Jonahss/openav1/docs/frame-state.md

# Frame state on the card (the frame-to-frame state machine)

2026-10-30. Jonah, on seeing that an inter stream on the U200 runs at the Python model's speed: "an inter frame decodes
on the card but python on the cpu is passing the outputs of one frame to the next and holding state. let's clean that up."
This note is the census of that state, the design that moves it onto the card, and the staged plan.

## 1. What the host hands the card per frame today (tb/host_regs.py decode_frames_inter)

| State (spec) | Produced by | Handed over as | Size at 1080p |
|---|---|---|---|
| CDF tables the frame starts with: load_cdfs(ref_frame_idx[primary_ref_frame]) with the counts zeroed (8.2) | the model's SequenceState: the CDFs saved by the frame that refreshed that slot (the tile context_update_tile_id's final CDFs, or the frame's initial ones if disable_frame_end_update_cdf) | DEF_ADDR/DEF_DATA, 1,269 rows x 246 bits, once per tile row | 40 KB |
| PrevSegmentIds: load_previous_segment_ids (7.20) | the model: the slot's saved map (per 4x4; verbatim copy of the previous map when segmentation_update_map = 0) | SP_ADDR/SP_DATA0/1 band writes, 16 ids per 48-bit word | 480 x 270 x 3 bits = 47 KB |
| MotionFieldMvs[ref][y8][x8]: motion_field_estimation (7.9) | the model: projection of up to 5 source slots' saved MVs (7.19: one {ref, mv} per 8x8 from the odd 4x4, first list with a negative relative distance and |mv| <= 4095) | MF_ADDR/MF_DATA entry writes | 7 refs x 240 x 135 entries |
| Reference pictures and their sizes / scales | the card's own flushed pictures in DDR (the model only for frames the image cannot take) | slot table 0x400.., REF_SLOT | addresses |
| OrderHints, refresh flags, segmentation flags | the frame headers (obu_parser) | header registers (ihdr_t) | - |

Only the first three need the model, and only because the card keeps no record of a finished frame beyond its pixels:
mv_mem and mi_store are superblock-row bands that the next rows overwrite, and the adapted CDFs stay inside the engine
that produced them. The pixels are the card's; the memory of the frame is the host's.

## 2. Design: the frame's state lives in DDR next to its picture, written and read by the card

A reference slot in DDR becomes {picture planes, MV sideband, segment-id sideband, CDF rows}. The host keeps only the
slot table (addresses, sizes, order hints), which it derives from the frame headers; nothing on the host decodes.

**Writers (frame end, per superblock row, as the syntax stage finishes it):**
- *MV sideband*: one 32-bit word per 8x8 {ref[2:0] (0 = none), mv_row[12:0], mv_col[12:0]} = the spec's
  MfRefFrames/MfMvs of 7.19, decided at write time from the block's (ref0, mv0) / (ref1, mv1): the first list whose
  reference has a negative relative distance (a 7-bit per-frame mask from the host, `ref_dist_neg`, in ihdr_t) and
  |mv| <= REFMVS_LIMIT. Captured from the mv_mem area fill at the odd 4x4 (2*y8+1, 2*x8+1) into a double-buffered
  superblock-row buffer (1080p: 8 x 240 words = 7.5 KB per row), DMA'd to the slot's MV area when the row is done.
- *Segment-id sideband*: 16 ids per 48-bit word (the seg_band word), from the block area fill; when
  segmentation_enabled && !segmentation_update_map the source is the previous map (seg_band) instead (test10147's rule).
- *CDF rows*: at tile_done of the frame, engine context_update_tile_id's cdf_store rows (1,269 x 32 B) to the slot's CDF
  area; with disable_frame_end_update_cdf the engine's def_mem (the frame's starting rows) instead.
All three go through the existing AXI write master in dec_host (the flush engine gains two requesters besides released
picture rows: "sideband row ready" and "CDF save").

**Loaders (frame start, driven by the sequencer like ref_fetch):**
- *CDF loader*: the primary slot's CDF area -> def_we rows into every engine, the count field of each row zeroed.
- *Segment-map loader*: the primary slot's seg area -> seg_band, one superblock row ahead of the syntax stage.
- *Motion-field projection engine* (7.9): for each source slot (LAST, BWDREF, ALTREF2, ALTREF, LAST2 by the spec's
  order and refStamp rule), read its MV sideband for the current 64-pixel row band (projection never leaves the band:
  MAX_OFFSET_HEIGHT = 0; columns move at most 8 x 8 px), project each entry with Div_Mult[refOffset] (a 32-entry ROM),
  clip, and write mf_band[dst][y8][x8] for the 7 destinations. 1080p: 1,920 entries x 5 sources x 7 destinations
  = 67 k operations per superblock row, one per cycle, against a ~370 k-cycle row decode: it runs a row ahead.
All reads go through the AXI read channels ref_fetch owns today (a second requester on its arbiter).

**Host after this:** parse headers, keep the slot table (a pool allocation with the refresh/show_existing rules of 7.20
and 7.21 as address bookkeeping), write ihdr/hdr registers, push bytes, collect pictures. tb/seq_model.py stays as the
model of what the card now does, and tb/test_dec_host_inter.py compares the card's sideband and CDF areas with it.

## 3. Stages and estimates (from the ring memory + flush and ref_fetch, each ~1 day of my own work)

- **Stage A (~2 days): the card writes, the host moves.** Sideband writers + CDF save/load through DDR; the host reads
  the sideband back over PCIe, runs the projection (seq_model.motion_field_estimation on the card's saved MVs, no tile
  decoding) and writes mf_band/seg_band as today. The model leaves the loop; inter streams run at card speed minus one
  PCIe round trip per frame. Verified by the twin (sideband == the model's saved arrays, CDF area == the model's saved
  CDFs), then gate replay, then the card image.
- **Stage B (~2.5 days): the card loads.** Segment-map loader, CDF loader, the projection engine; the host writes no
  bands. Same ladder.
- Stage A is realistic before the symposium (2026-11-04); Stage B is more likely the week after. The deck says which.

## 4. Stage B as built (2026-10-30 evening) and the projection engine's design

Built: `rtl/fs_load.sv` (segment map and CDF rows from the slot's areas into the bands, zero-map mode; START bit 6,
registers 0x700-0x714) and the CDF save in `dec_host.sv` (engine SV_ENG's rows through the read-back port to SV_CDF,
START bit 7). The twin's `TS_FSTATE_B=1` mode exercises both: the host writes no rows and no map. The read channel is
muxed between the loader and ref_fetch (the loader runs before the first tile, so the two never overlap).

**The projection engine (7.9), the last block.** The host already computes every distance the process needs (they are
functions of the order hints alone), so the engine takes a table, not the rules:
- per frame: `MF_DST[1..7]` = refToDst for each destination (signed 8), `MF_W8/H8` (from hdr), `MF_SRC_N` (0..5 sources
  in the spec's order: LAST, BWDREF, ALTREF2, ALTREF, LAST2 with the refStamp rule applied by the host; a source whose
  saved frame is intra, of another size, or whose distances fail the test is simply left out);
- per source s: `MF_SRC_BASE/ROWB` (the slot's MV area), `MF_SRC_SIGN` (dstSign), `MF_SRC_TOCUR` (refToCur, signed),
  `MF_SRC_OFF[1..7]` (refOffset for each saved reference, signed; the engine tests |x| <= 31 and > 0 itself).
- the job: clear the field (every (dst, y8, x8) invalid: w8 x h8 x 7 writes; 1080p 227 k cycles, 2.3 ms; a per-row
  valid bitmap would remove it later), then for each source in order read its MV area line by line and, per word,
  if ref != 0 and the distance test passes: projMv = mv_projection(mv, refToCur * sign, refOffset); (PosY8, PosX8) from
  block_position (row offsets never leave the 64-pixel band; columns within 8 units); if valid, write
  mf[dst][PosY8][PosX8] = mv_projection(mv, refToDst[dst], refOffset) for dst = 1..7, seven writes a cell (one
  multiplier per destination, Div_Mult a 32-entry ROM, round2signed and the clips in logic). Raster order, so a later
  cell's write wins at a shared target, as the scalar code and _project_np do.
- cost: reads 1080p: 5 sources x 32 k words = 160 k beats; writes up to 7 per valid cell; at one cell a cycle the
  whole field is ~0.5 M cycles worst case, 5 ms at 100 MHz, overlapping nothing today (it runs before the first tile)
  and later the previous frame's filters.
- verification: the twin in B mode stops writing the motion field; the pictures stay identical (every temporal
  candidate goes through this band), and a read-back path for mf_band compares the field with _project_np directly.

## 5. The host path for stage B (2026-10-31, `decode.py --card-load`)

`decode_frames_inter(card_load=True)` (implies `card_state`) is stage A's loop with the per-frame state traffic
removed. The host keeps only the slot table: for each of the 8 slots, the header fields the projection table needs
(`mf_table`: frame type, size, order hints) and `Slot.areas` = where the card keeps that frame's state (its MV and
segment-id sideband areas, its saved CDF rows, or `('defaults', base_q_idx)` for a frame that disabled the frame-end
update and started from defaults). Per frame:

1. `start_frame_load`: the primary reference slot's areas decide the loader's job (segment map if the frame uses
   segmentation and the slot's map is its size, else a zero map for inter frames; the CDF rows unless the slot holds
   defaults, which the host writes as before, `rows=M.default_rows(q)`); `mf_table` builds the projection table from
   the order hints (empty for a frame without a usable source, which still clears the band).
2. `frame_state_load`: frame header registers (the loader and the engine take `mi_rows` / `mi_cols` from `HDR`), the
   LD / MF registers, START bit 6, poll `FS_STATUS` bit 3. Then the reference table, DMA + sideband registers and the
   pipelined frame start as in stage A; the tile rows run with `rows=False` (no CDF writes).
3. After the context tile's row: `frame_state_save` (SV registers, START bit 7, poll bit 6) into the frame's own CDF
   area (`fs_layout` puts it behind the segment ids), unless `disable_frame_end_update_cdf`.
4. Frame end: wait for the sideband DMA, `end_frame_load` records the areas for the refreshed slots with 7.20's two
   rules (a verbatim-kept segment map and a disabled CDF update both pass the primary slot's area on).
   Because areas are passed on, a slot can name areas inside another frame's buffer: the flush target is a buffer
   no live slot holds *either the picture or the state areas of* (2026-11-01: test5439 frame 8 took frame 0's buffer and
   saved its rows over the areas slots 0-6 still named; frame 9 then loaded frame 8's state, 1,604 samples off by one).

Register traffic per 1080p inter frame drops from ~500 k writes (motion-field band 227 k, CDF rows 13.5 k, segment map
8 k, plus the 1501-row read-back) to the frame's own headers and ~40 loader / table words. The stage A path
(`--card-state`) stays as the fallback and the cross-check: both must produce identical pictures.

## 6. The loader group's throughput (2026-11-03)

The 1080p measurement (`docs/reference-prefetch.md` §3) found the stage B loader group past 460k cycles a frame:
5 ms at 100 MHz, 15 % of a 33 ms frame, all of it before the first tile. Three terms, all in the first version of
the engines:

- the field clear wrote one entry a cycle: 7 x w8 x h8 = 227k cycles at 1080p;
- each valid cell took 11 cycles (test, projection, position, seven destination writes one after another): up to
  356k cycles a source when most cells carry a reference;
- the reads of both engines went one burst at a time: ~64 cycles per 16 beats at the card's latency, 65k cycles a
  source for the MV words, the same for a 1080p segment map (16k beats).

What changed:

- `mf_band` holds one memory per reference (`we[6:0]`, `w_row` / `w_col` per reference), so one write touches every
  reference of a position: the host's register path writes one (`we = 1 << ref`), the engine all seven. Same BRAM.
- `mf_project` clears the field at one position a cycle (w8 x h8 = 32k cycles at 1080p) and starts with `ld_start`, so
  the clear overlaps `fs_load`'s reads (`src_go = !fsl_busy` holds its reads until the channel is free; `dec_top`
  muxes the read channel fs_load → engine → ref_fetch). The reads run `OUT = 8` bursts ahead into a 32-beat FIFO
  whose room is reserved at issue (`rready` never drops). The cells go through a six-stage pipeline at one a cycle:
  the source's constants and posValid; K = clip3(-31, 31, num) x Div_Mult[den] for the current frame and the seven
  destinations (the product is associative, so this is the spec's arithmetic exactly); the sixteen products mv x K;
  round2signed and the clip; block_position; the seven-reference write. Raster order is kept, so a later cell still
  wins at a shared target.
- `fs_load` issues up to `OUT = 8` bursts ahead through a descriptor queue `{job, line, first beat}`; the data side
  takes the in-order beats straight into the bands, as before.

Expected at 1080p with 48-cycle reads: clear 32k (hidden behind the segment map / CDF load), ~16k + 32k cycles a
source (reads, then cells; the two overlap), segment map ~17k, CDF rows ~6k: a P-frame with one source ~60k
cycles, 0.6 ms, from ~500k. `test_dec_host_inter` reports the loader group's wait as `ld_cycles` in its summary.
