Jonahss/openav1/docs/checkpoints/C10-layout.png

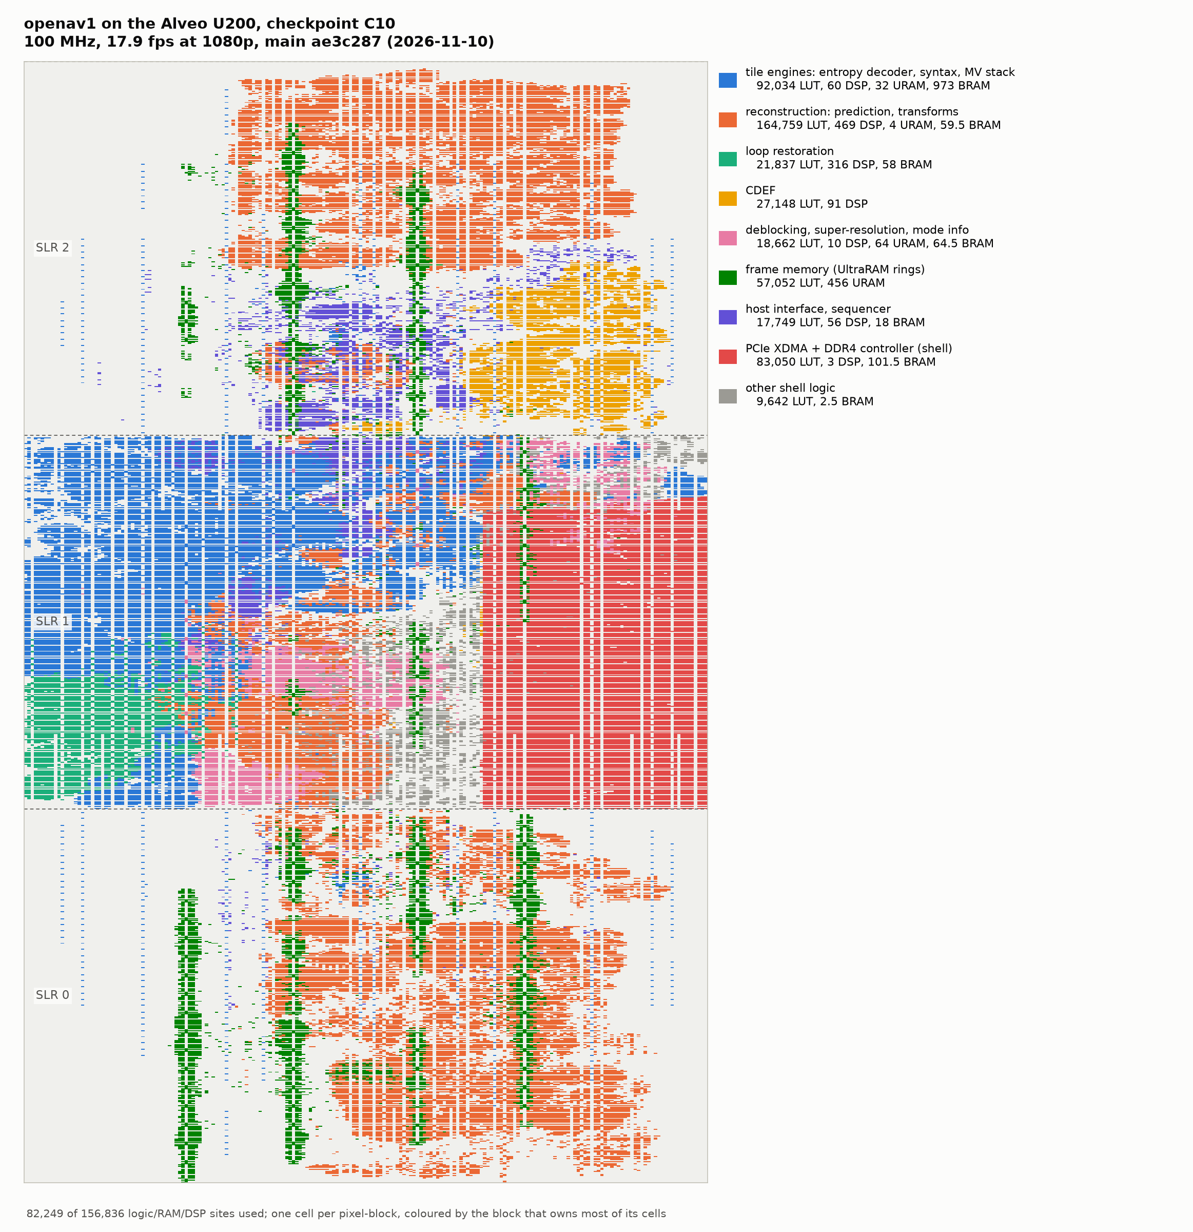
docs/checkpoints/C10-layout.png
