Jonahss/openav1/docs/checkpoints/C11-layout.png

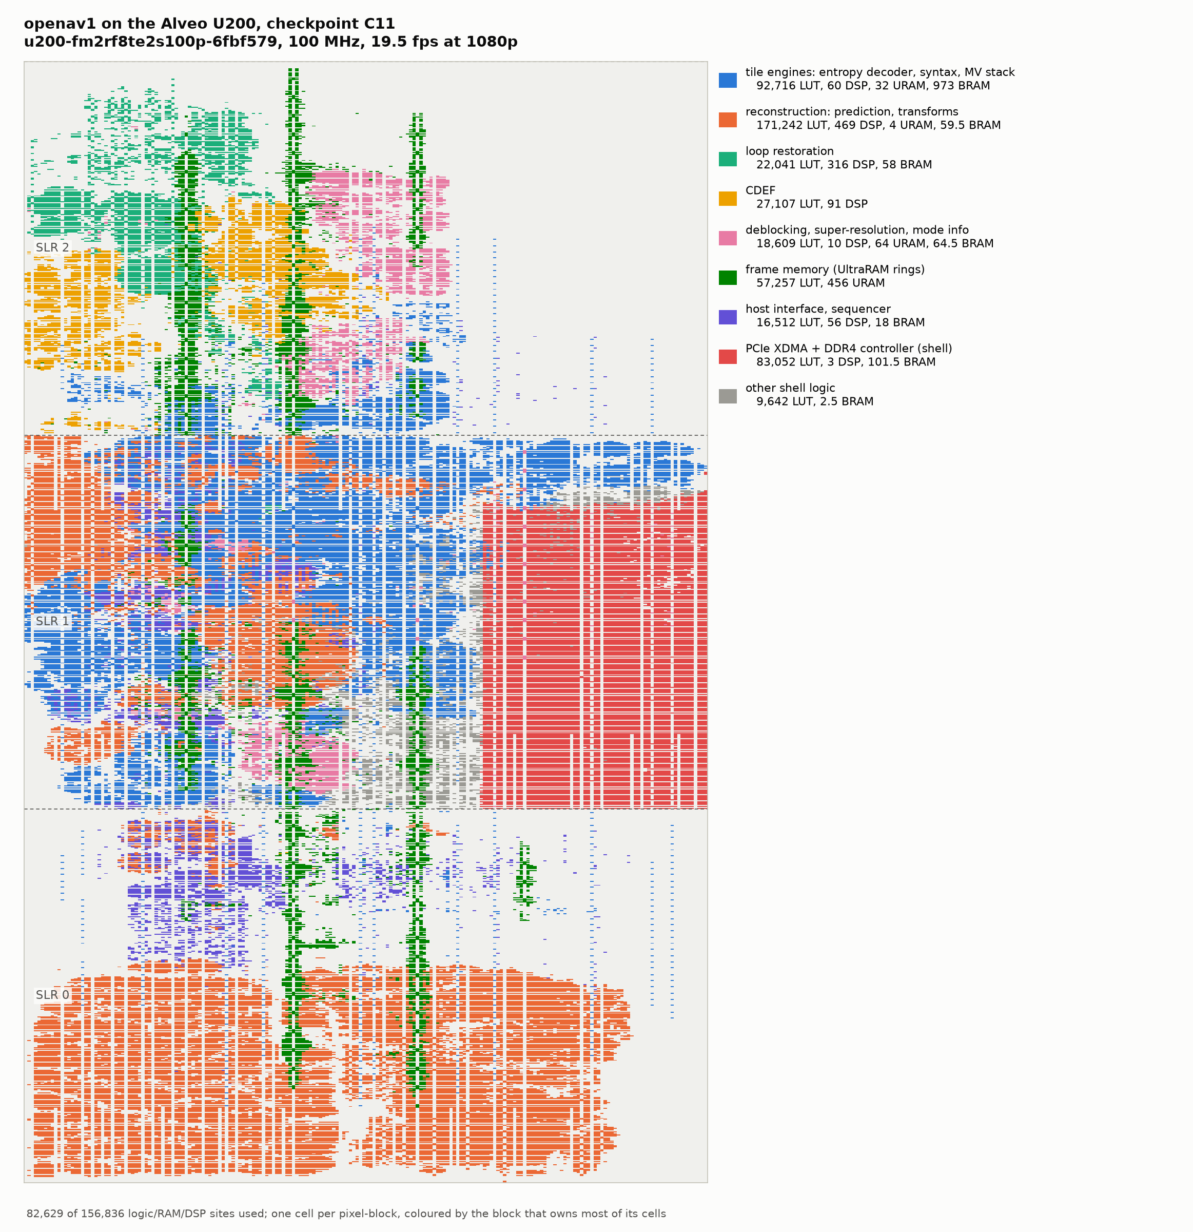
docs/checkpoints/C11-layout.png
