Jonahss/openav1/docs/checkpoints/C12-layout.png

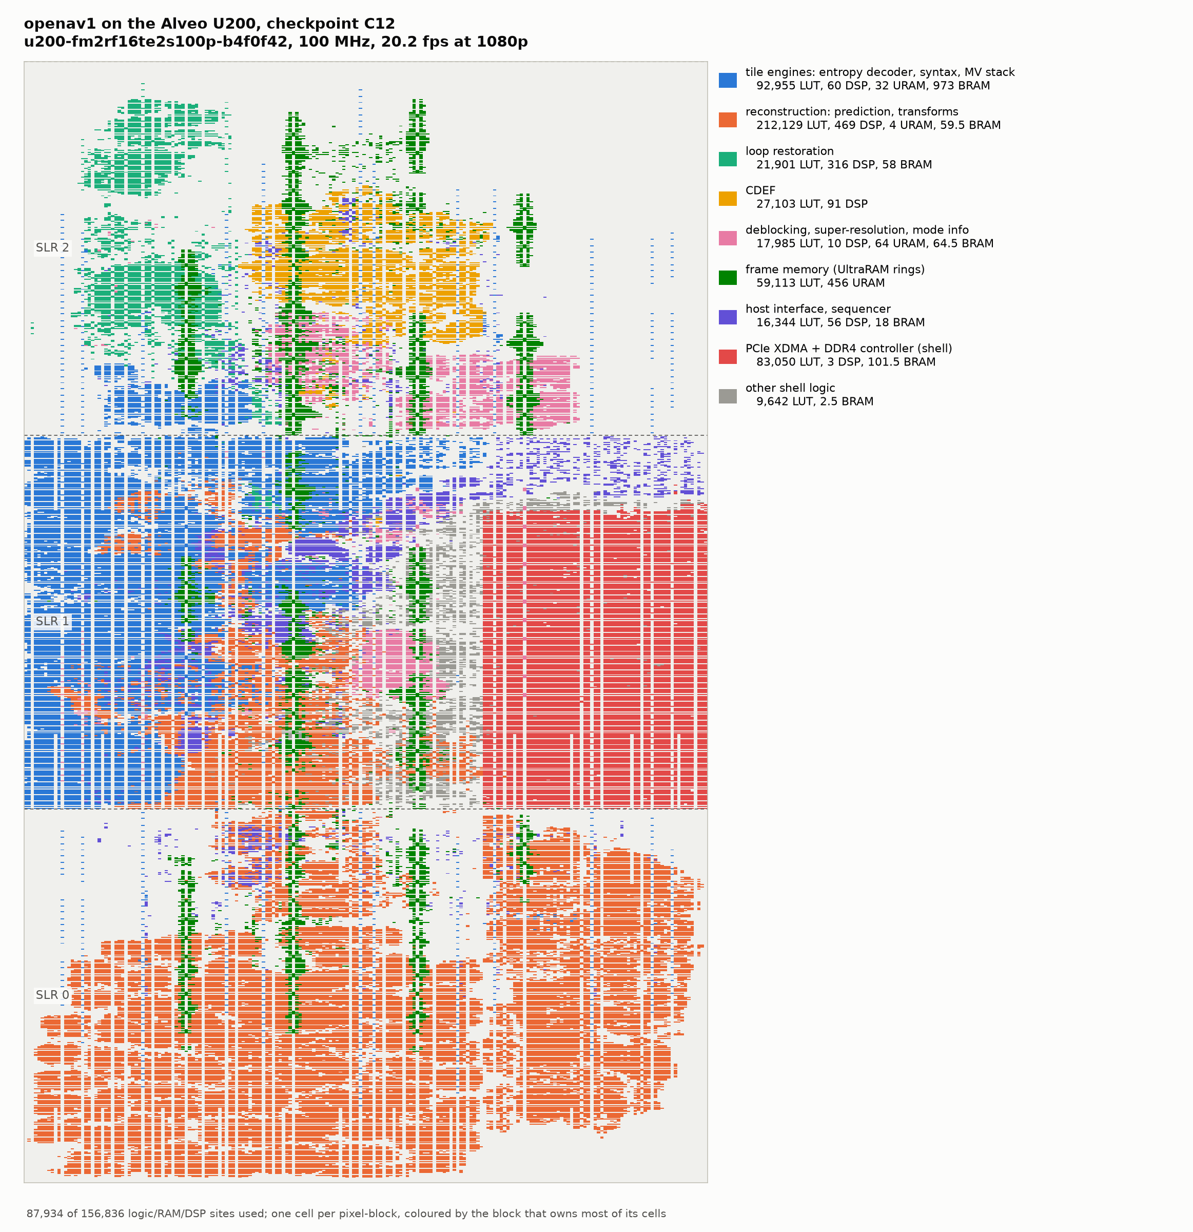
docs/checkpoints/C12-layout.png
