Jonahss/openav1/docs/checkpoints/C13-layout.png

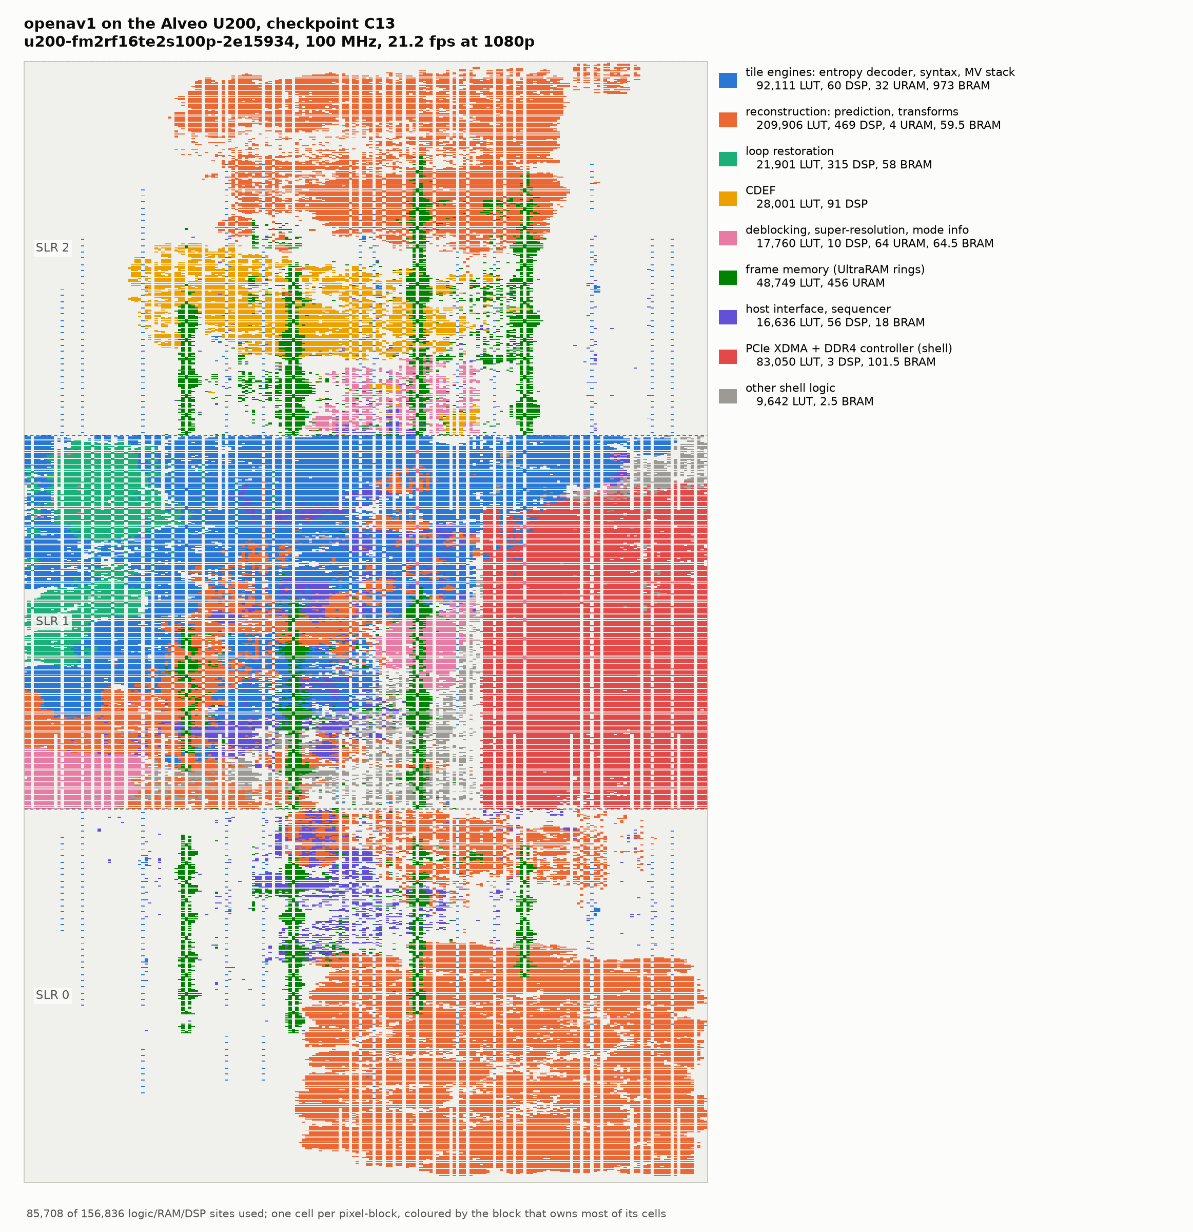
docs/checkpoints/C13-layout.png
