Jonahss/openav1/docs/checkpoints/C14-layout.png

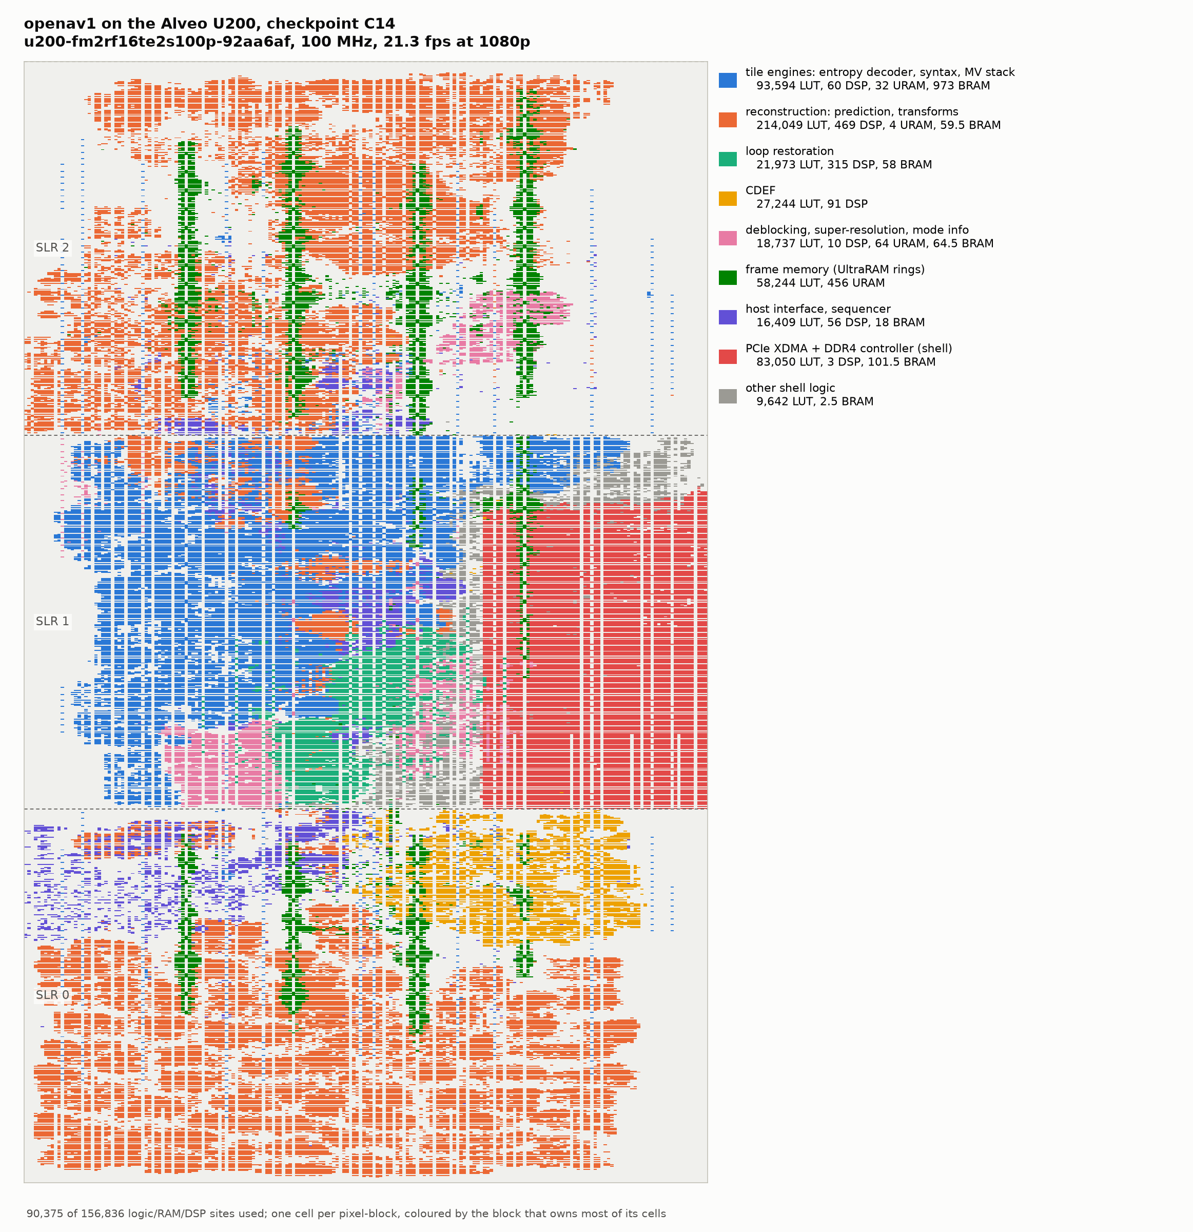
docs/checkpoints/C14-layout.png
