Jonahss/openav1/docs/checkpoints/C15-layout.png

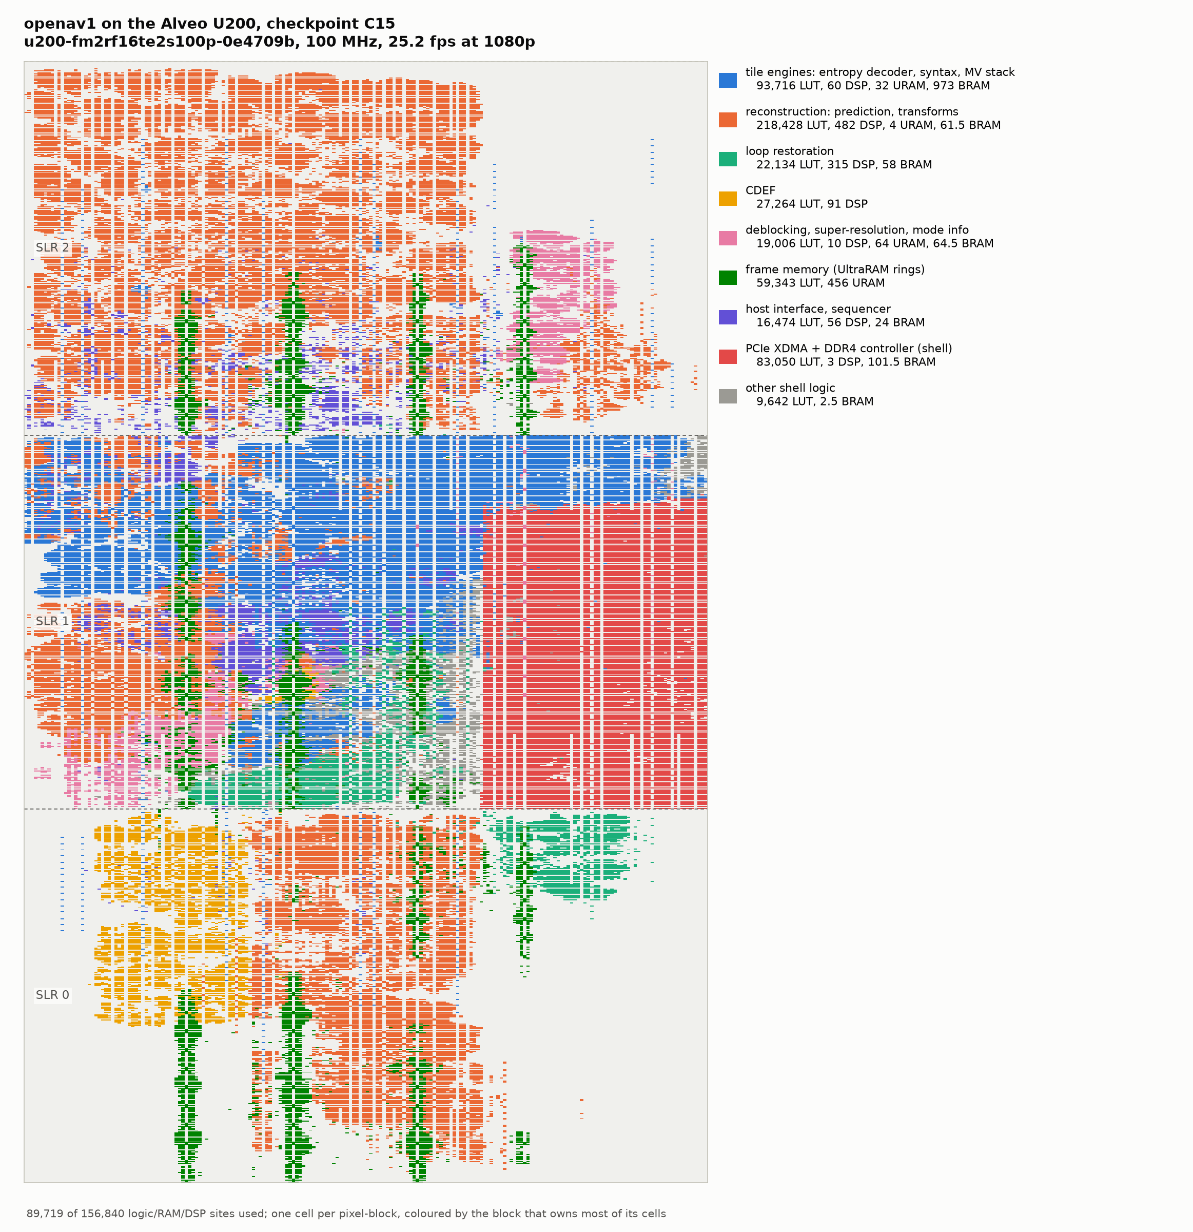
docs/checkpoints/C15-layout.png
