Jonahss/openav1/docs/checkpoints/checkpoints.csv

id | date_pt | fps_unchecked | fps_checked | identical | clock_mhz | image | commit | lut_pct | ff_pct | bram_pct | uram_pct | dsp_pct | layout | label | what_changed
C01 | 2026-10-30 21:57 |  | 1.2 | 500/500 | 100 |  |  |  |  |  |  |  |  | 24;5;start;first full clip on the card | first full 548-frame decode; the host loads every frame's state through registers
C02 | 2026-10-31 02:24 |  | 3.0 | 500/500 | 100 |  |  |  |  |  |  |  |  | -4;-52;start;frame state kept on the card | the card loads and saves its own frame state (stage B)
C03 | 2026-11-02 08:48 |  | 3.5 | 500/500 | 100 | u200-fm2s100p-0fd3b46 | 0fd3b46 | 26.27 | 6.69 | 38.96 | 56.15 | 12.30 |  |  | raw-row read-back on the host
C04 | 2026-11-03 16:11 |  | 6.9 | 500/500 | 100 | u200-fm2pfs100p-91c481f | 91c481f | 29.85 | 6.87 | 38.96 | 56.15 | 12.62 |  |  | reference prefetch
C05 | 2026-11-03 19:49 |  | 9.2 | 500/500 | 100 | u200-fm2pfbte2s100p-fc34a84 | fc34a84 | 33.58 | 7.56 | 64.31 | 57.92 | 13.04 |  |  | block-ahead prefetch and a second tile engine
C06 | 2026-11-03 20:09 |  | 10.0 | 500/500 | 100 | u200-fm2mfs100p-0890cc6 | 0890cc6 | 29.63 | 7.01 | 36.18 | 56.25 | 13.19 |  | -14;-50;end;reference prefetch, second tile|engine, faster state loading | faster motion-field loader and burst CDF save
C07 | 2026-11-04 11:20 |  | 11.8 | 500/500 | 100 | u200-fm2rf8s100p-6b16192 | 6b16192 | 31.72 | 7.16 | 36.20 | 56.25 | 13.20 |  | 10;-30;start;shorter reference queue | reference ring of 8
C08 | 2026-11-09 04:06 |  | 12.8 | 500/500 | 100 | u200-fm2rf16s100p-40872d2 | 40872d2 | 34.97 | 7.50 | 36.02 | 56.35 | 13.19 |  |  | filter passes pipelined (one tile engine image)
C09 | 2026-11-10 05:23 |  | 14.8 | 500/500 | 90 | u200-fm2rf8te2s90p-86c2847 | 86c2847 | 35.81 | 7.96 | 59.12 | 57.92 | 14.69 |  | -12;-48;end;filter: two patch words and two|vertical groups a cycle (90 MHz) | two patch words and two vertical groups a cycle (rungs A and B); kept on the card as u200-fm2rf8te2e90p-d3ba9fd after the run-record fix
C10 | 2026-11-10 20:52 | 17.9 | 16.3 | 500/500 | 100 | u200-fm2rf8te2s100p-88e3499 | 88e3499 | 35.59 | 7.97 | 59.12 | 57.92 | 14.69 | C10-layout.png | 16;28;start;timing fixes: back to 100 MHz | four registers on old paths; 100 MHz closes with 0 failing endpoints
C11 | 2026-11-11 15:38 | 19.5 | 17.4 | 500/500 | 100 | u200-fm2rf8te2s100p-6fbf579 | 6fbf579 | 35.95 | 7.98 | 59.12 | 57.92 | 14.69 | C11-layout.png | 16;20;start;CDEF copies a group a cycle | CDEF copied unfiltered blocks at three cycles a group (86 % of its cycles); now one a cycle; two timing registers (segmentation band and warp setup)
C12 | 2026-11-12 02:21 | 20.2 | 18.0 | 500/500 | 100 | u200-fm2rf16te2s100p-b4f0f42 | b4f0f42 | 39.05 | 8.32 | 59.12 | 57.92 | 14.69 | C12-layout.png |  | the reference-fetch ring goes from 8 to 16 line buffers; it needed two timing fixes to close at 100 MHz (a local copy of the 2x-clock phase in the frame memories and a capture register in the motion-vector stack)
C13 | 2026-11-12 15:22 | 21.2 | 18.8 | 500/500 | 100 | u200-fm2rf16te2s100p-2e15934 | 2e15934 | 38.43 | 8.31 | 59.12 | 57.92 | 14.68 | C13-layout.png |  | the coefficient reader took ten cycles a coefficient on the big coded frames; the scan position is now read one ahead and a zero coefficient takes one cycle in the sign pass (step 1 of 2)
C14 | 2026-11-12 20:25 | 21.3 | 18.9 | 500/500 | 100 | u200-fm2rf16te2s100p-92aa6af | 92aa6af | 39.18 | 8.32 | 59.12 | 57.92 | 14.68 | C14-layout.png |  | step 2 of the coefficient reader: a level of 0 to 2 is stored in the cycle its symbol arrives (three cycles a coefficient in the level pass)
C15 | 2026-11-13 16:04 | 25.2 | 21.8 | 500/500 | 100 | u200-fm2rf16te2s100p-0e4709b | 0e4709b | 39.52 | 8.32 | 59.49 | 57.92 | 14.87 | C15-layout.png | 16;-14;start;shorter filter tail | the picture flush to memory streams a sample group a cycle and does not wait for each burst's response; deblocking of a superblock row starts when the row is decoded instead of a row later (intra prediction reads an unfiltered copy of the row's last line): the filter tail falls from 7.7 to 4.0 ms a frame and the tile phase from 39.1 to 35.7 ms
