Jonahss/openav1/docs/kv260-bringup.md

# KV260 bring-up: the core decoder as a bitstream

Status (2026-10-14): **the core decoder decodes on the board, bit-exact.** First bitstream (50 MHz decoder /
100 MHz memory, 99.5k LUT, 40 URAM, WNS +0.7 ns; with the packed reads 99.8k LUT, WNS +2.4 ns): seed 1 and seeds 2-7 (4:2:0 / 4:4:4 / mono, 8/10/12-bit,
a four-tile frame, loop filter on) replayed through the register file with 0 mismatches over 126,976 pixels;
then the libaom-encoded natural pictures `streams/synth/natural_lf_only_{8,10}bit.ivf` (384 x 256, two frames
each) identical to dav1d's output: 589,824 pixels, 0 mismatches, 13 s for 1.2 M register operations from Python.
Two board-only lessons, below.

**80 MHz (2026-10-14 evening):** with the two-stage msac, the predictor's address lookahead and the write-address
precompute, the bitstream closes timing at 80 MHz (`KV260_MHZ=80`, decoder clock 80 / memory 160 MHz, +0.007 ns on
the decoder clock, 102.5k LUT) and the 120-frame clip decodes bit-exact at **86 fps end to end** (1.4 s), 67 fps with
the screen blit. The clocks come from a hand-instantiated MMCM (below), not the clock wizard.

## What is in the bitstream

`fpga/kv260/build.sh` builds a block design (`build.tcl`) for the Kria K26 (xck26-sfvc784-2LV-c):

- `zynq_ultra_ps_e`: only HPM0 FPD (32-bit AXI master), `pl_clk0` and `pl_resetn0`. The PS is configured by the
  boot firmware; the bitstream is loaded under a running Linux, so nothing else of the PS matters here.
- `clkgen` (`clkgen_v.v`, written by `build.tcl`): an `MMCME4_ADV` instantiated by hand from `pl_clk0`, pinned to
  exactly 100 MHz (IOPLL / 15), with the dividers computed for the requested `KV260_MHZ`: VCO = 100 x m, `clk` =
  VCO / 2d, `clk2x` = VCO / d, so the two are exactly 2:1 and edge-aligned. The clock wizard is not used: asked for
  80 / 160 MHz it generated 80.0 / 161.1 (M = 14.5, /18.125, /9) and ignored `OVERRIDE_MMCM`; the 50 MHz builds were
  2:1 by luck (/22, /11). The double-pumped frame memory and the two-cycle crossing constraints both need the exact
  ratio, and the symptom of the wrong one was crossing paths timed over 6.4 ns instead of 12.5.
- `phase_gen` (`rtl/phase_gen.sv`): the frame memory's phase flag, a clk2x toggle aligned by the clk reset.
- `dec_host` (`rtl/dec_host.sv`, through the Verilog shell `dec_host_v.v`): the AXI-Lite register file around
  `dec_top` in the core configuration (FBX = FBY = 9, two transform lanes, `FRAME_URAM = 1`; CDEF and LR are null
  stubs, super-resolution is not run). At 0xA000_0000, 4 KB. The register map is in the header of `dec_host.sv`.
- `smartconnect` between the two, `proc_sys_reset` for the resets.

Constraints: `sys.xdc` (clk <-> clk2x multicycles by the MMCM output pins) and `pre_opt.tcl` (the URAM -> clk2x
multicycle and the phase generator's one-period alignment path; both need post-synthesis cells, so they run as the
`opt_design` pre-hook). Same relationships as `synth/vivado/synth.tcl` + `impl.tcl` use out of context.

## Driving it

Software talks to the register file as `tb/test_dec_host.py` does: headers (`hdr_t`, `rec_hdr_t`, `lf_hdr_t`
packed little-endian into the 16-word windows), the CDF default rows (8 data words + the address write that
strobes `def_we`), `START.tile`, the tile bytes into the FIFO (`DATA4`, free count in `STATUS[31:16]`), `CTRL.eos`,
poll `STATUS.tile_done_lvl`; then `START.lf` and poll `STATUS.lf_done`; then the picture through `HADDR` and the
data registers. That sequence lives once, in `tb/host_regs.py` (no simulator dependency: the register map, the
header packing and `HostDecoder`), and the test and the board driver both use it.

**Stream in, picture out, on the board:** `tools/host/decode.py` parses the stream on the PS (`tb/obu_parser.py`)
and runs `HostDecoder` over `/dev/mem`:

```
sudo tools/host/decode.py streams/synth/natural_lf_only_8bit.ivf -o out.yuv --ref refout/natural_lf_only_8bit.yuv
```

writes the shown frames in dav1d's raw layout and, with `--ref`, compares every sample against dav1d's output
(`refout/` is not in git: copy the `.yuv` files over). The core build decodes intra streams without CDEF and loop
restoration (`aomenc --enable-cdef=0 --enable-restoration=0`); the driver says so when a stream needs them.
2026-10-14: `natural_lf_only_{8,10}bit` and `natural_lossless_8bit` (384 x 256, two frames each) identical to dav1d.
Sample by sample the read-back cost three bus transfers per sample, 1.6 s a frame and 94 % of the run; the packed
reads (`HDATA4`: four 8-bit samples a word, `HDATA2`: two 16-bit lanes, the address advancing by itself, one `HADDR`
write per row) bring it to 0.20 s (8-bit) / 0.34 s (10-bit) a frame. A 120-frame all-intra 352 x 288 clip
(`aomenc --kf-max-dist=0 --enable-cdef=0 --enable-restoration=0`) decodes bit-exact in 49.5 s (was 228 s): 2.4 fps,
nearly all of it the PS driving the register file from Python (~0.1 s a frame of header / CDF-default / tile-byte
writes, ~0.3 s of pixel reads at ~7 us a transfer). The decoder itself waits on the host most of the time; the
DMA path (stream and picture in the PS's DDR) is the next host step.

**Picture DMA (2026-10-14):** `dec_host` has an AXI4 write master (64-bit data, 40-bit address) on the PS's
`S_AXI_HP0_FPD`: after a frame, software programs the plane bases / strides / sizes (registers 0x180-0x1BC, the map
in `rtl/dec_host.sv`) and starts the engine, which reads four samples a clock from the frame memory and writes the
picture in dav1d's planar layout (strides rounded up to 8 bytes) in INCR bursts of up to 16 beats. `decode.py --dma`
uses the DisplayPort framebuffer's spare lines as the target (`/dev/fb0` is a contiguous uncached CMA buffer whose
physical address `FBIOGET_FSCREENINFO` reports; the kernel refuses `/dev/mem` on RAM and hides DRM buffers' pages
from pagemap, so this is the one buffer root can both address and read without a driver). `--show` converts each
8-bit 4:2:0 picture to RGB565 into the visible lines (C, `hl_yuv420_rgb565`). The 120-frame clip: 3.6 s = 33 fps
end to end through the DMA, 4.9 s with the dav1d compare, 7.1 s with the screen blit (the PS reading uncached
memory; moving the conversion into the PL or using a DRM YUV plane is the next display step).

**1080p on the board (2026-10-17):** the window build (`KV260_FBX=11 KV260_FBY=11 KV260_WIN=3`, 50 MHz,
103.9k LUT, 50 UltraRAM, +1.9 ns of slack; `docs/frame-memory.md`) decodes `streams/demo/testsrc2_1080p_20f_core.ivf`
bit-exact against dav1d: 20 of 20 frames identical, 15.8 s for the run with the compare (tiles 0.15 s, read-back
0.20 s a frame). At 80 MHz the same build misses timing by 1 ns under Vivado's default strategy (the window line
mapping at the end of the reconstruction's coordinate path, 39 logic levels) and closes with 38 ps to spare under
`KV260_STRATEGY=Performance_ExtraTimingOpt`; that bitstream decodes the same stream bit-exact in 10.9 s with the
picture on the screen. After the 2026-10-18 timing pass (`docs/frame-memory.md`, "Timing at 80 MHz": the window address, the edge-gather limits, the
palette sort, the intra predictor's edge-bank writes and the residual add) the 80 MHz window build closes under the default
strategy (WNS +0.051 ns, no failing endpoint) and decodes 1080p 20/20 and foreman 120/120 bit-exact in the same 10.9 s /
4.2 s; `fw-t80c` on the board. The framebuffer's spare lines are too small for a 1080p picture, so the DMA target is a region the
kernel never sees: the board boots with `mem=3584M` (a `boot.scr` with that in `bootargs`; the 512 MB from
0x8_6000_0000 are then free) and `decode.py --window --dma-base 0x860000000 --dma-size 0x20000000` maps it through
`/dev/mem`. The first run read back only the stale bytes already in that memory: the decoder had put the right
40-bit address on the bus, but the block design had no segment for it (see the lesson below).

**Transcript replay** (no parser on the board, the expected pixels recorded by the simulation):
`TS_TRANSCRIPT=<file> python tb/runner.py dec_host` (with `FBX=9 FBY=9 ITX_LANES=2 FRAME_URAM=1 TS_STAGE=lf`)
records every register write, every poll and the expected value of every read, and `tools/host/play.py <file>`
replays it over `/dev/mem` and reports mismatches.

## Board lessons (2026-10-14)

- **The block design's memory map comes from the PS IP's DDR geometry, not from the board.** The firmware
  programs the controller, but Vivado's default `zynq_ultra_ps_e` (2 Gbit x8 devices: 2 GB) offers only
  `HP0_DDR_LOW`, and `assign_bd_address ... HP0_DDR_HIGH` quietly finds no segment (`WARNING: [BD 5-699]`), so a
  write above 4 GB reaches nothing and nobody reports it. `build.tcl` now sets the K26's geometry (8 Gbit x16,
  64-bit bus, from the `kv260_som` board preset) and the high segment appears at 0x8_0000_0000. Check the build
  log for both `HP0_DDR_LOW` and `HP0_DDR_HIGH` being assigned.
- **The PS port width is the boot firmware's, not the bitstream's.** The K26 firmware's psu_init sets
  `FPD_SLCR.AFI_FS` (0xFD615000, bits [9:8] HPM0, [11:10] HPM1) to 128 bits. A PL built for a 32-bit HPM0 only
  sees byte lane 0: registers at offsets 4, 8, 12 mod 16 read 0 and ignore writes. The design now asks for
  128 bits (`PSU__MAXIGP0__DATA_WIDTH 128`; the smartconnect narrows to the AXI-Lite slave). Runtime check /
  workaround for an old bitstream: read the register; clearing bits [9:8] switches HPM0 to 32 bits until reboot.
- **One register write must be one bus transfer.** Through `/dev/mem`, Python's `struct.pack_into` issues three
  stores per 32-bit word and a slice assignment two (measured with the FIFO's free count); only
  `ctypes.c_uint32(...).value = v` is a single store. The split writes each pushed a junk word into the tile FIFO
  and the entropy decoder diverged gracefully (small errors first, garbage later; identical at a slower clock,
  which is how it was told from a timing problem). `play.py` uses ctypes; `dec_host` drops a push whose write
  strobe is not the whole word and sets STATUS bit 14.

## Loading on the board

`build.sh` leaves `fw/openav1/` with `openav1.bit.bin` (bootgen), `openav1.dtbo` (from `openav1.dts`: programs the
PL, releases the PL resets, enables `pl_clk0` at 100 MHz) and `shell.json`. On the KV260 (Ubuntu, `xmutil`):

```
sudo mkdir -p /lib/firmware/xilinx/openav1 && sudo cp fw/openav1/* /lib/firmware/xilinx/openav1/
sudo xmutil unloadapp; sudo xmutil loadapp openav1
sudo tools/host/play.py host-seed1.txt
```

With the first bitstream (32-bit port), first `devmem`-style clear bits [9:8] of 0xFD615000 (see above).

(`xmutil listapps` shows it; `dmesg` shows the FPGA manager load. Without `xmutil`: `fpgautil -b openav1.bit.bin
-o openav1.dtbo`.)
