Jonahss/openav1/rtl/recon_top.sv

// Intra reconstruction stage: consumes the syntax decoder's block records (blk_info / blk_rec), transform-block
// records (tx_done / tx_rec + Quant through q_addr/q_data, acknowledged with tx_ack) and palette colour maps
// (pm_*), and produces the pre-loop-filter picture in the frame buffer (fb_*), following spec 7.11 / 7.12:
//   per transform block, in order:  prediction  ->  dequant -> inverse transform -> add  ->  BlockDecoded update
//     prediction = palette (7.11.4) | edge preparation (7.11.2.1, reads the frame buffer) + ipred (7.11.2)
//                  [+ CfL (7.11.5): load the reconstructed luma region and the DC prediction, run cfl]
// Slow-and-correct first version: one pixel (or one coefficient) per cycle or two, no overlap between stages.
// Events arrive through rec_fifo in decode order (superblock start, block record, transform blocks); a
// transform block is popped only once it is fully written, so its coefficient slot stays valid until then.
//
// State kept here: BlockDecoded flags per plane for the current superblock (cleared on sb_start, 5.11.3),
// MaxLumaW/H, and a per-4x4 map of {uvmode, ymode} for the tile (get_filter_type needs the neighbours'
// modes with the chroma position adjustments of 7.11.2.8; a frame-wide map is the simple, obviously right
// choice — the loop filter will need per-4x4 frame state anyway).
module recon_top
  import blk_tables_pkg::*;
  import tx_tables_pkg::*;
  import q_tables_pkg::*;
  import syn_pkg::*;
  import mc_tables_pkg::*;
#(
    parameter int FBX = 9,                   // frame buffer x address bits
    parameter int ITX_LANES = 4,             // 1-D transform engines (rows, then columns, at once): 4 for throughput, 2 fits the K26
    parameter int INTER = 1,                 // 0: no inter prediction (ref_fetch / mc_filt / warp_setup left out, inter blocks never
                                             //    dispatched): the intra-only board build (the K26 does not hold inter)
    parameter int FBY = 9,
    parameter int ML2R = 8,                  // mode map capacity: log2(MI rows), log2(MI cols)
    parameter int ML2C = 8,
    parameter int FRAME_WIN = 0,              // window build: superblock rows of the fb0 ring (0 = the whole picture); an intra
                                             //    block copy source row still in the ring is read from fb0, an older one from DDR
    parameter int REF_RING = 16              // ref_fetch line buffers: reference rows in flight ahead of the writer (16 for
                                             //    speed on one engine; 8 closes two engines at 100 MHz on the U200, 2026-11-08)
) (
    input  logic        clk,
    input  logic        rst,
    input  hdr_t        hdr,
    input  rec_hdr_t    rh,
    // from the event queue (rec_fifo): head event, popped when consumed
    input  logic        ev_valid,
    input  logic [1:0]  ev_kind,              // 0 transform block, 1 block record, 2 superblock start
    input  logic [MIW-1:0] ev_sb_r, ev_sb_c,
    input  blk_rec_t    ev_blk,
    input  tx_rec_t     ev_tx,
    output logic        ev_pop,
    output logic        tx_rel,               // a transform block is fully written (R_MIW): its coefficient slot is free
    output logic [2:0]  q_slot,
    output logic [9:0]  q_addr,
    input  logic signed [20:0] q_data,
    output logic        pm_plane,
    output logic [5:0]  pm_x, pm_y,
    input  logic [2:0]  pm_idx,
    output logic        busy,
    // per-4x4 state for the in-loop filters (mi_store write ports)
    output logic        mi_blk_we,
    output logic [MIW-1:0] mi_blk_r, mi_blk_c,
    output logic [5:0]  mi_blk_bw4, mi_blk_bh4,
    output mi_lf_t      mi_blk_data,
    input  logic        mi_blk_busy,
    output logic        mi_tx_we,
    output logic [1:0]  mi_tx_plane,
    output logic [MIW-1:0] mi_tx_row, mi_tx_col,
    output logic [4:0]  mi_tx_w4, mi_tx_h4,
    output logic [4:0]  mi_tx_sz,
    input  logic        mi_tx_busy,
    output logic        mi_cd_clr,             // superblock start: clear the superblock's cdef_idx unit(s)
    output logic        mi_cd_we,              // block with a coded cdef_idx: set the covered unit(s)
    output logic [SBW-1:0]  mi_cd_row64, mi_cd_col64,
    output logic [3:0]  mi_cd_mask,
    output logic [2:0]  mi_cd_idx,
    // frame buffer (single port, registered read)
    output logic        fb_re,
    output logic        fb_we,
    output logic [1:0]  fb_plane,
    output logic [FBX-1:0] fb_x,
    output logic [FBY-1:0] fb_y,
    output logic [11:0] fb_wdata,
    input  logic [11:0] fb_rdata,
    input  logic [47:0] fb_rdata4,            // aligned group of 4 samples containing fb_x (with fb_re)
    // frame buffer write port (all of this stage's writes; fb_we stays 0)
    output logic        fb2_we,
    output logic [1:0]  fb2_plane,
    output logic [FBX-1:0] fb2_x,
    output logic [FBY-1:0] fb2_y,
    output logic [11:0] fb2_wdata,
    // frame buffer 4-wide write port (prediction and residual-add output, aligned groups of 4)
    output logic        fb4_we,
    output logic [1:0]  fb4_plane,
    output logic [FBX-1:0] fb4_x,
    output logic [FBY-1:0] fb4_y,
    output logic [47:0] fb4_wdata,
    output logic [3:0]  fb4_be,               // lane enables of the 4-wide write (inter prediction units 2 samples wide)
    // ---- inter prediction (stage 2a, docs/inter-syntax.md / the design note §8): the inter header, the reference
    //      slot table (software: REF_SLOT, the slots' plane bases / strides / sizes) and the AXI read master of ref_fetch
    input  ihdr_t       ihdr,
    input  logic [20:0] ref_slot,             // slot of LAST_FRAME + i at [3i +: 3]
    input  logic [1727:0] ref_planes,         // slot s, plane p: {stride[31:0], base[39:0]} at [72 (3s + p) +: 72]
    input  logic [255:0] ref_dims,            // slot s: {frame height[15:0], upscaled width[15:0]} at [32s +: 32]
    input  logic [255:0] ref_scales,          // slot s: {yScale[15:0], xScale[15:0]} of 7.11.3.3 (REF_SCALE_SHIFT 14; 16384 = unscaled) at [32s +: 32]
    input  logic        ref_fmt16,            // reference samples are 16-bit LE (else one byte each)
    input  logic [215:0] cur_planes,          // the current picture's flush layout, plane p: {stride[31:0], base[39:0]} at [72p +: 72]
    input  logic        cur_fmt16,            //    (intra block copy sources the window has already flushed)
    output logic        mc_unsup,             // sticky: an inter block used a feature beyond stage 2a (masks, OBMC, warp, scaled references)
    output logic          mem_err,              // sticky: a reference read answered with an AXI error (ref_fetch err); the picture is not trustworthy
    output logic [39:0] m_axi_araddr,
    output logic [7:0]  m_axi_arlen,
    output logic [2:0]  m_axi_arsize,
    output logic [1:0]  m_axi_arburst,
    output logic [3:0]  m_axi_arcache,
    output logic [2:0]  m_axi_arprot,
    output logic        m_axi_arvalid,
    input  logic        m_axi_arready,
    input  logic [63:0] m_axi_rdata,
    input  logic [1:0]  m_axi_rresp,
    input  logic        m_axi_rlast,
    input  logic        m_axi_rvalid,
    output logic        m_axi_rready
);
    localparam logic [3:0] DC_PRED = 4'd0, UV_CFL_PRED = 4'd13, SMOOTH_PRED = 4'd9, SMOOTH_H_PRED = 4'd11;
    localparam logic [3:0] IDTX = 4'd9;
    localparam int TW = 22;

    // Round2Signed(v, 8) of 7.11.3.3 (symmetric rounding of a signed value)
    function automatic logic signed [31:0] round2s8(input logic signed [38:0] v);
        if (v >= 39'sd0) return 32'((v + 39'sd128) >>> 8);
        else return -32'((-v + 39'sd128) >>> 8);
    endfunction
    function automatic logic is_inside(input logic [MIW-1:0] r, input logic [MIW-1:0] c);
        is_inside = ($signed({1'b0, c}) >= $signed({1'b0, hdr.mi_col_start})) && (c < hdr.mi_col_end) &&
                    ($signed({1'b0, r}) >= $signed({1'b0, hdr.mi_row_start})) && (r < hdr.mi_row_end);
    endfunction
    function automatic logic is_smooth(input logic [3:0] m);
        is_smooth = (m >= SMOOTH_PRED) && (m <= SMOOTH_H_PRED);
    endfunction
    function automatic logic is_dir(input logic [3:0] m);
        is_dir = (m >= 4'd1) && (m <= 4'd8);
    endfunction
    function automatic logic [7:0] clip255(input logic signed [10:0] v);
        clip255 = (v < 0) ? 8'd0 : (v > 11'sd255) ? 8'd255 : 8'(v);
    endfunction

    // ================================================================ block state (latched on blk_info)
    blk_rec_t    b;                                          // the block FSM's block (latched at blk_take)
    // Block-ahead MC step 1 (2026-11-08): transform events are popped when taken, so the block FSM can take the next
    // block while the transform FSM still works on the previous one. Two copies of the record, by block parity: the
    // block FSM reads b (= bq[cur_par]); the transform FSM reads bt = bq[t_par], t_par latched when it takes an event
    // (the most recently taken block is the event's block: the next block record sits behind the event in the queue).
    blk_rec_t    bq [0:1];
    logic        cur_par, t_par;
    blk_rec_t    bt;
    logic        tx_par;                                     // the block the transform side works for: its event's block, or the
    assign tx_par = ii_run ? cur_par : t_par;                //   block FSM's block during an inter-intra intra prediction (ii_run)
    assign bt = bq[tx_par];
    // Block-ahead MC step 2 (2026-11-08): the block FSM leaves a block once its last run has STARTED; the block is ready
    // for its transform events when every run of its parity has finished (mc_filt done, counted per parity through the
    // run record) and the blend pipelines have drained. An intra block (or a block copy / inter-intra, which read the
    // current frame) waits for the previous block to have landed. At most one block ahead: a block is taken only when
    // the block two back (same parity) is ready.
    logic [7:0]  runs_started [0:1], runs_done [0:1];
    logic        blk_last_started [0:1];                     // the block of this parity has issued its last run
    logic        blk_ready_q [0:1];                          // its prediction is complete: transform events may be taken
    logic        pred_done [0:1];
    logic        out_drained;
    logic        blk_ready;                                  // = blk_ready_q[cur_par] (the block FSM's current block)
    assign blk_ready = blk_ready_q[cur_par];
    logic [5:0]  bw4, bh4;
    logic        av_u, av_l, av_uc, av_lc;
    logic        ftq_y [0:1], ftq_uv [0:1];                 // intra filter type per plane class, per block parity (step 1)
    logic        ft_y, ft_uv;                              // the transform FSM's view: its block's
    assign ft_y = ftq_y[tx_par]; assign ft_uv = ftq_uv[tx_par];
    // the transform FSM's neighbour availability, from its block (the block FSM may already hold the next block)
    logic        tav_u, tav_l, tav_uc, tav_lc; logic [5:0] tbw4, tbh4;
    always_comb begin
        tbw4 = num4x4w(bt.bsize); tbh4 = num4x4h(bt.bsize);
        tav_u = is_inside(bt.r - MIW'(1), bt.c);
        tav_l = is_inside(bt.r, bt.c - MIW'(1));
        tav_uc = 1'b0; tav_lc = 1'b0;
        if (bt.has_chroma) begin
            tav_uc = tav_u; tav_lc = tav_l;
            if (hdr.ssy && tbh4 == 6'd1) tav_uc = is_inside(bt.r - MIW'(2), bt.c);
            if (hdr.ssx && tbw4 == 6'd1) tav_lc = is_inside(bt.r, bt.c - MIW'(2));
        end
    end
    always_comb begin
        bw4 = num4x4w(b.bsize); bh4 = num4x4h(b.bsize);
        av_u = is_inside(b.r - MIW'(1), b.c);
        av_l = is_inside(b.r, b.c - MIW'(1));
        av_uc = 1'b0; av_lc = 1'b0;
        if (b.has_chroma) begin
            av_uc = av_u; av_lc = av_l;
            if (hdr.ssy && bh4 == 6'd1) av_uc = is_inside(b.r - MIW'(2), b.c);
            if (hdr.ssx && bw4 == 6'd1) av_lc = is_inside(b.r, b.c - MIW'(2));
        end
    end

    // ---------------------------------------------------------------- mode map (per 4x4: {uvmode, ymode})
    localparam int MWORDS = (1 << ML2R) * (1 << (ML2C - 4));
    logic [127:0] mi_map [0:MWORDS-1];
    logic [ML2R+ML2C-5:0] mm_addr, mm_waddr;             // read address (combinational per state), write address
    logic [127:0] mm_rdata;                                // = mi_map[mm_addr of the previous cycle]
    logic         mm_we;
    logic [127:0] mm_wdata;
    always_ff @(posedge clk) begin
        if (mm_we) mi_map[mm_waddr] <= mm_wdata;
        mm_rdata <= mi_map[mm_addr];
    end
    function automatic logic [ML2R+ML2C-5:0] mm_index(input logic [MIW-1:0] row, input logic [MIW-1:0] col);
        mm_index = {ML2R'(row), (ML2C - 4)'(col >> 4)};
    endfunction
    function automatic logic [127:0] mm_merge(input logic [127:0] w, input logic [3:0] start, input logic [5:0] n, input logic [7:0] e);
        mm_merge = w;
        for (int k = 0; k < 16; k++)
            if (6'(k) >= 6'(start) && 6'(k) < 6'(start) + n) mm_merge[8 * k +: 8] = e;
    endfunction

    typedef enum logic [4:0] {B_IDLE, B_FT0, B_FT1, B_FT2, B_FT3, B_FT4, B_WR, B_WR_W,
                              B_IBC_INIT, B_IBC_PL, B_IBC_R0, B_IBC_R1, B_IBC_R2, B_IBC_R3, B_IBC_R4, B_IBC_R5, B_IBC_WR,
                              B_MC_INIT, B_MC_WSET, B_MC_WSET_W, B_MC_PL, B_MC_UNIT, B_MC_STRIP, B_MC_STRIP2, B_MC_FETCH, B_MC_NEXT, B_MC_DRAIN, B_MC_PLEND, B_MC_OB, B_MC_MASK, B_MC_II} bst_t;
    bst_t bst;
    // event queue consumption: a superblock start is applied when both FSMs are idle, a block record is taken by
    // the block FSM when idle, a transform block is taken by the transform FSM (and popped when acknowledged)
    // ---- intra block copy (7.11.3 with refIdx = -1): the block is predicted whole from the pre-filter current
    // frame before its transform blocks add residuals. someUseIntra is always 1 for an intrabc block (its own
    // RefFrames[0] is INTRA_FRAME), so each plane is one prediction of the plane residual size with this
    // block's vector. Luma vectors are whole samples; chroma may be half-sample -> bilinear (Subpel_Filters
    // BILINEAR: taps 64/64) through the spec's rounding chain (InterRound0 / InterRound1).
    logic [1:0]  ib_pl;
    logic        ibc_sx, ibc_sy;
    logic [7:0]  ib_w, ib_h, ib_i, ib_j;
    logic [PXW-1:0] ib_bx, ib_by, ib_lastx, ib_lasty;
    logic [3:0]  ib_fx, ib_fy;
    logic signed [PXS-1:0] ib_x0, ib_y0;
    logic [11:0] ib_s0, ib_s1, ib_s2, ib_s3;
    logic [4:0]  ib_r0, ib_r1;
    assign ibc_sx = (ib_pl != 2'd0) && hdr.ssx;
    assign ibc_sy = (ib_pl != 2'd0) && hdr.ssy;
    assign ib_r0 = (hdr.bit_depth == 4'd12) ? 5'd5 : 5'd3;
    assign ib_r1 = (hdr.bit_depth == 4'd12) ? 5'd9 : 5'd11;
    function automatic logic [PXW-1:0] ib_clip(input logic signed [PXS-1:0] v, input logic [PXW-1:0] last);
        if (v < 0) ib_clip = PXW'(0);
        else if (v > PXS'(signed'({2'b0, last}))) ib_clip = last;
        else ib_clip = PXW'(v);
    endfunction
    logic [PXW-1:0] ib_rx0, ib_rx1, ib_ry0, ib_ry1;          // clamped source coordinates of the 2x2 neighbourhood
    assign ib_rx0 = ib_clip(ib_x0 + PXS'(signed'({7'b0, ib_j})), ib_lastx);
    assign ib_rx1 = ib_clip(ib_x0 + PXS'(signed'({7'b0, ib_j})) + PXS'(1), ib_lastx);
    assign ib_ry0 = ib_clip(ib_y0 + PXS'(signed'({7'b0, ib_i})), ib_lasty);
    assign ib_ry1 = ib_clip(ib_y0 + PXS'(signed'({7'b0, ib_i})) + PXS'(1), ib_lasty);
    // ---- inter prediction (7.11.3, stage 2a: translational, unscaled; single / AVERAGE / DISTANCE): the block is
    // predicted whole, plane by plane, unit by unit (one unit per plane, or the per-luma-4x4 chroma units of a sub-8x8
    // block from b.cmv), in strips of at most 64 x 64, list by list: ref_fetch brings the clamped reference region into
    // mc_filt's patch, mc_filt filters (and blends list 1 with the parked list 0) and its output goes to the frame
    // memory through the fb4 port; the transform flow then adds residuals (R_SETUP -> R_RESID, like intrabc).
    logic [1:0]  mc_pl;
    logic        mc_sx, mc_sy;
    logic [7:0]  mc_pw, mc_ph;                               // plane block size
    logic [PXW-1:0] mc_bx, mc_by;                            // plane block origin
    logic [7:0]  mc_uw, mc_uh;                               // unit size
    logic [1:0]  mc_ur, mc_uc, mc_ui, mc_uj;                 // unit grid and index
    logic        mc_cmv;                                     // units take their motion from b.cmv
    logic [PXW-1:0] mc_ux, mc_uy;                            // unit origin
    logic [4:0]  mc_nsr, mc_nsc, mc_sr, mc_sc;               // 64 x 64 strips of the unit (32 x 32 in frames with a scaled reference, 8 x 8 when warped)
    // warped motion (stage 2c.2): per list, whether the block warps and its parameters / shear (warp_setup per block)
    logic        w_use [2];
    logic signed [23:0] w_p [2][6];
    logic signed [15:0] w_al [2], w_be [2], w_ga [2], w_de [2];
    logic [1:0]  w_cand;                                     // lists that may warp (setup decides the validity)
    logic        wl;                                         // the list being set up
    logic        ws_start, ws_mode, ws_busy, ws_done, ws_valid;
    logic [143:0] ws_p, ws_gm;
    logic signed [15:0] ws_alpha, ws_beta, ws_gamma, ws_delta;
    logic [15:0] ws_midx, ws_midy;
    logic [3:0]  ws_ref;
    logic        unit_warp;                                  // the unit is predicted in 8 x 8 strips (some list warps)
    bst_t        after_wset;                                 // where B_MC_INIT continues after the warp setup
    logic        mc_warp;                                    // the strip being run is a warp (this list)
    logic [15:0] mc_wsx, mc_wsy;                             // sx4 / sy4 of the strip
    logic        frame_scl;                                  // the frame references a scaled picture: 32 x 32 strips, 7.11.3.3 positions
    assign frame_scl = |ihdr.ref_scaled;
    logic        mc_ibc;                                     // the block in the MC path is an intra block copy (the current picture
                                             // is its reference: unscaled, BILINEAR, single list, no OBMC / masks / warps)
    logic        mc_scl;                                     // scaled-reference handling applies (never to an intra block copy)
    assign mc_scl = frame_scl && !mc_ibc;
    // the ring loader (fb_fetch) and the split of an intra block copy patch between it and ref_fetch
    logic        ff_req_valid, ff_req_ready, ff_done, ff_pend, rf_wait, ff_wait;
    logic [6:0]  rf_r_lo, rf_r_hi, ff_r_lo, ff_r_hi;
    logic        ff_fb_re; logic [1:0] ff_fb_plane; logic [FBX-1:0] ff_fb_x; logic [FBY-1:0] ff_fb_y;
    logic [6:0]  rf_w, rf_h;                                 // ref_fetch request: unit size in reference samples (strip size unscaled)
    logic signed [38:0] sc_bx, sc_by;                        // 7.11.3.3: origX * xScale, origY * yScale (strip 1 of 2)
    logic [11:0] sc_xs, sc_ys;                               // xStep / yStep
    logic [6:0]  sc_sw, sc_sh;
    logic [PXW-1:0] mc_px, mc_py;                            // strip origin
    logic [6:0]  mc_sw, mc_sh;                               // strip size
    logic        mc_l, mc_comp;
    logic [1:0]  mc_bmode;                                   // list-1 blend mode: 2 average, 3 distance
    logic [4:0]  mc_wt0, mc_wt1;
    logic [4:0]  dw_d0, dw_d1;                               // the two references' distances, the cycle before the weights
    always_ff @(posedge clk) {mc_wt1, mc_wt0} <= dist_weights(dw_d0, dw_d1);
    logic [3:0]  u_ref0, u_ref1;                             // the unit's motion
    logic signed [15:0] u_mv0r, u_mv0c, u_mv1r, u_mv1c;
    logic [1:0]  u_i0, u_i1;
    // ref_fetch request / mc_filt run
    logic        rf_req_valid, rf_req_ready, rf_done, rf_err, rf_lst;
    always_ff @(posedge clk) if (rst) mem_err <= 1'b0; else if (rf_err) mem_err <= 1'b1;   // 2026-10-30 audit: a failed reference read was collected as pixels and never reported
    logic        blk_inter;                                  // b.is_inter, constant 0 in the INTER = 0 build
    assign blk_inter = (INTER != 0) && b.is_inter;
    logic [39:0] rf_base; logic [31:0] rf_stride; logic [15:0] rf_lastx, rf_lasty; logic signed [16:0] rf_x0, rf_y0;
    logic        mc_start, mc_busy, mc_done, mc_done_tag, mc_v_active, mc_out_valid;
    logic        mc_h_ready;                                 // mc_filt can take the next run (its horizontal side is free)
    logic        mc_out_tag;                                 // the run record the outputs belong to
    logic        srun;                                       // run record written by the next start (toggles per run)
    logic        mc_tag;                                     // the record of the run being started (registered with mc_start, as run_buf is)
    logic        mc_fin;                                     // mc_done latched (the OBMC pipeline may still be draining at the pulse)
    // Block-ahead fetch (docs/reference-prefetch.md step B, 2026-11-03): a strip's reference patch is fetched into one of
    // mc_filt's two patch buffers while the filter still runs the previous strip from the other, so a fetch's round trip
    // hides behind a run. The sequencer moves on as soon as a run starts: the registers the output path reads during a
    // run are copied into the run record (r_*) at the start, and a block ends only after its last run has drained.
    logic        pbuf;                                       // patch buffer of the strip being fetched (then run)
    logic        run_buf;                                    // patch buffer of the run being started (sampled by mc_filt with start)
    logic        run_v;                                      // a run was started and mc_busy has not risen yet (it does the cycle after start)
    // Fetch handover, step C2 (2026-11-09, docs/reference-prefetch.md section 8): the block FSM issues the next strip's fetch
    // as soon as the engine accepted the previous one (ref_fetch takes a request once its address side is idle, step C1)
    // and queues the run, two deep: everything mc_filt samples at start plus the output path's record. The run thread (in
    // the FSM's always block, every state) starts the oldest queued run once its patch is in (ref_fetch done, counted by
    // request sequence: acc_cnt at the accept, done_cnt at the done pulse, at most three apart) and the filter's horizontal
    // side is free. Patch buffers alternate per accepted request (pbuf). A queued run counts as not landed for the block's
    // readiness (pq_pend in pred_done) and for the inter-intra request (pq_empty). The intra block copy keeps the serial
    // handoff (ref_fetch, then the ring loader on the shared patch write port, then the run is queued).
    logic [2:0]  acc_cnt, done_cnt;
    logic [1:0]  pq_h, pq_t;                                 // queue head / tail (mod 4; the entry is bit 0)
    logic [1:0]  pq_n;
    logic [2:0]  pq_seq [0:1]; logic pq_has_rf [0:1], pq_last [0:1], pq_buf [0:1], pq_par [0:1];
    logic        pq_l [0:1], pq_warp [0:1], pq_sx [0:1], pq_sy [0:1];
    logic [6:0]  pq_sw [0:1], pq_sh [0:1];
    logic [1:0]  pq_i0 [0:1], pq_i1 [0:1], pq_pl [0:1];
    logic [9:0]  pq_xf0 [0:1], pq_yf0 [0:1];
    logic [11:0] pq_xs [0:1], pq_ys [0:1];
    logic signed [15:0] pq_wa [0:1], pq_wb [0:1], pq_wg [0:1], pq_wd [0:1];
    logic [15:0] pq_wsx [0:1], pq_wsy [0:1];
    logic [2:0]  pq_mode [0:1]; logic [4:0] pq_wt0 [0:1], pq_wt1 [0:1];
    logic [PXW-1:0] pq_px [0:1], pq_py [0:1], pq_bx [0:1], pq_by [0:1];
    logic        pq_ob_active [0:1], pq_ob_pass [0:1]; logic [5:0] pq_ob_mlen [0:1];
    logic        pq_ii_active [0:1], pq_ii_wedge [0:1]; logic [3:0] pq_ii_mode [0:1]; logic [2:0] pq_ii_lsh [0:1];
    logic        pq_mb_active [0:1], pq_mb_diff [0:1]; logic [3:0] pq_post [0:1]; logic pq_mask_type [0:1];
    // the run being started: mc_filt samples these with mc_start, the cycle after run_go
    logic        st_l, st_buf, st_warp;
    logic [6:0]  st_sw, st_sh; logic [1:0] st_i0, st_i1; logic [9:0] st_xf0, st_yf0; logic [11:0] st_xs, st_ys;
    logic signed [15:0] st_wa, st_wb, st_wg, st_wd; logic [15:0] st_wsx, st_wsy; logic [2:0] st_mode; logic [4:0] st_wt0, st_wt1;
    logic        pq_empty, pq_full, qh_ready, run_go;
    logic [2:0]  qh_d;
    logic        pq_pend [0:1];                              // a queued (not started) run of that block parity
    logic        ibc_buf, ibc_has_rf, ibc_acc; logic [2:0] ibc_seq;   // the intra block copy's strip: buffer, DDR part, its accept and sequence
    logic        blk_last_run_q, blk_last_par_q;            // the run thread started a block's last run (with its parity)
    assign pq_n = pq_t - pq_h;
    assign pq_empty = (pq_n == 2'd0); assign pq_full = (pq_n == 2'd2);
    assign qh_d = done_cnt - pq_seq[pq_h[0]];
    assign qh_ready = !pq_has_rf[pq_h[0]] || (qh_d == 3'd1) || (qh_d == 3'd2);
    assign run_go = !pq_empty && qh_ready && mc_h_ready && !run_v;
    assign pq_pend[0] = (pq_n != 2'd0 && pq_par[pq_h[0]] == 1'b0) || (pq_n == 2'd2 && pq_par[!pq_h[0]] == 1'b0);
    assign pq_pend[1] = (pq_n != 2'd0 && pq_par[pq_h[0]] == 1'b1) || (pq_n == 2'd2 && pq_par[!pq_h[0]] == 1'b1);
    // Two run records (2026-11-08): mc_filt overlaps the horizontal pass of run n + 1 with the vertical pass of run n, so a
    // start may come while the previous run still outputs. The record of a start goes to rq_*[srun]; the output path reads
    // r_* = the record of the run whose outputs arrive (mc_out_tag, which mc_filt returns with every output word).
    // Between runs the tag keeps the last run's value, so the blend pipelines draining after its last word still see it
    // (the next run's first word comes at least 13 cycles later: the vertical drain and pipeline fill).
    logic [PXW-1:0] rq_px [0:1], rq_py [0:1], rq_bx [0:1], rq_by [0:1];
    logic [1:0]  rq_pl [0:1]; logic rq_sx [0:1], rq_sy [0:1], rq_l [0:1];
    logic        rq_ob_active [0:1], rq_ob_pass [0:1]; logic [5:0] rq_ob_mlen [0:1];
    logic        rq_ii_active [0:1], rq_ii_wedge [0:1]; logic [3:0] rq_ii_mode [0:1]; logic [2:0] rq_ii_lsh [0:1];
    logic        rq_mb_active [0:1], rq_mb_diff [0:1]; logic [3:0] rq_post [0:1]; logic rq_mask_type [0:1]; logic rq_par [0:1];
    logic [PXW-1:0] r_px, r_py, r_bx, r_by;                  // run record of the outputs: strip origin, plane block origin
    logic [1:0]  r_pl; logic r_sx, r_sy, r_l;
    logic        r_ob_active, r_ob_pass; logic [5:0] r_ob_mlen;
    logic        r_ii_active, r_ii_wedge; logic [3:0] r_ii_mode; logic [2:0] r_ii_lsh;
    logic        r_mb_active, r_mb_diff; logic [3:0] r_post;
    assign r_px = rq_px[mc_out_tag]; assign r_py = rq_py[mc_out_tag]; assign r_bx = rq_bx[mc_out_tag]; assign r_by = rq_by[mc_out_tag];
    assign r_pl = rq_pl[mc_out_tag]; assign r_sx = rq_sx[mc_out_tag]; assign r_sy = rq_sy[mc_out_tag]; assign r_l = rq_l[mc_out_tag];
    assign r_ob_active = rq_ob_active[mc_out_tag]; assign r_ob_pass = rq_ob_pass[mc_out_tag]; assign r_ob_mlen = rq_ob_mlen[mc_out_tag];
    assign r_ii_active = rq_ii_active[mc_out_tag]; assign r_ii_wedge = rq_ii_wedge[mc_out_tag]; assign r_ii_mode = rq_ii_mode[mc_out_tag]; assign r_ii_lsh = rq_ii_lsh[mc_out_tag];
    assign r_mb_active = rq_mb_active[mc_out_tag]; assign r_mb_diff = rq_mb_diff[mc_out_tag]; assign r_post = rq_post[mc_out_tag];
    logic r_mask_type; assign r_mask_type = rq_mask_type[mc_out_tag];
    logic [9:0]  mc_xf0, mc_yf0;                             // startX & 1023, startY & 1023 of the strip
    logic [2:0]  mc_mode;
    logic [135:0] mc_out_pair;                               // 2 lists x 4 lanes x 17-bit signed
    logic [6:0]  mc_out_x, mc_out_y; logic [47:0] mc_out_pix4; logic [3:0] mc_out_mask;
    logic [PXW-1:0] mc_ox; logic [1:0] mc_osh;              // output sample x, and its lane shift within the 4-group
    // OBMC (7.11.3.10, stage 2b.1): after a plane's own prediction, each overlap neighbour of b.obmc predicts a
    // (predW x predH) region with its own motion (single, through the same fetch / filter) and the frame memory is
    // read-modify-written: fb = Round2(m fb + (64 - m) pred, 6) with Obmc_Mask[predH][row] (above) / [predW][col] (left)
    logic        ob_active, ob_done, ob_pass;               // in an overlap prediction; both passes done for this plane; 0 above, 1 left
    logic [2:0]  ob_k;                                       // entry index within the pass
    logic [4:0]  mc_psz;                                     // the plane's block size (the above pass needs >= BLOCK_8X8)
    logic [5:0]  ob_mlen;                                    // mask length (predH above, predW left)
    logic        ob_rd_v, ob_rd2_v, ob_rd3_v, ob_wr_v;       // read-modify-write pipeline: A (read issued), A2, A3 (data lands: two-cycle read), B (write)
    logic [47:0] ob_a2_pix; logic [PXW-1:0] ob_a2_x, ob_a2_y; logic [3:0] ob_a2_be; logic [6:0] ob_a2_m [4];
    logic [47:0] ob_a3_pix; logic [PXW-1:0] ob_a3_x, ob_a3_y; logic [3:0] ob_a3_be; logic [6:0] ob_a3_m [4];
    logic [47:0] ob_a_pix, ob_b_pix;
    logic [PXW-1:0] ob_a_x, ob_a_y, ob_b_x, ob_b_y;
    logic [3:0]  ob_a_be, ob_b_be;
    logic [6:0]  ob_a_m [4];                                 // per-lane mask values
    // Masked compound (7.11.3.12 - 7.11.3.14, stage 2b.2): the block's luma mask in 8 banks (row parity, x & 3) of 7 bits,
    // entry (y >> 1) * 32 + (x >> 2): luma reads one value per lane, 4:2:0 chroma averages the four luma values of its
    // 2x2 (two reads per bank), 4:2:2 the two of its row. WEDGE is filled from the master masks before the prediction,
    // DIFFWTD from the luma pair output as it is blended; list 1 of a masked block runs mc_filt in mode 4 (pair) and the
    // blend fb = clip(Round2(m p0 + (64 - m) p1, 6 + post)) happens here.
    logic [6:0]  mask_bank [8][0:2047];
    logic        mk_we [8];
    logic [10:0] mk_waddr [8];
    logic [6:0]  mk_wdata [8];
    logic [10:0] mk_ra0 [8], mk_ra1 [8];                    // two read ports per bank
    logic [6:0]  mk_q0 [8], mk_q1 [8];
    logic        mb_active;                                  // the block is a masked compound (WEDGE / DIFFWTD)
    logic        mb_diff;                                    // DIFFWTD (else WEDGE)
    logic [6:0]  mk_x, mk_y;                                 // wedge fill position (luma, block-relative)
    logic [2:0]  mk_d;                                       // wedge master direction
    logic [5:0]  mk_xoff, mk_yoff;
    logic        mk_inv;
    logic        mk_hold;                                    // the fill's first write waits for the previous block's masked outputs
    assign mk_hold = (mk_x == 7'd0) && (mk_y == 7'd0) && !pred_done[!cur_par];
    logic        filt_free;                                  // no run in flight and the blend pipelines drained
    logic        mb_a_v, mb_b_v;                             // masked blend pipeline: A (the mask data lands, blend), B (write)
    assign out_drained = !ob_rd_v && !ob_rd2_v && !ob_rd3_v && !ob_wr_v && !mb_a_v && !mb_b_v;   // fm2: three read stages
    assign filt_free = !mc_busy && !run_v && out_drained;
    assign pred_done[0] = (runs_started[0] == runs_done[0]) && out_drained && !pq_pend[0];
    assign pred_done[1] = (runs_started[1] == runs_done[1]) && out_drained && !pq_pend[1];
    logic blk_last_run, blk_ready_set, mc_tag_par;
    assign mc_tag_par = rq_par[mc_tag];
    // the tracker: runs started per parity (with the start pulse), runs finished per parity (mc_filt done, the run's
    // record says which block); the block is ready once its last run has started and all of its runs are done
    always_ff @(posedge clk) begin
        if (rst) begin
            runs_started <= '{default: 8'd0}; runs_done <= '{default: 8'd0}; blk_last_started <= '{default: 1'b0}; blk_ready_q <= '{default: 1'b1};
        end else begin
            if (mc_start) runs_started[mc_tag_par] <= runs_started[mc_tag_par] + 8'd1;
            if (mc_done) runs_done[rq_par[mc_done_tag]] <= runs_done[rq_par[mc_done_tag]] + 8'd1;
            if (blk_take) begin blk_ready_q[!cur_par] <= 1'b0; blk_last_started[!cur_par] <= 1'b0; end
            if (blk_last_run) blk_last_started[cur_par] <= 1'b1;
            if (blk_last_run_q) blk_last_started[blk_last_par_q] <= 1'b1;
            if (blk_ready_set) blk_ready_q[cur_par] <= 1'b1;
            for (int p = 0; p < 2; p++)
                if (blk_last_started[p] && pred_done[p] && !(blk_take && (1'(p) == !cur_par))) blk_ready_q[p] <= 1'b1;
        end
    end
    logic [135:0] mb_a_pair, mb_a2_pair;
    logic [PXW-1:0] mb_a_x, mb_a_y, mb_a2_x, mb_a2_y, mb_b_x, mb_b_y;
    logic [3:0]  mb_a_be, mb_a2_be, mb_b_be;
    logic [6:0]  mb_a2_m [4];                                // DIFFWTD luma: the mask computed in A, carried to A2
    logic [47:0] mb_b_pix;
    logic [3:0]  mc_post;                                    // InterPostRound of the block's compound prediction
    always_ff @(posedge clk) begin
        for (int k = 0; k < 8; k++) begin
            if (mk_we[k]) mask_bank[k][mk_waddr[k]] <= mk_wdata[k];
            mk_q0[k] <= mask_bank[k][mk_ra0[k]];
            mk_q1[k] <= mask_bank[k][mk_ra1[k]];
        end
    end
    // Inter-intra (7.11.3.1 / 7.11.3.13, stage 2b.3): the plane's intra prediction (ipred through the transform flow with
    // a virtual transform record of the block size, written into the frame memory first), then the single inter
    // prediction blended in through the OBMC read-modify-write path: fb = Round2(m intra + (64 - m) inter, 6), m from
    // Ii_Weights_1d (sizeScale = 128 / max(w, h) of the plane block) or the wedge buffer (wedge_interintra)
    logic        ii_active, ii_wedge, ii_req, ii_run, ii_done;
    logic [1:0]  ii_pl;
    logic [PXW-1:0] ii_x, ii_y;
    logic [4:0]  ii_txsz;
    logic [3:0]  ii_mode;                                    // ipred mode: DC 0, V 1, H 2, SMOOTH 9
    logic [2:0]  ii_lsh;                                     // log2(sizeScale)
    function automatic logic [2:0] ii_scale_shift(input logic [7:0] w, input logic [7:0] h);   // log2(128 / max(w, h))
        logic [7:0] m;
        m = (w > h) ? w : h;
        if (m >= 8'd128) return 3'd0;
        if (m >= 8'd64) return 3'd1;
        if (m >= 8'd32) return 3'd2;
        if (m >= 8'd16) return 3'd3;
        if (m >= 8'd8) return 3'd4;
        if (m >= 8'd4) return 3'd5;
        return 3'd6;
    endfunction
    function automatic logic [6:0] diff_mask(input logic signed [16:0] p0, input logic signed [16:0] p1, input logic [3:0] bd,
                                             input logic [3:0] post, input logic mtype);
        logic signed [17:0] d;
        logic [17:0] a;
        logic [6:0] m;
        d = 18'(p0) - 18'(p1);
        a = (d < 0) ? 18'(-d) : 18'(d);
        a = (a + (18'd1 << (bd - 4'd8 + post - 4'd1))) >> (bd - 4'd8 + post);         // Round2(diff, bd - 8 + post)
        m = (a[17:4] + 14'd38 > 14'd64) ? 7'd64 : 7'(a[17:4] + 14'd38);                // clip3(0, 64, 38 + diff / 16)
        return mtype ? 7'd64 - m : m;
    endfunction
    function automatic logic [6:0] obmc_mask(input logic [5:0] len, input logic [5:0] i);
        case (len)
            6'd2:  return (i == 0) ? 7'd45 : 7'd64;
            6'd4:  case (i) 6'd0: return 7'd39; 6'd1: return 7'd50; 6'd2: return 7'd59; default: return 7'd64; endcase
            6'd8:  case (i) 6'd0: return 7'd36; 6'd1: return 7'd42; 6'd2: return 7'd48; 6'd3: return 7'd53; 6'd4: return 7'd57; 6'd5: return 7'd61; default: return 7'd64; endcase
            6'd16: case (i) 6'd0: return 7'd34; 6'd1: return 7'd37; 6'd2: return 7'd40; 6'd3: return 7'd43; 6'd4: return 7'd46; 6'd5: return 7'd49;
                            6'd6: return 7'd52; 6'd7: return 7'd54; 6'd8: return 7'd56; 6'd9: return 7'd58; 6'd10: return 7'd60; 6'd11: return 7'd61; default: return 7'd64; endcase
            default: case (i) 6'd0: return 7'd33; 6'd1: return 7'd35; 6'd2: return 7'd36; 6'd3: return 7'd38; 6'd4: return 7'd40; 6'd5: return 7'd41; 6'd6: return 7'd43;
                              6'd7: return 7'd44; 6'd8: return 7'd45; 6'd9: return 7'd47; 6'd10: return 7'd48; 6'd11: return 7'd50; 6'd12: return 7'd51; 6'd13: return 7'd52;
                              6'd14: return 7'd53; 6'd15: return 7'd55; 6'd16: return 7'd56; 6'd17: return 7'd57; 6'd18: return 7'd58; 6'd19: return 7'd59;
                              6'd20: return 7'd60; 6'd21: return 7'd60; 6'd22: return 7'd61; 6'd23: return 7'd62; default: return 7'd64; endcase
        endcase
    endfunction
    logic        pw_we, pw_buf, pw_list; logic [6:0] pw_row; logic [4:0] pw_w4; logic [47:0] pw_d4;

    generate if (INTER != 0) begin : g_inter
    logic rf_pw_we, ff_pw_we, rf_pw_list, ff_pw_list; logic [6:0] rf_pw_row, ff_pw_row; logic [4:0] rf_pw_w4, ff_pw_w4; logic [47:0] rf_pw_d4, ff_pw_d4;
    logic rf_pw_buf; logic [1:0] mc_buf_busy;
    assign pw_we = rf_pw_we || ff_pw_we;
    assign pw_buf = ff_pw_we ? ibc_buf : rf_pw_buf;                 // ref_fetch names its buffer per request; the ring loader writes the copy's
    assign pw_list = ff_pw_we ? ff_pw_list : rf_pw_list; assign pw_row = ff_pw_we ? ff_pw_row : rf_pw_row;
    assign pw_w4 = ff_pw_we ? ff_pw_w4 : rf_pw_w4; assign pw_d4 = ff_pw_we ? ff_pw_d4 : rf_pw_d4;
    ref_fetch #(.PW(12), .RING(REF_RING)) u_rf (.clk, .rst,
        .req_valid(rf_req_valid && !pq_full), .req_ready(rf_req_ready), .req_lst(rf_lst), .req_fmt16(mc_ibc ? cur_fmt16 : ref_fmt16), .req_base(rf_base),
        .req_stride(rf_stride), .req_lastx(rf_lastx), .req_lasty(rf_lasty), .req_x0(rf_x0), .req_y0(rf_y0),
        .req_w(rf_w), .req_h(rf_h), .req_r_lo(rf_r_lo), .req_r_hi(rf_r_hi), .req_buf(pbuf), .buf_busy(mc_buf_busy), .done(rf_done), .err(rf_err),
        .m_axi_araddr, .m_axi_arlen, .m_axi_arsize, .m_axi_arburst, .m_axi_arcache, .m_axi_arprot, .m_axi_arvalid, .m_axi_arready,
        .m_axi_rdata, .m_axi_rresp, .m_axi_rlast, .m_axi_rvalid, .m_axi_rready,
        .patch_we(rf_pw_we), .patch_buf(rf_pw_buf), .patch_list(rf_pw_list), .patch_row(rf_pw_row), .patch_w4(rf_pw_w4), .patch_d4(rf_pw_d4));
    fb_fetch #(.PW(12), .FBX(FBX), .FBY(FBY)) u_ff (.clk, .rst,
        .req_valid(ff_req_valid), .req_ready(ff_req_ready), .req_lst(rf_lst), .req_plane(mc_pl), .req_lastx(rf_lastx), .req_lasty(rf_lasty),
        .req_x0(rf_x0), .req_y0(rf_y0), .req_w(rf_w), .req_r_lo(ff_r_lo), .req_r_hi(ff_r_hi), .done(ff_done),
        .fb_re(ff_fb_re), .fb_plane(ff_fb_plane), .fb_x(ff_fb_x), .fb_y(ff_fb_y), .fb_rdata4,
        .patch_we(ff_pw_we), .patch_list(ff_pw_list), .patch_row(ff_pw_row), .patch_w4(ff_pw_w4), .patch_d4(ff_pw_d4));
    mc_filt #(.PW(12)) u_mc (.clk, .rst,
        .patch_we(pw_we), .patch_buf(pw_buf), .patch_list(pw_list), .patch_row(pw_row), .patch_w4(pw_w4), .patch_d4(pw_d4),
        .start(mc_start), .run_tag(mc_tag), .lst(st_l), .rbuf(run_buf), .w(st_sw), .h(st_sh), .interp_x(st_i1), .interp_y(st_i0),
        .x_frac0(st_xf0), .y_frac0(st_yf0), .x_step(st_xs), .y_step(st_ys),
        .warp(st_warp), .w_alpha(st_wa), .w_beta(st_wb), .w_gamma(st_wg), .w_delta(st_wd), .w_sx4(st_wsx), .w_sy4(st_wsy),
        .bit_depth(hdr.bit_depth), .mode(st_mode), .wt0(st_wt0), .wt1(st_wt1), .busy(mc_busy), .h_ready(mc_h_ready), .h_buf_busy(mc_buf_busy), .done(mc_done), .done_tag(mc_done_tag), .v_active(mc_v_active), .v_hold(rs != R_IDLE),
        .out_valid(mc_out_valid), .out_tag(mc_out_tag), .out_x(mc_out_x), .out_y(mc_out_y), .out_pix4(mc_out_pix4), .out_mask(mc_out_mask), .out_pair(mc_out_pair));
    end else begin : g_nointer
        assign rf_req_ready = 1'b1; assign rf_done = 1'b0; assign rf_err = 1'b0;
        assign ff_req_ready = 1'b1; assign ff_done = 1'b0; assign ff_fb_re = 1'b0; assign ff_fb_plane = 2'd0; assign ff_fb_x = '0; assign ff_fb_y = '0;
        assign m_axi_araddr = '0; assign m_axi_arlen = '0; assign m_axi_arsize = '0; assign m_axi_arburst = '0;
        assign m_axi_arcache = '0; assign m_axi_arprot = '0; assign m_axi_arvalid = 1'b0; assign m_axi_rready = 1'b0;
        assign pw_we = 1'b0; assign pw_buf = 1'b0; assign pw_list = 1'b0; assign pw_row = '0; assign pw_w4 = '0; assign pw_d4 = '0;
        assign mc_busy = 1'b0; assign mc_h_ready = 1'b1; assign mc_done = 1'b0; assign mc_done_tag = 1'b0; assign mc_v_active = 1'b0; assign mc_out_valid = 1'b0; assign mc_out_tag = 1'b0; assign mc_out_x = '0; assign mc_out_y = '0;
        assign mc_out_pix4 = '0; assign mc_out_mask = '0; assign mc_out_pair = '0;
    end endgenerate

    // 7.11.3.15 distance weights: {BckWeight (list 1), FwdWeight (list 0)} from the order-hint distances
    function automatic int rel_dist(input ihdr_t ih, input logic [7:0] oa, input logic [7:0] ob);
        int diff, m;
        if (!ih.enable_order_hint) return 0;
        diff = int'(oa) - int'(ob);
        m = 1 << (int'(ih.order_hint_bits) - 1);
        return (diff & (m - 1)) - (diff & m);
    endfunction
    // The distance weights (7.11.3.15) in two cycles: dist_abs (the relative distance of each reference, absolute,
    // clamped) is registered at B_MC_INIT, dist_weights (the ordered compares and the table) the cycle after; the
    // filter latches the weights at its start, many cycles later. In one cycle, from the block record's ref0 through
    // the order-hint pick, the differences, the products and the compares into the filter's weight register was 31
    // logic levels (-0.68 ns at 100 MHz routed).
    function automatic logic [4:0] dist_abs(input ihdr_t ih, input logic [3:0] r);
        int dd;
        dd = rel_dist(ih, ih.order_hints[8 * (int'(r) - 1) +: 8], ih.order_hint);
        if (dd < 0) dd = -dd;
        if (dd > 31) dd = 31;
        return 5'(dd);
    endfunction
    function automatic logic [9:0] dist_weights(input logic [4:0] dist0, input logic [4:0] dist1);
        int d0, d1, i, c0, c1;
        logic order, found;
        logic [4:0] qdw [4][2];
        logic [4:0] qdl [4][2];
        qdw = '{'{5'd2, 5'd3}, '{5'd2, 5'd5}, '{5'd2, 5'd7}, '{5'd1, 5'd31}};
        qdl = '{'{5'd9, 5'd7}, '{5'd11, 5'd5}, '{5'd12, 5'd4}, '{5'd13, 5'd3}};
        d0 = int'(dist1); d1 = int'(dist0);
        order = (d0 <= d1);
        i = 3; found = 1'b0;
        if (d0 != 0 && d1 != 0)
            for (int k = 0; k < 3; k++)
                if (!found) begin
                    c0 = int'(qdw[k][order]); c1 = int'(qdw[k][!order]);
                    if (order ? (d0 * c0 > d1 * c1) : (d0 * c0 < d1 * c1)) begin i = k; found = 1'b1; end
                end
        return {qdl[i][!order], qdl[i][order]};
    endfunction
    function automatic logic [1:0] gm_type_of(input ihdr_t ih, input logic [3:0] r);
        return ih.gm_type[2 * (int'(r) - 1) +: 2];
    endfunction

    // declared ahead of their first use: Vivado makes an implicit 1-bit net of an identifier used before its declaration
    typedef enum logic [4:0] {
        R_IDLE, R_SETUP,
        R_PAL, R_PAL_LAST,
        R_EDGE, R_IP_START, R_IP_W,
        R_CFL_L, R_CFL_D, R_CFL_D2, R_CFL_START, R_CFL_W,
        R_RESID, R_DQ, R_DQ_LAST, R_ITX_START, R_ITX_W, R_ADD, R_ADD_LAST, R_ADD_LAST2, R_ADD_LAST3, R_ADD_LAST4,
        R_FIN, R_MIW
    } rst_t;
    rst_t rs;
    logic sb_start, blk_take;
    logic [MIW-1:0] sb_r, sb_c;
    logic [5:0] sb_size4;
    logic [11:0] pix_max;
    logic [11:0] ib_out;
    always_comb begin
        logic [19:0] a0, a1;
        logic [16:0] h0, h1;
        logic [24:0] v;
        logic [13:0] o;
        a0 = ib_fx[3] ? 20'd64 * 20'(ib_s0) + 20'd64 * 20'(ib_s1) : 20'd128 * 20'(ib_s0);
        a1 = ib_fx[3] ? 20'd64 * 20'(ib_s2) + 20'd64 * 20'(ib_s3) : 20'd128 * 20'(ib_s2);
        h0 = 17'((a0 + (20'd1 << (ib_r0 - 5'd1))) >> ib_r0);
        h1 = 17'((a1 + (20'd1 << (ib_r0 - 5'd1))) >> ib_r0);
        v = ib_fy[3] ? 25'd64 * 25'(h0) + 25'd64 * 25'(h1) : 25'd128 * 25'(h0);
        o = 14'((v + (25'd1 << (ib_r1 - 5'd1))) >> ib_r1);
        ib_out = (o > 14'(pix_max)) ? pix_max : 12'(o);
    end
    logic [7:0]  nb_ay, nb_ly, nb_auv, nb_luv;
    logic [5:0]  wr_i;                                     // row counter for the map write
    logic        wr_j;                                     // word half
    logic [MIW-1:0] a_r_uv, a_c_uv, l_r_uv, l_c_uv;           // 7.11.2.8 chroma neighbour positions
    always_comb begin
        a_r_uv = b.r - MIW'(1); a_c_uv = b.c;
        if (hdr.ssx && !b.c[0]) a_c_uv = b.c + MIW'(1);
        if (hdr.ssy && b.r[0]) a_r_uv = b.r - MIW'(2);
        l_r_uv = b.r; l_c_uv = b.c - MIW'(1);
        if (hdr.ssx && b.c[0]) l_c_uv = b.c - MIW'(2);
        if (hdr.ssy && !b.r[0]) l_r_uv = b.r + MIW'(1);
    end
    logic [5:0] wr_n;
    assign wr_n = (bw4 > 6'd16) ? 6'd16 : bw4;
    // read address by state: each state's read lands in mm_rdata during the next state
    always_comb begin
        case (bst)
            B_FT0: mm_addr = mm_index(b.r - MIW'(1), b.c);
            B_FT1: mm_addr = mm_index(b.r, b.c - MIW'(1));
            B_FT2: mm_addr = mm_index(a_r_uv, a_c_uv);
            B_FT3: mm_addr = mm_index(l_r_uv, l_c_uv);
            B_FT4: mm_addr = mm_index(b.r, b.c);
            B_WR_W: mm_addr = (bw4 > 6'd16 && !wr_j) ? mm_index(b.r + MIW'(wr_i), b.c + MIW'(16)) : mm_index(b.r + MIW'(wr_i) + MIW'(1), b.c);
            default: mm_addr = mm_index(b.r + MIW'(wr_i), b.c + (wr_j ? MIW'(16) : MIW'(0)));   // B_WR: the word being merged
        endcase
    end

    assign mi_blk_r = b.r; assign mi_blk_c = b.c; assign mi_blk_bw4 = bw4; assign mi_blk_bh4 = bh4;
    // cdef_idx bookkeeping: clear on sb_start (uses sb_r/sb_c), set with the block record (superblock-relative units)
    logic [MIW-1:0] sb_mask;
    assign sb_mask = hdr.sb128 ? ~MIW'(31) : ~MIW'(15);
    assign mi_cd_clr = sb_start;
    assign mi_cd_row64 = sb_start ? SBW'(sb_r >> 4) : SBW'((b.r & sb_mask) >> 4);
    assign mi_cd_col64 = sb_start ? SBW'(sb_c >> 4) : SBW'((b.c & sb_mask) >> 4);
    assign mi_cd_mask = hdr.sb128 ? b.cdef_units : 4'b0001;
    assign mi_cd_idx = b.cdef_idx;
    assign mi_blk_data = '{bsize: b.bsize, skip: b.skip, seg: b.seg, delta_lf: b.delta_lf, ref0: 3'(b.ref0),
                           mode_type: (b.ymode >= 5'd13 && b.ymode != 5'd15 && b.ymode != 5'd23)};   // 7.14.4 modeType
    always_ff @(posedge clk) begin
        mm_we <= 1'b0; mi_blk_we <= 1'b0; mi_cd_we <= 1'b0; mc_start <= 1'b0; ii_req <= 1'b0; blk_last_run <= 1'b0; blk_ready_set <= 1'b0; blk_last_run_q <= 1'b0;
        if (mc_done) mc_fin <= 1'b1;
        if (mc_busy) run_v <= 1'b0;
        if (rf_done) done_cnt <= done_cnt + 3'd1;
        if (!rst && run_go) begin
            // the run thread: the oldest queued run's patch is in and the horizontal side is free; mc_filt samples st_* with
            // mc_start next cycle, the output path reads the record rq_*[srun] (as before)
            mc_start <= 1'b1; run_v <= 1'b1; mc_fin <= 1'b0; mc_tag <= srun; srun <= !srun; run_buf <= pq_buf[pq_h[0]];
            st_l <= pq_l[pq_h[0]]; st_buf <= pq_buf[pq_h[0]]; st_warp <= pq_warp[pq_h[0]]; st_sw <= pq_sw[pq_h[0]]; st_sh <= pq_sh[pq_h[0]];
            st_i0 <= pq_i0[pq_h[0]]; st_i1 <= pq_i1[pq_h[0]]; st_xf0 <= pq_xf0[pq_h[0]]; st_yf0 <= pq_yf0[pq_h[0]]; st_xs <= pq_xs[pq_h[0]]; st_ys <= pq_ys[pq_h[0]];
            st_wa <= pq_wa[pq_h[0]]; st_wb <= pq_wb[pq_h[0]]; st_wg <= pq_wg[pq_h[0]]; st_wd <= pq_wd[pq_h[0]]; st_wsx <= pq_wsx[pq_h[0]]; st_wsy <= pq_wsy[pq_h[0]];
            st_mode <= pq_mode[pq_h[0]]; st_wt0 <= pq_wt0[pq_h[0]]; st_wt1 <= pq_wt1[pq_h[0]];
            rq_px[srun] <= pq_px[pq_h[0]]; rq_py[srun] <= pq_py[pq_h[0]]; rq_bx[srun] <= pq_bx[pq_h[0]]; rq_by[srun] <= pq_by[pq_h[0]]; rq_pl[srun] <= pq_pl[pq_h[0]];
            rq_sx[srun] <= pq_sx[pq_h[0]]; rq_sy[srun] <= pq_sy[pq_h[0]]; rq_l[srun] <= pq_l[pq_h[0]];
            rq_ob_active[srun] <= pq_ob_active[pq_h[0]]; rq_ob_pass[srun] <= pq_ob_pass[pq_h[0]]; rq_ob_mlen[srun] <= pq_ob_mlen[pq_h[0]];
            rq_ii_active[srun] <= pq_ii_active[pq_h[0]]; rq_ii_wedge[srun] <= pq_ii_wedge[pq_h[0]]; rq_ii_mode[srun] <= pq_ii_mode[pq_h[0]]; rq_ii_lsh[srun] <= pq_ii_lsh[pq_h[0]];
            rq_mb_active[srun] <= pq_mb_active[pq_h[0]]; rq_mb_diff[srun] <= pq_mb_diff[pq_h[0]]; rq_post[srun] <= pq_post[pq_h[0]]; rq_mask_type[srun] <= pq_mask_type[pq_h[0]]; rq_par[srun] <= pq_par[pq_h[0]];
            if (pq_last[pq_h[0]]) begin blk_last_run_q <= 1'b1; blk_last_par_q <= pq_par[pq_h[0]]; end
            pq_h <= pq_h + 2'd1;
        end
        if (rst) begin
            bst <= B_IDLE; mc_unsup <= 1'b0; rf_req_valid <= 1'b0; mc_fin <= 1'b0; run_v <= 1'b0; pbuf <= 1'b0; srun <= 1'b0; mc_tag <= 1'b0; cur_par <= 1'b0;
            ff_req_valid <= 1'b0; ff_pend <= 1'b0; rf_wait <= 1'b0; ff_wait <= 1'b0; mc_ibc <= 1'b0;
            acc_cnt <= 3'd0; done_cnt <= 3'd0; pq_h <= 2'd0; pq_t <= 2'd0; ibc_acc <= 1'b0; ibc_has_rf <= 1'b0; pq_last <= '{default: 1'b0};
            ws_start <= 1'b0;                                // a reset between the start and its clear left warp_setup a stale start (2026-10-30 audit)
        end else if (INTER != 0 && int'(bst) >= int'(B_MC_INIT)) begin
            // motion compensation states (inter blocks): compiled out at INTER = 0
            case (bst)
                // ---- inter prediction (stage 2a): see the declarations above
                B_MC_INIT: if (!b.intrabc || (rs == R_IDLE && pred_done[!cur_par])) begin   // a block copy reads the current frame
                    logic comp;
                    comp = !b.intrabc && (b.ref1 >= 4'd1) && (b.ref1 <= 4'd7);
                    mc_comp <= comp; mc_ibc <= b.intrabc;
                    mc_bmode <= (b.compound_type == 3'd4) ? 2'd3 : 2'd2;
                    dw_d0 <= dist_abs(ihdr, b.ref0); dw_d1 <= dist_abs(ihdr, b.ref1);   // mc_wt0 / mc_wt1 follow a cycle later
                    if (comp && b.compound_type == 3'd3) mc_unsup <= 1'b1;
                    // warp candidates (7.11.3.1): LOCALWARP (list 0), or GLOBALMV / GLOBAL_GLOBALMV with a non-translational
                    // gm_type and an unscaled reference; never with force_integer_mv. warp_setup settles the validity.
                    w_cand[0] <= !b.intrabc && !ihdr.force_integer_mv && (b.motion_mode == 2'd2
                                 || ((b.ymode == 5'd15 || b.ymode == 5'd23) && gm_type_of(ihdr, b.ref0) > 2'd1 && !ihdr.ref_scaled[int'(b.ref0) - 1]));
                    w_cand[1] <= !ihdr.force_integer_mv && comp
                                 && (b.ymode == 5'd15 || b.ymode == 5'd23) && gm_type_of(ihdr, b.ref1) > 2'd1 && !ihdr.ref_scaled[int'(b.ref1) - 1];
                    wl <= 1'b0; w_use[0] <= 1'b0; w_use[1] <= 1'b0;
                    mc_pl <= 2'd0; ob_active <= 1'b0; ob_done <= 1'b0; mb_active <= 1'b0;
                    ii_active <= b.interintra && !b.intrabc; ii_wedge <= b.interintra && !b.intrabc && b.wedge_interintra;
                    ii_mode <= (b.interintra_mode == 2'd0) ? 4'd0 : (b.interintra_mode == 2'd1) ? 4'd1 : (b.interintra_mode == 2'd2) ? 4'd2 : 4'd9;
                    mc_post <= 4'd14 - ((hdr.bit_depth == 4'd12) ? 4'd5 : 4'd3) - 4'd7;        // compound: InterRound1 = 7
                    if ((comp && (b.compound_type == 3'd0 || b.compound_type == 3'd1)) || (b.interintra && !b.intrabc && b.wedge_interintra)) begin
                        logic [10:0] cb;
                        logic [1:0] shape;
                        logic [7:0] bw, bh;
                        mb_active <= comp; mb_diff <= comp && (b.compound_type == 3'd1);
                        bw = 8'(num4x4w(b.bsize)) << 2; bh = 8'(num4x4h(b.bsize)) << 2;
                        shape = (bh4 > bw4) ? 2'd0 : (bh4 < bw4) ? 2'd1 : 2'd2;
                        cb = wedge_codebook(shape, b.wedge_index);
                        mk_d <= cb[10:8];
                        mk_xoff <= 6'(8'd32 - ((8'(cb[7:4]) * bw) >> 3)); mk_yoff <= 6'(8'd32 - ((8'(cb[3:0]) * bh) >> 3));
                        mk_inv <= (b.wedge_sign != wedge_flip(b.bsize, b.wedge_index));
                        mk_x <= 7'd0; mk_y <= 7'd0;
                        after_wset <= ((comp && b.compound_type == 3'd0) || (b.interintra && !b.intrabc && b.wedge_interintra)) ? B_MC_MASK : B_MC_PL;
                    end else after_wset <= B_MC_PL;
                    bst <= B_MC_WSET;
                end
                B_MC_WSET: begin                                                     // warp parameters of list wl, if a candidate
                    if (w_cand[wl]) begin
                        ws_start <= 1'b1; ws_mode <= !(wl == 1'b0 && b.motion_mode == 2'd2);
                        bst <= B_MC_WSET_W;
                    end else if (wl) bst <= after_wset;
                    else wl <= 1'b1;
                end
                B_MC_WSET_W: begin
                    ws_start <= 1'b0;
                    if (ws_done) begin
                        w_use[wl] <= ws_valid;
                        for (int j = 0; j < 6; j++) w_p[wl][j] <= 24'(signed'(ws_p[24 * j +: 24]));
                        w_al[wl] <= ws_alpha; w_be[wl] <= ws_beta; w_ga[wl] <= ws_gamma; w_de[wl] <= ws_delta;
                        if (wl) bst <= after_wset;
                        else begin wl <= 1'b1; bst <= B_MC_WSET; end
                    end
                end
                B_MC_MASK: if (!mk_hold) begin
                    // the wedge mask of the block, four luma samples a cycle (wedge blocks are at most 32 x 32); the first write
                    // waits for the previous block's masked outputs (mk_hold: the bank addresses are block-relative)
                    if (mk_x + 7'd4 < (8'(num4x4w(b.bsize)) << 2)) mk_x <= mk_x + 7'd4;
                    else begin mk_x <= 7'd0; if (mk_y + 7'd1 < (8'(num4x4h(b.bsize)) << 2)) mk_y <= mk_y + 7'd1; else bst <= B_MC_PL; end
                end
                B_MC_PL: begin
                    logic sx, sy;
                    logic [4:0] psz;
                    logic cmv_units;
                    sx = (mc_pl != 2'd0) && hdr.ssx; sy = (mc_pl != 2'd0) && hdr.ssy;
                    psz = subsampled_size(b.bsize, sx, sy);
                    mc_sx <= sx; mc_sy <= sy; mc_psz <= psz;
                    mc_pw <= 8'(num4x4w(psz)) << 2; mc_ph <= 8'(num4x4h(psz)) << 2;
                    mc_bx <= PXW'((PXW'(b.c) >> sx) << 2); mc_by <= PXW'((PXW'(b.r) >> sy) << 2);
                    // chroma of a sub-8x8 luma block: per-luma-4x4 units from b.cmv unless someUseIntra
                    cmv_units = (mc_pl != 2'd0) && ((bw4 == 6'd1 && hdr.ssx) || (bh4 == 6'd1 && hdr.ssy)) && !b.cmv_intra && !b.intrabc;
                    mc_cmv <= cmv_units;
                    if (cmv_units) begin
                        mc_uw <= (8'(num4x4w(b.bsize)) << 2) >> sx; mc_uh <= (8'(num4x4h(b.bsize)) << 2) >> sy;
                        mc_uc <= (bw4 == 6'd1 && hdr.ssx) ? 2'd2 : 2'd1; mc_ur <= (bh4 == 6'd1 && hdr.ssy) ? 2'd2 : 2'd1;
                    end else begin
                        mc_uw <= 8'(num4x4w(psz)) << 2; mc_uh <= 8'(num4x4h(psz)) << 2;
                        mc_uc <= 2'd1; mc_ur <= 2'd1;
                    end
                    mc_ui <= 2'd0; mc_uj <= 2'd0;
                    if (b.interintra && !b.intrabc) begin
                        ii_pl <= mc_pl; ii_x <= PXW'((PXW'(b.c) >> sx) << 2); ii_y <= PXW'((PXW'(b.r) >> sy) << 2);
                        ii_txsz <= max_tx_size_rect(psz);
                        ii_lsh <= ii_scale_shift(8'(num4x4w(psz)) << 2, 8'(num4x4h(psz)) << 2);
                        // The intra prediction writes the frame memory on fb4, the port the previous plane's run and its
                        // blend pipelines (ob_wr_v / mb_b_v, which take the port) may still be writing: since the block-ahead
                        // fetch (fc34a84) the sequencer gets here while that run is in flight, and an intra write that lost
                        // the port was dropped (Argon test7588_6663 frame 8, plane 2 (0,79): the census-7 narrow-chroma
                        // diffs, 2026-11-07). The request waits for the filter and its blends to drain.
                        if (filt_free && pq_empty && rs == R_IDLE && pred_done[!cur_par]) begin ii_req <= 1'b1; bst <= B_MC_II; end
                    end else bst <= B_MC_UNIT;
                end
                B_MC_II: if (ii_done) bst <= B_MC_UNIT;                              // the intra prediction is in the frame memory
                B_MC_UNIT: begin
                    int k;
                    logic [75:0] u;
                    k = int'(mc_ui) * int'(mc_uc) + int'(mc_uj);
                    u = b.cmv[76 * k +: 76];
                    if (mc_cmv) begin
                        u_ref0 <= u[3:0]; u_ref1 <= u[7:4]; u_mv0r <= u[23:8]; u_mv0c <= u[39:24]; u_mv1r <= u[55:40]; u_mv1c <= u[71:56];
                        u_i0 <= u[73:72]; u_i1 <= u[75:74];
                    end else begin
                        u_ref0 <= b.ref0; u_ref1 <= b.ref1; u_mv0r <= 16'(b.mv_row); u_mv0c <= 16'(b.mv_col);
                        u_mv1r <= 16'(b.mv1_row); u_mv1c <= 16'(b.mv1_col); u_i0 <= b.intrabc ? 2'd3 : b.interp0; u_i1 <= b.intrabc ? 2'd3 : b.interp1;
                    end
                    mc_ux <= mc_bx + PXW'(mc_uj) * PXW'(mc_uw); mc_uy <= mc_by + PXW'(mc_ui) * PXW'(mc_uh);
                    begin
                        logic uw;
                        // warp needs a plane block of at least 8 x 8 (sub-8x8 chroma units never warp)
                        uw = (w_use[0] || (mc_comp && w_use[1])) && !mc_cmv && mc_uw >= 8'd8 && mc_uh >= 8'd8;
                        unit_warp <= uw;
                        mc_nsc <= uw ? 5'(mc_uw >> 3) : mc_scl ? 5'((mc_uw + 8'd31) >> 5) : 5'((mc_uw + 8'd63) >> 6);
                        mc_nsr <= uw ? 5'(mc_uh >> 3) : mc_scl ? 5'((mc_uh + 8'd31) >> 5) : 5'((mc_uh + 8'd63) >> 6);
                    end
                    mc_sr <= 5'd0; mc_sc <= 5'd0; mc_l <= 1'b0;
                    bst <= B_MC_STRIP;
                end
                B_MC_STRIP: begin
                    // the strip's geometry and this list's reference position. Unscaled reference (7.11.3.3 with
                    // xScale = yScale = 1 << 14): integer part x + ((2 mv) >> subX) >> 4, phase its low 4 bits, step 1024.
                    // Frames with a scaled reference take the general path: strips of 32, startX / startY of the UNIT from
                    // origX * xScale (this cycle), rounded and offset by the strip's columns in steps in B_MC_STRIP2.
                    logic [7:0] rem_w, rem_h;
                    logic signed [19:0] mvx2, mvy2;
                    logic [3:0] rref;
                    logic [2:0] slot;
                    logic [15:0] dw, dh, xsc, ysc;
                    logic [PXW-1:0] px, py;
                    logic [6:0] sw, sh;
                    logic signed [21:0] ox, oy;
                    logic [2:0] ss;
                    logic [7:0] smax;
                    logic signed [21:0] srcx, srcy;
                    ss = unit_warp ? 3'd3 : mc_scl ? 3'd5 : 3'd6;                  // strip size: 8, 32 or 64
                    smax = 8'd1 << ss;
                    rem_w = mc_uw - (8'(mc_sc) << ss); rem_h = mc_uh - (8'(mc_sr) << ss);
                    sw = (rem_w > smax) ? 7'(smax) : 7'(rem_w); sh = (rem_h > smax) ? 7'(smax) : 7'(rem_h);
                    px = mc_ux + (PXW'(mc_sc) << ss); py = mc_uy + (PXW'(mc_sr) << ss);
                    mc_sw <= sw; mc_sh <= sh; sc_sw <= sw; sc_sh <= sh;
                    mc_px <= px; mc_py <= py;
                    mvx2 = (20'(mc_l ? u_mv1c : u_mv0c) * 20'sd2) >>> mc_sx;
                    mvy2 = (20'(mc_l ? u_mv1r : u_mv0r) * 20'sd2) >>> mc_sy;
                    rref = mc_l ? u_ref1 : u_ref0;
                    slot = (rref == 4'd0) ? 3'd0 : ref_slot[3 * (int'(rref) - 1) +: 3];
                    rf_base <= ref_planes[72 * (3 * int'(slot) + int'(mc_pl)) +: 40];
                    rf_stride <= ref_planes[72 * (3 * int'(slot) + int'(mc_pl)) + 40 +: 32];
                    dw = ref_dims[32 * int'(slot) +: 16]; dh = ref_dims[32 * int'(slot) + 16 +: 16];
                    if (mc_ibc) begin
                        // intra block copy (7.11.3.2, refIdx -1): the current picture's own flush layout; RefUpscaledWidth[-1]
                        // = MiCols * MI_SIZE, the height likewise (the decoded area, not the visible picture)
                        rf_base <= cur_planes[72 * int'(mc_pl) +: 40];
                        rf_stride <= cur_planes[72 * int'(mc_pl) + 40 +: 32];
                        dw = 16'(hdr.mi_cols) << 2; dh = 16'(hdr.mi_rows) << 2;
                    end
                    rf_lastx <= ((dw + 16'(mc_sx)) >> mc_sx) - 16'd1; rf_lasty <= ((dh + 16'(mc_sy)) >> mc_sy) - 16'd1;
                    rf_lst <= mc_l;
                    // every request: all rows from ref_fetch (the intra block copy split below overrides). These were set only on
                    // the unscaled path, so a scaled-reference or warp strip kept the row range of the last intra block copy:
                    // after a copy from the picture's top edge (kk = 3) the next scaled strip fetched a three-row patch
                    // (2026-10-31: test5466 frame 4 after test5366's 2048-wide copy frames on the card; random-init sims too).
                    rf_r_lo <= 7'd0; rf_r_hi <= 7'd0; ff_r_lo <= 7'd0; ff_r_hi <= 7'd0;
                    mc_mode <= ob_active ? 3'd0 : mc_l ? (mb_active ? 3'd4 : 3'(mc_bmode)) : (mc_comp ? 3'd1 : 3'd0);
                    mc_warp <= unit_warp && w_use[mc_l];
                    if (unit_warp && w_use[mc_l]) begin
                        // block_warp (7.11.3.5): the 8x8's centre in luma units through the affine model (16.16);
                        // the integer / fractional parts and the 15 x 15 region come in B_MC_STRIP2
                        srcx = 22'((22'(px) + 22'd4) << mc_sx); srcy = 22'((22'(py) + 22'd4) << mc_sy);
                        sc_bx <= 39'(w_p[mc_l][2]) * 39'(srcx) + 39'(w_p[mc_l][3]) * 39'(srcy) + 39'(w_p[mc_l][0]);
                        sc_by <= 39'(w_p[mc_l][4]) * 39'(srcx) + 39'(w_p[mc_l][5]) * 39'(srcy) + 39'(w_p[mc_l][1]);
                        sc_xs <= 12'd1024; sc_ys <= 12'd1024; mc_xf0 <= 10'd32; mc_yf0 <= 10'd32;
                        rf_w <= 7'd8; rf_h <= 7'd8;
                    end else if (!mc_scl) begin
                        mc_xf0 <= {mvx2[3:0], 6'b100000}; mc_yf0 <= {mvy2[3:0], 6'b100000}; sc_xs <= 12'd1024; sc_ys <= 12'd1024;
                        rf_x0 <= 17'(signed'({2'b0, px})) + 17'(mvx2 >>> 4);
                        rf_y0 <= 17'(signed'({2'b0, py})) + 17'(mvy2 >>> 4);
                        rf_w <= sw; rf_h <= sh;
                        if (mc_ibc) begin
                            // the patch rows [0, k) lie above the fb0 ring (flushed: DDR through ref_fetch), [k, h + 7) are still
                            // in it (the ring loader). Row q of the ring is reused only once flushed, so every row is in one of
                            // the two; the spec's 256-sample delay keeps the ring rows already reconstructed.
                            logic [15:0] sbr, yb;
                            logic signed [17:0] y0m3, kk;
                            logic [6:0] nrow;
                            sbr = 16'(b.r) >> (hdr.sb128 ? 5 : 4);                                 // this block's superblock row
                            yb = (FRAME_WIN == 0 || sbr + 16'd1 <= 16'(FRAME_WIN)) ? 16'd0
                               : 16'((sbr + 16'd1 - 16'(FRAME_WIN)) << (hdr.sb128 ? 7 : 6)) >> mc_sy;  // first line still in the ring
                            y0m3 = 18'(signed'({1'b0, py})) + 18'(mvy2 >>> 4) - 18'sd3;
                            nrow = sh + 7'd7;
                            kk = 18'(signed'({2'b0, yb})) - y0m3;
                            if (kk < 18'sd0) kk = 18'sd0;
                            if (kk > 18'(signed'({11'd0, nrow}))) kk = 18'(signed'({11'd0, nrow}));
                            // Nothing flushed yet (yb == 0: the whole-picture build, or the first FRAME_WIN superblock rows): every
                            // patch row is in fb0, including the rows above the picture, which clamp to line 0 and line 0 is in
                            // the ring. The difference alone gave kk = -y0m3 > 0 for a source at the top edge and sent ref_fetch
                            // to DDR for rows the picture has not flushed (2026-10-31: test4592, a 969x128 intrabc frame, hung the
                            // nightly's whole-picture harness, which has no AXI slave, 10.5 h in B_MC_FETCH; the inter harness
                            // passed because the copy never reads the 3 margin rows). With rows flushed (yb > 0) line 0 is in DDR
                            // and the difference counts the clamped rows correctly.
                            if (yb == 16'd0) kk = 18'sd0;
                            rf_r_lo <= 7'd0; rf_r_hi <= 7'(kk); ff_r_lo <= 7'(kk); ff_r_hi <= nrow;
                        end else begin
                            rf_r_lo <= 7'd0; rf_r_hi <= 7'd0;                                       // all rows
                        end
                    end else begin
                        // origX = (x << 4) + ((2 mv) >> subX) + 8 for the unit; baseX = origX * xScale - (8 << 14)
                        xsc = ref_scales[32 * int'(slot) +: 16]; ysc = ref_scales[32 * int'(slot) + 16 +: 16];
                        ox = (22'(signed'({7'b0, mc_ux})) <<< 4) + 22'(mvx2) + 22'sd8;
                        oy = (22'(signed'({7'b0, mc_uy})) <<< 4) + 22'(mvy2) + 22'sd8;
                        sc_bx <= ox * 39'(signed'({1'b0, xsc})) - 39'sd131072;
                        sc_by <= oy * 39'(signed'({1'b0, ysc})) - 39'sd131072;
                        sc_xs <= 12'((xsc + 16'd8) >> 4); sc_ys <= 12'((ysc + 16'd8) >> 4);         // Round2Signed(xScale, 4)
                    end
                    bst <= B_MC_STRIP2;
                end
                B_MC_STRIP2: begin
                    if (mc_warp) begin
                        logic signed [38:0] x4, y4;
                        x4 = sc_bx >>> mc_sx; y4 = sc_by >>> mc_sy;
                        rf_x0 <= 17'(x4 >>> 16) - 17'sd4; rf_y0 <= 17'(y4 >>> 16) - 17'sd4;    // the patch starts at ix4 - 7
                        mc_wsx <= x4[15:0]; mc_wsy <= y4[15:0];
                    end else if (mc_scl) begin
                        // startX = Round2Signed(baseX, 8) + 32, then the strip's offset in steps; the patch covers
                        // (((w - 1) xStep + 1023) >> 10) + 8 reference columns (rows likewise): ref_fetch's w + 7
                        logic signed [31:0] stx, sty;
                        logic [18:0] cw, ch;
                        // the strip's offset in steps: strips are 32 wide in a frame with scaled references, but 8 wide when
                        // the unit's other list warps (unit_warp): test10310 frame 2, GLOBAL_GLOBALMV compound of a global
                        // warp (list 0) and a 5.5x scaled reference (list 1), read 32 px too far from the second strip on
                        stx = round2s8(sc_bx) + 32'sd32 + 32'(signed'({20'b0, sc_xs})) * 32'(signed'(32'(mc_sc) << (unit_warp ? 3 : 5)));
                        sty = round2s8(sc_by) + 32'sd32 + 32'(signed'({20'b0, sc_ys})) * 32'(signed'(32'(mc_sr) << (unit_warp ? 3 : 5)));
                        rf_x0 <= 17'(stx >>> 10); rf_y0 <= 17'(sty >>> 10);
                        mc_xf0 <= stx[9:0]; mc_yf0 <= sty[9:0];
                        cw = 19'(sc_sw - 7'd1) * 19'(sc_xs) + 19'd1023; ch = 19'(sc_sh - 7'd1) * 19'(sc_ys) + 19'd1023;
                        rf_w <= 7'(cw[18:10] + 9'd1); rf_h <= 7'(ch[18:10] + 9'd1);
                    end
                    rf_req_valid <= !mc_ibc || (rf_r_hi != 7'd0);
                    rf_wait <= !mc_ibc || (rf_r_hi != 7'd0);
                    ff_pend <= mc_ibc && (ff_r_lo != ff_r_hi); ff_wait <= mc_ibc && (ff_r_lo != ff_r_hi);
                    ibc_buf <= pbuf; ibc_has_rf <= (rf_r_hi != 7'd0); ibc_acc <= 1'b0;
                    bst <= B_MC_FETCH;
                end
                B_MC_FETCH: begin
                    // Issue thread (step C2): the engine accepts the request once its address side is idle and the run queue has
                    // room; the run is queued (the run thread starts it when its patch is in) and the strip iteration moves on.
                    // The intra block copy keeps the serial handoff: ref_fetch first, the ring loader after it (they share
                    // mc_filt's patch write port), the run queued once both are in.
                    if (rf_req_valid && rf_req_ready && !pq_full) begin
                        rf_req_valid <= 1'b0; rf_wait <= 1'b0; acc_cnt <= acc_cnt + 3'd1; pbuf <= !pbuf;
                        if (mc_ibc) begin ibc_acc <= 1'b1; ibc_seq <= acc_cnt; end
                        else begin
                            pq_has_rf[pq_t[0]] <= 1'b1; pq_seq[pq_t[0]] <= acc_cnt; pq_buf[pq_t[0]] <= pbuf; pq_last[pq_t[0]] <= 1'b0; pq_par[pq_t[0]] <= cur_par;
                            pq_l[pq_t[0]] <= mc_l; pq_warp[pq_t[0]] <= mc_warp; pq_sw[pq_t[0]] <= mc_sw; pq_sh[pq_t[0]] <= mc_sh;
                            pq_i0[pq_t[0]] <= u_i0; pq_i1[pq_t[0]] <= u_i1; pq_xf0[pq_t[0]] <= mc_xf0; pq_yf0[pq_t[0]] <= mc_yf0; pq_xs[pq_t[0]] <= sc_xs; pq_ys[pq_t[0]] <= sc_ys;
                            pq_wa[pq_t[0]] <= w_al[mc_l]; pq_wb[pq_t[0]] <= w_be[mc_l]; pq_wg[pq_t[0]] <= w_ga[mc_l]; pq_wd[pq_t[0]] <= w_de[mc_l]; pq_wsx[pq_t[0]] <= mc_wsx; pq_wsy[pq_t[0]] <= mc_wsy;
                            pq_mode[pq_t[0]] <= mc_mode; pq_wt0[pq_t[0]] <= mc_wt0; pq_wt1[pq_t[0]] <= mc_wt1;
                            pq_px[pq_t[0]] <= mc_px; pq_py[pq_t[0]] <= mc_py; pq_bx[pq_t[0]] <= mc_bx; pq_by[pq_t[0]] <= mc_by; pq_pl[pq_t[0]] <= mc_pl;
                            pq_sx[pq_t[0]] <= mc_sx; pq_sy[pq_t[0]] <= mc_sy;
                            pq_ob_active[pq_t[0]] <= ob_active; pq_ob_pass[pq_t[0]] <= ob_pass; pq_ob_mlen[pq_t[0]] <= ob_mlen;
                            pq_ii_active[pq_t[0]] <= ii_active; pq_ii_wedge[pq_t[0]] <= ii_wedge; pq_ii_mode[pq_t[0]] <= ii_mode; pq_ii_lsh[pq_t[0]] <= ii_lsh;
                            pq_mb_active[pq_t[0]] <= mb_active; pq_mb_diff[pq_t[0]] <= mb_diff; pq_post[pq_t[0]] <= mc_post; pq_mask_type[pq_t[0]] <= b.mask_type;
                            pq_t <= pq_t + 2'd1;
                            bst <= B_MC_NEXT;
                        end
                    end
                    if (mc_ibc) begin
                        logic rf_in;
                        logic [2:0] d;
                        d = done_cnt - ibc_seq;
                        rf_in = !ibc_has_rf || (ibc_acc && (d == 3'd1 || d == 3'd2));       // the DDR rows are written (the writer is idle)
                        if (ff_done) ff_wait <= 1'b0;
                        if (ff_req_valid && ff_req_ready) ff_req_valid <= 1'b0;
                        if (ff_pend && rf_in) begin ff_req_valid <= 1'b1; ff_pend <= 1'b0; end
                        if (rf_in && !ff_pend && !ff_req_valid && !(ff_wait && !ff_done) && !pq_full) begin
                            pq_has_rf[pq_t[0]] <= ibc_has_rf; pq_seq[pq_t[0]] <= ibc_seq; pq_buf[pq_t[0]] <= ibc_buf; pq_last[pq_t[0]] <= 1'b0; pq_par[pq_t[0]] <= cur_par;
                            pq_l[pq_t[0]] <= mc_l; pq_warp[pq_t[0]] <= mc_warp; pq_sw[pq_t[0]] <= mc_sw; pq_sh[pq_t[0]] <= mc_sh;
                            pq_i0[pq_t[0]] <= u_i0; pq_i1[pq_t[0]] <= u_i1; pq_xf0[pq_t[0]] <= mc_xf0; pq_yf0[pq_t[0]] <= mc_yf0; pq_xs[pq_t[0]] <= sc_xs; pq_ys[pq_t[0]] <= sc_ys;
                            pq_wa[pq_t[0]] <= w_al[mc_l]; pq_wb[pq_t[0]] <= w_be[mc_l]; pq_wg[pq_t[0]] <= w_ga[mc_l]; pq_wd[pq_t[0]] <= w_de[mc_l]; pq_wsx[pq_t[0]] <= mc_wsx; pq_wsy[pq_t[0]] <= mc_wsy;
                            pq_mode[pq_t[0]] <= mc_mode; pq_wt0[pq_t[0]] <= mc_wt0; pq_wt1[pq_t[0]] <= mc_wt1;
                            pq_px[pq_t[0]] <= mc_px; pq_py[pq_t[0]] <= mc_py; pq_bx[pq_t[0]] <= mc_bx; pq_by[pq_t[0]] <= mc_by; pq_pl[pq_t[0]] <= mc_pl;
                            pq_sx[pq_t[0]] <= mc_sx; pq_sy[pq_t[0]] <= mc_sy;
                            pq_ob_active[pq_t[0]] <= ob_active; pq_ob_pass[pq_t[0]] <= ob_pass; pq_ob_mlen[pq_t[0]] <= ob_mlen;
                            pq_ii_active[pq_t[0]] <= ii_active; pq_ii_wedge[pq_t[0]] <= ii_wedge; pq_ii_mode[pq_t[0]] <= ii_mode; pq_ii_lsh[pq_t[0]] <= ii_lsh;
                            pq_mb_active[pq_t[0]] <= mb_active; pq_mb_diff[pq_t[0]] <= mb_diff; pq_post[pq_t[0]] <= mc_post; pq_mask_type[pq_t[0]] <= b.mask_type;
                            pq_t <= pq_t + 2'd1;
                            if (!ibc_has_rf) pbuf <= !pbuf;
                            bst <= B_MC_NEXT;
                        end
                    end
                end
                B_MC_NEXT: begin
                    // all strips of the unit first (an OBMC neighbour unit is up to 64 tall / wide: two strips in a frame
                    // with scaled references), then the other list, the next OBMC neighbour, the next unit
                    if (mc_comp && !mc_l) begin mc_l <= 1'b1; bst <= B_MC_STRIP; end
                    else if (mc_sc + 5'd1 < mc_nsc) begin mc_sc <= mc_sc + 5'd1; mc_l <= 1'b0; bst <= B_MC_STRIP; end
                    else if (mc_sr + 5'd1 < mc_nsr) begin mc_sc <= 5'd0; mc_sr <= mc_sr + 5'd1; mc_l <= 1'b0; bst <= B_MC_STRIP; end
                    else if (ob_active) begin ob_k <= ob_k + 3'd1; bst <= B_MC_OB; end
                    else if (mc_uj + 2'd1 < mc_uc) begin mc_uj <= mc_uj + 2'd1; bst <= B_MC_UNIT; end
                    else if (mc_ui + 2'd1 < mc_ur) begin mc_uj <= 2'd0; mc_ui <= mc_ui + 2'd1; bst <= B_MC_UNIT; end
                    else bst <= B_MC_PLEND;
                end
                B_MC_PLEND: begin
                    if (b.motion_mode == 2'd1 && !b.intrabc && !ob_done) begin ob_done <= 1'b1; ob_pass <= 1'b0; ob_k <= 3'd0; bst <= B_MC_OB; end
                    else begin
                        ob_done <= 1'b0; ob_active <= 1'b0;
                        if (mc_pl < (b.has_chroma ? 2'd2 : 2'd0)) begin mc_pl <= mc_pl + 2'd1; bst <= B_MC_PL; end
                        else bst <= B_MC_DRAIN;
                    end
                end
                B_MC_DRAIN: begin
                    // the block's last run: still queued (the newest entry is this block's and not starting now: its start pulses
                    // blk_last_run_q with the block's parity), else started already or starting this cycle
                    if (!pq_empty && pq_par[!pq_t[0]] == cur_par && !(pq_n == 2'd1 && run_go)) pq_last[!pq_t[0]] <= 1'b1;
                    else blk_last_run <= 1'b1;
                    bst <= B_IDLE;
                end
                B_MC_OB: begin
                    // the next overlap neighbour of this pass (above: entries 0 .. 3, needs the plane block >= BLOCK_8X8; left: 4 .. 7)
                    logic [50:0] e;
                    logic [7:0] pw, ph, sw4;
                    e = b.obmc[51 * (int'(ob_pass) * 4 + int'(ob_k)) +: 51];
                    ob_active <= 1'b1;
                    if (ob_k == 3'd4 || !e[0] || (!ob_pass && mc_psz < 5'd3)) begin
                        if (!ob_pass) begin ob_pass <= 1'b1; ob_k <= 3'd0; end
                        else begin ob_active <= 1'b0; bst <= B_MC_PLEND; end
                    end else begin
                        sw4 = 8'(e[10:6]) << 2;                                         // step4 * MI_SIZE
                        if (!ob_pass) begin
                            pw = (sw4 >> mc_sx); if (pw > mc_pw) pw = mc_pw;             // min(w, (step4 * 4) >> subX)
                            ph = (8'd32 >> mc_sy); if (ph > (mc_ph >> 1)) ph = mc_ph >> 1; // min(h >> 1, 32 >> subY)
                            mc_ux <= mc_bx + PXW'((PXW'(e[5:1]) << 2) >> mc_sx); mc_uy <= mc_by;
                            ob_mlen <= 6'(ph);
                        end else begin
                            pw = (8'd32 >> mc_sx); if (pw > (mc_pw >> 1)) pw = mc_pw >> 1;
                            ph = (sw4 >> mc_sy); if (ph > mc_ph) ph = mc_ph;
                            mc_ux <= mc_bx; mc_uy <= mc_by + PXW'((PXW'(e[5:1]) << 2) >> mc_sy);
                            ob_mlen <= 6'(pw);
                        end
                        mc_uw <= pw; mc_uh <= ph;
                        u_ref0 <= e[14:11]; u_mv0r <= e[30:15]; u_mv0c <= e[46:31]; u_i0 <= e[48:47]; u_i1 <= e[50:49];
                        unit_warp <= 1'b0;                                           // OBMC neighbour predictions never warp
                        mc_nsc <= mc_scl ? 5'((pw + 8'd31) >> 5) : 5'd1; mc_nsr <= mc_scl ? 5'((ph + 8'd31) >> 5) : 5'd1;
                        mc_sr <= 5'd0; mc_sc <= 5'd0; mc_l <= 1'b0;
                        bst <= B_MC_STRIP;
                    end
                end
                default: bst <= B_IDLE;
            endcase
        end else case (bst)
            B_IDLE: if (blk_take) begin
                b <= ev_blk; bq[!cur_par] <= ev_blk; cur_par <= !cur_par; bst <= B_FT0;
            end
            // four neighbour-mode reads (issued by the combinational mm_addr; captured in the following state):
            // above Y, left Y, above UV, left UV
            B_FT0: if (!mi_blk_busy && !mi_blk_we) begin mi_blk_we <= 1'b1; mi_cd_we <= b.cdef_valid; bst <= B_FT1; end   // per-4x4 LF state + cdef_idx
            B_FT1: begin nb_ay <= mm_rdata[8 * b.c[3:0] +: 8]; bst <= B_FT2; end
            B_FT2: begin nb_ly <= mm_rdata[8 * 4'(b.c - MIW'(1)) +: 8]; bst <= B_FT3; end
            B_FT3: begin nb_auv <= mm_rdata[8 * a_c_uv[3:0] +: 8]; bst <= B_FT4; end
            B_FT4: begin
                nb_luv <= mm_rdata[8 * l_c_uv[3:0] +: 8];
                ftq_y[cur_par] <= (av_u && is_smooth(nb_ay[3:0])) || (av_l && is_smooth(nb_ly[3:0]));
                wr_i <= 6'd0; wr_j <= 1'b0;
                bst <= B_WR;                             // mm_addr = first word to merge into; read lands in B_WR
            end
            B_WR: begin
                if (wr_i == 6'd0 && !wr_j) ftq_uv[cur_par] <= (av_uc && is_smooth(nb_auv[7:4])) || (av_lc && is_smooth(nb_luv[7:4]));
                mm_we <= 1'b1; mm_waddr <= mm_addr;
                mm_wdata <= mm_merge(mm_rdata, wr_j ? 4'd0 : b.c[3:0], wr_n, {b.uvmode, b.ymode[3:0]});
                bst <= B_WR_W;
            end
            B_WR_W: begin
                // advance: second word of a >16-wide block, next row, or done (the next word's read is in flight)
                if (bw4 > 6'd16 && !wr_j) begin
                    wr_j <= 1'b1; bst <= B_WR;
                end else if (wr_i + 6'd1 < bh4) begin
                    wr_j <= 1'b0; wr_i <= wr_i + 6'd1; bst <= B_WR;
                end else if (b.intrabc) begin
                    bst <= (INTER != 0) ? B_MC_INIT : B_IBC_INIT;        // with inter built: through the MC path (patch loaders)
                end else if (blk_inter) begin
                    bst <= B_MC_INIT;
                end else if (pred_done[!cur_par]) begin         // intra: its edge reads need the previous block landed
                    blk_ready_set <= 1'b1; bst <= B_IDLE;
                end
            end
            // ---- intra block copy prediction, one plane at a time, one output sample per 4-5 cycles
            B_IBC_INIT: if (rs == R_IDLE) begin ib_pl <= 2'd0; bst <= B_IBC_PL; end
            B_IBC_PL: begin
                logic [4:0] psz;
                logic signed [19:0] mvx2, mvy2;
                psz = subsampled_size(b.bsize, ibc_sx, ibc_sy);
                ib_w <= 8'(num4x4w(psz)) << 2; ib_h <= 8'(num4x4h(psz)) << 2;
                ib_bx <= PXW'((PXW'(b.c) >> ibc_sx) << 2); ib_by <= PXW'((PXW'(b.r) >> ibc_sy) << 2);
                mvx2 = (20'(b.mv_col) * 20'sd2) >>> ibc_sx;                   // (2 * mv[1]) >> subX
                mvy2 = (20'(b.mv_row) * 20'sd2) >>> ibc_sy;
                ib_fx <= mvx2[3:0]; ib_fy <= mvy2[3:0];                       // (p >> 6) & SUBPEL_MASK
                ib_x0 <= PXS'(signed'({2'b0, PXW'((PXW'(b.c) >> ibc_sx) << 2)})) + PXS'(mvx2 >>> 4);
                ib_y0 <= PXS'(signed'({2'b0, PXW'((PXW'(b.r) >> ibc_sy) << 2)})) + PXS'(mvy2 >>> 4);
                ib_lastx <= PXW'((((PXW'(hdr.mi_cols) << 2) + PXW'(ibc_sx)) >> ibc_sx) - PXW'(1));   // RefUpscaledWidth[-1] = MiCols * MI_SIZE
                ib_lasty <= PXW'((((PXW'(hdr.mi_rows) << 2) + PXW'(ibc_sy)) >> ibc_sy) - PXW'(1));
                ib_i <= 8'd0; ib_j <= 8'd0;
                bst <= B_IBC_R0;
            end
            B_IBC_R0: bst <= B_IBC_R1;
            B_IBC_R1: bst <= B_IBC_R2;                                      // sample reads land two cycles after they are issued
            B_IBC_R2: begin ib_s0 <= fb_rdata; bst <= B_IBC_R3; end
            B_IBC_R3: begin ib_s1 <= fb_rdata; bst <= B_IBC_R4; end
            B_IBC_R4: begin ib_s2 <= fb_rdata; bst <= B_IBC_R5; end
            B_IBC_R5: begin ib_s3 <= fb_rdata; bst <= B_IBC_WR; end     // the fourth sample lands here, the filter and the
                                                                       // write run from registers (the UltraRAM read into the
                                                                       // bilinear filter and the write capture was 22 levels)
            B_IBC_WR: begin
                if (ib_j + 8'd1 < ib_w) begin ib_j <= ib_j + 8'd1; bst <= B_IBC_R0; end
                else if (ib_i + 8'd1 < ib_h) begin ib_j <= 8'd0; ib_i <= ib_i + 8'd1; bst <= B_IBC_R0; end
                else if (ib_pl < (b.has_chroma ? 2'd2 : 2'd0)) begin ib_pl <= ib_pl + 2'd1; bst <= B_IBC_PL; end
                else if (pred_done[!cur_par]) begin blk_ready_set <= 1'b1; bst <= B_IDLE; end
            end
            default: bst <= B_IDLE;
        endcase
    end

    // warp_setup: the affine parameters and shear of the list being set up (B_MC_WSET); local from the record's
    // least-squares sums (list 0, LOCALWARP), global from ihdr.gm_params of the list's reference
    assign ws_ref = wl ? b.ref1 : b.ref0;
    assign ws_midx = 16'({b.c, 2'b00}) + 16'({bw4, 1'b0}) - 16'd1;
    assign ws_midy = 16'({b.r, 2'b00}) + 16'({bh4, 1'b0}) - 16'd1;
    assign ws_gm = ihdr.gm_params[144 * (int'(ws_ref) - 1) +: 144];
    generate if (INTER != 0) begin : g_ws
    warp_setup u_ws (
        .clk, .rst, .start(ws_start), .mode(ws_mode),
        .ls_a00(b.ls[0 +: 32]), .ls_a01(b.ls[32 +: 32]), .ls_a11(b.ls[64 +: 32]), .ls_bx0(b.ls[96 +: 32]),
        .ls_bx1(b.ls[128 +: 32]), .ls_by0(b.ls[160 +: 32]), .ls_by1(b.ls[192 +: 32]),
        .mv_row(16'(b.mv_row)), .mv_col(16'(b.mv_col)), .mid_x(ws_midx), .mid_y(ws_midy), .gm_p(ws_gm),
        .busy(ws_busy), .done(ws_done), .valid(ws_valid), .p(ws_p),
        .alpha(ws_alpha), .beta(ws_beta), .gamma(ws_gamma), .delta(ws_delta));
    end else begin : g_nows
        assign ws_busy = 1'b0; assign ws_done = 1'b0; assign ws_valid = 1'b0; assign ws_p = '0;
        assign ws_alpha = '0; assign ws_beta = '0; assign ws_gamma = '0; assign ws_delta = '0;
    end endgenerate

    // OBMC read-modify-write pipeline: A = the prediction group and its mask values (the frame memory read is issued
    // from these registers), B = the blended group to write. One group per cycle.
    logic [PXW-1:0] mb_bx, mb_by;                            // block-relative position of the output group (plane samples)
    assign mb_bx = r_px - r_bx + PXW'(mc_out_x);
    assign mb_by = r_py - r_by + PXW'(mc_out_y);
    logic [6:0]  mb_wm [4];                                  // the mask values of the A group's lanes, from the banks
    always_ff @(posedge clk) begin
        ob_rd_v <= 1'b0; ob_rd2_v <= 1'b0; ob_rd3_v <= 1'b0; ob_wr_v <= 1'b0;
        if (!rst) begin
            if (mc_out_valid && (r_ob_active || r_ii_active)) begin
                ob_rd_v <= 1'b1;
                ob_a_pix <= mc_out_pix4 << (12 * mc_osh);
                ob_a_be <= mc_out_mask << mc_osh;
                ob_a_x <= {mc_ox[PXW-1:2], 2'b00}; ob_a_y <= r_py + PXW'(mc_out_y);
                for (int l = 0; l < 4; l++) begin
                    logic [6:0] i, j;
                    i = 7'(mb_by); j = 7'(mb_bx) + 7'(l) - 7'(mc_osh);                     // block-relative position (plane samples)
                    if (r_ob_active) ob_a_m[l] <= r_ob_pass ? obmc_mask(r_ob_mlen, 6'(mc_out_x + 7'(l) - 7'(mc_osh))) : obmc_mask(r_ob_mlen, 6'(mc_out_y));
                    else if (r_ii_wedge) ob_a_m[l] <= 7'd0;                                  // from the wedge buffer, in the A cycle
                    else case (r_ii_mode)
                        4'd1: ob_a_m[l] <= ii_weight(i << r_ii_lsh);                          // II_V_PRED
                        4'd2: ob_a_m[l] <= ii_weight(j << r_ii_lsh);                          // II_H_PRED
                        4'd9: ob_a_m[l] <= ii_weight(((i < j) ? i : j) << r_ii_lsh);          // II_SMOOTH_PRED
                        default: ob_a_m[l] <= 7'd32;                                        // II_DC_PRED
                    endcase
                end
            end
            // the frame memory read issued from the A registers lands two cycles later (two-cycle read since 2026-10-31):
            // A2 and A3 hold the group meanwhile, and the blend uses fb_rdata4 in the A3 cycle
            ob_rd2_v <= ob_rd_v; ob_a2_pix <= ob_a_pix; ob_a2_x <= ob_a_x; ob_a2_y <= ob_a_y; ob_a2_be <= ob_a_be;
            if (r_ii_active && r_ii_wedge) ob_a2_m <= mb_wm;                                   // the wedge buffer's values for the A group
            else ob_a2_m <= ob_a_m;
            ob_rd3_v <= ob_rd2_v; ob_a3_pix <= ob_a2_pix; ob_a3_x <= ob_a2_x; ob_a3_y <= ob_a2_y; ob_a3_be <= ob_a2_be; ob_a3_m <= ob_a2_m;
            if (ob_rd3_v) begin
                ob_wr_v <= 1'b1; ob_b_x <= ob_a3_x; ob_b_y <= ob_a3_y; ob_b_be <= ob_a3_be;
                for (int l = 0; l < 4; l++) begin
                    logic [19:0] v;
                    v = 20'(ob_a3_m[l]) * 20'(fb_rdata4[l*12 +: 12]) + (20'd64 - 20'(ob_a3_m[l])) * 20'(ob_a3_pix[l*12 +: 12]);
                    ob_b_pix[l*12 +: 12] <= 12'((v + 20'd32) >> 6);
                end
            end
        end
    end

    // mask bank ports: the wedge fill (B_MC_MASK) writes four luma samples a cycle; a masked block's pair output reads
    // the mask of its group in the same cycle (luma: one value per lane; 4:2:0 chroma: the four luma values of each
    // lane's 2x2 -> both row-parity banks, two column words per x bank; 4:2:2: the two of its row) and, for DIFFWTD
    // luma, writes the mask it computes from the pair. The data lands with the A stage, which blends; B writes.
    logic [6:0] mb_dm [4];                                   // DIFFWTD luma: the mask of the current group
    logic [6:0] wv [4];                                      // the wedge fill's four master values
    always_comb begin
        logic [10:0] rowbase, colw;
        rowbase = 11'd0; colw = 11'd0;
        for (int k = 0; k < 8; k++) begin mk_we[k] = 1'b0; mk_waddr[k] = 11'd0; mk_wdata[k] = 7'd0; mk_ra0[k] = 11'd0; mk_ra1[k] = 11'd0; end
        for (int l = 0; l < 4; l++) mb_dm[l] = 7'd0;
        for (int l = 0; l < 4; l++) wv[l] = wedge_master(mk_d, 6'(mk_yoff + 6'(mk_y)), 6'(mk_xoff + 6'(mk_x) + 6'(l)));
        if (bst == B_MC_MASK && !mk_hold) begin
            for (int l = 0; l < 4; l++) begin
                mk_we[(mk_y[0] ? 4 : 0) + l] = 1'b1;
                mk_waddr[(mk_y[0] ? 4 : 0) + l] = 11'(mk_y[6:1]) * 11'd32 + 11'(mk_x[6:2]);
                mk_wdata[(mk_y[0] ? 4 : 0) + l] = mk_inv ? 7'd64 - wv[l] : wv[l];
            end
        end
        if (mc_out_valid && (r_mb_active || (r_ii_active && r_ii_wedge))) begin
            if (r_pl == 2'd0 || !(r_sx || r_sy)) begin
                // luma (or 4:4:4 chroma): the row's parity banks, one lane per x bank
                rowbase = 11'(mb_by[PXW-1:1]) * 11'd32 + 11'(mb_bx[PXW-1:2]);
                for (int l = 0; l < 4; l++) begin
                    mk_ra0[(mb_by[0] ? 4 : 0) + l] = rowbase;
                    if (r_pl == 2'd0 && r_mb_active && r_mb_diff) begin
                        mb_dm[l] = diff_mask(signed'(mc_out_pair[17*l +: 17]), signed'(mc_out_pair[68 + 17*l +: 17]), hdr.bit_depth, r_post, r_mask_type);
                        mk_we[(mb_by[0] ? 4 : 0) + l] = 1'b1; mk_waddr[(mb_by[0] ? 4 : 0) + l] = rowbase; mk_wdata[(mb_by[0] ? 4 : 0) + l] = mb_dm[l];
                    end
                end
            end else begin
                // subsampled chroma: luma columns 2x .. 2x + 7 = column words 2k and 2k + 1 of every x bank (k = x >> 2)
                colw = 11'(mb_bx[PXW-1:2]) << 1;
                if (r_sy) begin                                   // 4:2:0: luma rows 2y and 2y + 1 = row word y, both parities
                    rowbase = 11'(mb_by) * 11'd32;
                    for (int k = 0; k < 8; k++) begin mk_ra0[k] = rowbase + colw; mk_ra1[k] = rowbase + colw + 11'd1; end
                end else begin                                     // 4:2:2: luma row y, its parity's banks
                    rowbase = 11'(mb_by[PXW-1:1]) * 11'd32;
                    for (int k = 0; k < 4; k++) begin mk_ra0[(mb_by[0] ? 4 : 0) + k] = rowbase + colw; mk_ra1[(mb_by[0] ? 4 : 0) + k] = rowbase + colw + 11'd1; end
                end
            end
        end
    end
    // the masked blend pipeline: A (the mask data of the group lands, blend), B (write)
    logic        mb_a_sub, mb_a_sy, mb_a_p;                  // the A group's plane kind: subsampled, 4:2:0, row parity
    logic [8:0] mb_sum4 [4], mb_sum2 [4];                    // the 4:2:0 / 4:2:2 luma sums of each lane's group
    always_comb begin
        int hi;
        hi = mb_a_p ? 4 : 0;
        for (int l = 0; l < 4; l++) begin
            int lo;
            lo = ((l & 1) != 0) ? 2 : 0;                          // lanes 0, 2 use x banks 0 / 1; lanes 1, 3 use 2 / 3
            mb_sum4[l] = (l < 2) ? 9'(mk_q0[lo]) + 9'(mk_q0[lo + 1]) + 9'(mk_q0[4 + lo]) + 9'(mk_q0[5 + lo])
                                 : 9'(mk_q1[lo]) + 9'(mk_q1[lo + 1]) + 9'(mk_q1[4 + lo]) + 9'(mk_q1[5 + lo]);
            mb_sum2[l] = (l < 2) ? 9'(mk_q0[hi + lo]) + 9'(mk_q0[hi + lo + 1]) : 9'(mk_q1[hi + lo]) + 9'(mk_q1[hi + lo + 1]);
            if (!mb_a_sub) mb_wm[l] = mk_q0[hi + l];
            else if (mb_a_sy) mb_wm[l] = 7'((mb_sum4[l] + 9'd2) >> 2);   // 4:2:0: four values, column word by lane >> 1
            else mb_wm[l] = 7'((mb_sum2[l] + 9'd1) >> 1);                 // 4:2:2: two values of the row's parity
        end
    end
    logic [6:0]  mb_a_dm [4];
    always_ff @(posedge clk) begin
        mb_a_v <= 1'b0; mb_b_v <= 1'b0;
        if (!rst) begin
            if (mc_out_valid && (r_ii_active && r_ii_wedge)) begin                  // flags only: the RMW path blends
                mb_a_sub <= (r_pl != 2'd0) && (r_sx || r_sy); mb_a_sy <= r_sy; mb_a_p <= mb_by[0];
            end
            if (mc_out_valid && r_mb_active) begin
                mb_a_v <= 1'b1; mb_a_pair <= mc_out_pair;
                mb_a_x <= {mc_ox[PXW-1:2], 2'b00}; mb_a_y <= r_py + PXW'(mc_out_y); mb_a_be <= mc_out_mask << mc_osh;
                mb_a_sub <= (r_pl != 2'd0) && (r_sx || r_sy); mb_a_sy <= r_sy; mb_a_p <= mb_by[0];
                mb_a_dm <= mb_dm;
            end
            if (mb_a_v) begin
                mb_b_v <= 1'b1; mb_b_x <= mb_a_x; mb_b_y <= mb_a_y; mb_b_be <= mb_a_be;
                for (int l = 0; l < 4; l++) begin
                    logic [6:0] m;
                    logic signed [23:0] v;
                    logic signed [16:0] p0, p1;
                    m = (r_pl == 2'd0 && r_mb_diff) ? mb_a_dm[l] : mb_wm[l];
                    p0 = signed'(mb_a_pair[17*l +: 17]); p1 = signed'(mb_a_pair[68 + 17*l +: 17]);
                    v = (24'(signed'({1'b0, m})) * 24'(p0) + 24'(signed'({1'b0, 7'd64 - m})) * 24'(p1) + (24'sd1 <<< (r_post + 4'd5))) >>> (r_post + 4'd6);
                    mb_b_pix[l*12 +: 12] <= (v < 24'sd0) ? 12'd0 : (v > 24'(pix_max)) ? pix_max : 12'(v);
                end
            end
        end
    end

    // ================================================================ BlockDecoded flags + MaxLuma
    // [plane][y+1] is a 34-bit row, bit x+1, for y,x in -1..32. Rows, not bits, are the unit of update: a
    // transform block marks its area with up to 16 row ORs of a shifted mask. (Per-bit writes with computed
    // indices were 256 decoders over 3,468 cells and synthesis never finished.)
    // [plane][y+1] is a 34-bit row, bit x+1, for y,x in -1..32: 102 rows (plane*34 + y+1) in a dual-read
    // distributed RAM. A row not written since the superblock start reads as its 5.11.3 initial value
    // (bdf_wr tracks that), so sb_start clears 102 bits, not 102 rows. A transform block marks its area in
    // R_FIN with one read-modify-write per row (step_y clocks). Was 3,468 flip-flops of OR/mux logic (5k LUTs,
    // 2026-10-13); before that, per-bit writes with computed indices never finished synthesis.
    (* ram_style = "distributed" *) logic [33:0] bdf_m [0:127];
    logic [101:0] bdf_wr;
    logic [6:0]   bdf_a_rd, bdf_a_bl, bdf_a_fin;      // row addresses: read port A (above-right / FIN rmw), below-left, FIN write
    logic [5:0]   bdf_y_rd;
    logic [33:0]  bdf_row_a, bdf_row_bl;
    logic [4:0]   fy;                                  // FIN row counter
    logic [MIW-1:0] l_sb_r, l_sb_c;                    // the superblock's position, latched at sb_start (sb_r/sb_c are the event head's)
    assign sb_size4 = hdr.sb128 ? 6'd32 : 6'd16;
    // 5.11.3 clear_block_decoded_flags: the row a superblock starts with (above row decoded up to the frame
    // edge; left column available where the frame extends, the corner below the superblock's last row cleared)
    function automatic logic [33:0] bdf_init_row(input logic [1:0] p, input logic [5:0] yy1);   // yy1 = y+1
        logic sx, sy;
        logic [MIW-1:0] sbw4, sbh4;
        logic [5:0] lim_x, lim_y;
        logic [33:0] v;
        int yy;
        sx = (p != 0) && hdr.ssx; sy = (p != 0) && hdr.ssy;
        sbw4 = (hdr.mi_col_end - l_sb_c) >> sx;
        sbh4 = (hdr.mi_row_end - l_sb_r) >> sy;
        lim_x = sb_size4 >> sx; lim_y = sb_size4 >> sy;
        yy = int'(yy1) - 1;
        v = '0;
        if (yy <= int'(lim_y)) begin
            if (yy < 0) begin
                for (int xx = -1; xx <= 32; xx++) if (xx <= int'(lim_x) && (xx < 0 || xx < int'(sbw4))) v[xx + 1] = 1'b1;
            end else if (yy < int'(sbh4) && yy != int'(lim_y)) v[0] = 1'b1;
        end
        return v;
    endfunction
    logic [PXW-1:0] max_luma_w, max_luma_h;

    // ================================================================ transform-block state
    tx_rec_t     t;
    logic        sub_x, sub_y;
    logic [6:0]  tw_px, th_px;                             // transform width / height in pixels
    logic [2:0]  l2w, l2h;
    logic [5:0]  tw_c, th_c;                               // coefficient dims: min(32, w/h)
    logic [2:0]  tw_cl2;                                   // log2(tw_c): the coefficient row stride is a power of two
    // the quantizer-matrix level base as a table (qm_lvl 0..14 x 6688): written as a product it was a multiplier in
    // front of the ROM address; with the row stride as a shift the scan ROM -> address -> qm ROM path drops its DSP
    // (18 levels, -0.32 ns on the K26 at 100 MHz)
    function automatic logic [16:0] qm_lvl_base(input logic [3:0] lvl);
        case (lvl)
            4'd0: return 17'd0;
            4'd1: return 17'(1 * QM_LEVEL_STRIDE);
            4'd2: return 17'(2 * QM_LEVEL_STRIDE);
            4'd3: return 17'(3 * QM_LEVEL_STRIDE);
            4'd4: return 17'(4 * QM_LEVEL_STRIDE);
            4'd5: return 17'(5 * QM_LEVEL_STRIDE);
            4'd6: return 17'(6 * QM_LEVEL_STRIDE);
            4'd7: return 17'(7 * QM_LEVEL_STRIDE);
            4'd8: return 17'(8 * QM_LEVEL_STRIDE);
            4'd9: return 17'(9 * QM_LEVEL_STRIDE);
            4'd10: return 17'(10 * QM_LEVEL_STRIDE);
            4'd11: return 17'(11 * QM_LEVEL_STRIDE);
            4'd12: return 17'(12 * QM_LEVEL_STRIDE);
            4'd13: return 17'(13 * QM_LEVEL_STRIDE);
            4'd14: return 17'(14 * QM_LEVEL_STRIDE);
            default: return 17'(15 * QM_LEVEL_STRIDE);
        endcase
    endfunction
    logic [4:0]  step_x, step_y;                           // in 4x4 units
    logic [MIW-1:0] mi_row, mi_col;                           // luma MI position of the tx block
    logic [5:0]  sb_row_p, sb_col_p;                       // (row & sbMask) >> sub, plane units
    logic [33:0] fin_mask;                                 // the transform block's columns as bdf bits (x+1): one shifter
    assign fin_mask = ((34'd1 << step_x) - 34'd1) << (sb_col_p + 6'd1);
    logic [PXW-1:0] max_x, max_y;                             // last valid pixel index in the plane
    logic [PXW-1:0] base_x, base_y;                           // block origin in plane pixels
    logic        is_pal, is_cfl;
    logic [3:0]  mode;
    logic        have_l, have_a, have_ar, have_bl;
    logic        have_l_r, have_a_r;                       // the flags a cycle late, for the edge read addresses (the block
                                                           // record is loaded at R_SETUP, R_EDGE comes cycles later): the
                                                           // availability compares into the frame memory's address was 19 levels
    always_ff @(posedge clk) begin have_l_r <= have_l; have_a_r <= have_a; end
    logic [PXW-1:0] above_lim, left_lim;
    // The limits are constant over a transform block (geometry, the flag rows, the picture edge) and are only used
    // by the edge gather: registered in R_SETUP, so the per-cycle read coordinate is an add and a compare on
    // registers. Computed in front of the frame memory's address every cycle, the chain transform-size register ->
    // availability flag -> limit -> clamp -> window line -> UltraRAM address was the 80 MHz window build's worst
    // path (-1.03 ns, 2026-10-17).
    logic [PXW-1:0] above_lim_r, left_lim_r;
    always_comb begin
        bdf_y_rd  = (rs == R_FIN) ? 6'(sb_row_p + 6'd1 + 6'(fy)) : sb_row_p;
        bdf_a_rd  = 7'(t.plane) * 7'd34 + 7'(bdf_y_rd);
        bdf_a_bl  = 7'(t.plane) * 7'd34 + 7'(sb_row_p) + 7'(step_y) + 7'd1;
        bdf_a_fin = bdf_a_rd;
        bdf_row_a  = bdf_wr[bdf_a_rd] ? bdf_m[bdf_a_rd] : bdf_init_row(t.plane, bdf_y_rd);
        bdf_row_bl = bdf_wr[bdf_a_bl] ? bdf_m[bdf_a_bl] : bdf_init_row(t.plane, 6'(sb_row_p + 6'(step_y) + 6'd1));
    end
    always_ff @(posedge clk) if (rs == R_FIN) bdf_m[bdf_a_fin] <= bdf_row_a | fin_mask;
    // availability beyond the block (above-right, below-left) from the flags, and the sample limits
    // (its own block: geometry -> flag rows -> availability, no scheduling cycle)
    always_comb begin
        have_ar = bdf_row_a[sb_col_p + 6'(step_x) + 6'd1];     // read port A shows row sb_row_p outside R_FIN
        have_bl = bdf_row_bl[sb_col_p];
        above_lim = t.x + (have_ar ? PXW'(tw_px) * 2 : PXW'(tw_px)) - PXW'(1);
        if (above_lim > max_x) above_lim = max_x;
        left_lim = t.y + (have_bl ? PXW'(th_px) * 2 : PXW'(th_px)) - PXW'(1);
        if (left_lim > max_y) left_lim = max_y;
    end
    logic [6:0]  above_px, left_px;
    logic [95:0] pal_cols;
    always_comb begin
        sub_x = (t.plane != 2'd0) && hdr.ssx;
        sub_y = (t.plane != 2'd0) && hdr.ssy;
        tw_px = tx_width(t.txsz); th_px = tx_height(t.txsz);
        l2w = tx_w_log2(t.txsz); l2h = tx_h_log2(t.txsz);
        tw_c = (tw_px > 7'd32) ? 6'd32 : 6'(tw_px);
        tw_cl2 = (tw_c == 6'd4) ? 3'd2 : (tw_c == 6'd8) ? 3'd3 : (tw_c == 6'd16) ? 3'd4 : 3'd5;
        th_c = (th_px > 7'd32) ? 6'd32 : 6'(th_px);
        step_x = 5'(tw_px >> 2); step_y = 5'(th_px >> 2);
        mi_row = MIW'((t.y << sub_y) >> 2); mi_col = MIW'((t.x << sub_x) >> 2);
        sb_row_p = 6'((mi_row & MIW'(hdr.sb128 ? 31 : 15)) >> sub_y);
        sb_col_p = 6'((mi_col & MIW'(hdr.sb128 ? 31 : 15)) >> sub_x);
        max_x = PXW'(((PXW'(hdr.mi_cols) << 2) >> sub_x) - PXW'(1));
        max_y = PXW'(((PXW'(hdr.mi_rows) << 2) >> sub_y) - PXW'(1));
        base_x = PXW'((PXW'(bt.c) >> sub_x) << 2); base_y = PXW'((PXW'(bt.r) >> sub_y) << 2);
        is_pal = !ii_run && ((t.plane == 2'd0) ? (bt.pal_y != 4'd0) : (bt.pal_uv != 4'd0));
        is_cfl = !ii_run && (t.plane != 2'd0) && (bt.uvmode == UV_CFL_PRED);
        mode = ii_run ? ii_mode : (t.plane == 2'd0) ? bt.ymode[3:0] : (is_cfl ? DC_PRED : bt.uvmode);
        have_l = ((t.plane == 2'd0) ? tav_l : tav_lc) || (t.x > base_x);
        have_a = ((t.plane == 2'd0) ? tav_u : tav_uc) || (t.y > base_y);
        above_px = (PXW'(tw_px) < max_x - t.x + PXW'(1)) ? tw_px : 7'(max_x - t.x + PXW'(1));
        left_px  = (PXW'(th_px) < max_y - t.y + PXW'(1)) ? th_px : 7'(max_y - t.y + PXW'(1));
        pal_cols = (t.plane == 2'd0) ? bt.col_y : (t.plane == 2'd1) ? bt.col_u : bt.col_v;
    end

    // ---------------------------------------------------------------- dequant parameters (per tx block)
    logic [7:0]  qindex, dc_qi, ac_qi;
    logic [14:0] dc_q, ac_q;
    logic [3:0]  qm_lvl;
    logic        use_qm;
    logic [1:0]  bd_idx;
    logic [1:0]  dq_shift;
    logic signed [10:0] q_base;
    logic signed [6:0] d_dc, d_ac;
    always_comb begin
        q_base = 11'(signed'({3'b0, hdr.delta_q_present ? bt.qidx : hdr.base_q_idx}));
        if (hdr.seg_enabled && rh.seg_altq_en[bt.seg]) qindex = clip255(q_base + 11'(signed'(rh.seg_altq[9 * bt.seg +: 9])));
        else qindex = 8'(q_base);
        case (t.plane)
            2'd0: begin d_dc = rh.dq_ydc; d_ac = 7'sd0; end
            2'd1: begin d_dc = rh.dq_udc; d_ac = rh.dq_uac; end
            default: begin d_dc = rh.dq_vdc; d_ac = rh.dq_vac; end
        endcase
        dc_qi = clip255(11'(signed'({3'b0, qindex})) + 11'(d_dc));
        ac_qi = clip255(11'(signed'({3'b0, qindex})) + 11'(d_ac));
        bd_idx = 2'((hdr.bit_depth - 4'd8) >> 1);
        dc_q = dc_qlookup(bd_idx, dc_qi);
        ac_q = ac_qlookup(bd_idx, ac_qi);
        qm_lvl = rh.qm_level[(int'(t.plane) * 8 + int'(bt.seg)) * 4 +: 4];
        use_qm = rh.using_qmatrix && (t.txtype < IDTX) && (qm_lvl < 4'd15);
        case (t.txsz)
            5'd3, 5'd9, 5'd10, 5'd17, 5'd18: dq_shift = 2'd1;    // TX_32X32, 16X32, 32X16, 16X64, 64X16
            5'd4, 5'd11, 5'd12: dq_shift = 2'd2;                 // TX_64X64, 32X64, 64X32
            default: dq_shift = 2'd0;
        endcase
    end
    logic flip_ud, flip_lr;
    always_comb begin
        flip_ud = (t.txtype == 4'd4) || (t.txtype == 4'd6) || (t.txtype == 4'd8) || (t.txtype == 4'd14);   // FLIPADST_DCT, FLIPADST_FLIPADST, FLIPADST_ADST, V_FLIPADST
        flip_lr = (t.txtype == 4'd5) || (t.txtype == 4'd6) || (t.txtype == 4'd7) || (t.txtype == 4'd15);   // DCT_FLIPADST, FLIPADST_FLIPADST, ADST_FLIPADST, H_FLIPADST
    end

    // ================================================================ sub-blocks
    // itx2d
    logic itx_we, itx_clr, itx_start, itx_busy, itx_done; logic [9:0] itx_addr; logic [TW-1:0] itx_data; logic [11:0] res_addr; logic [TW-1:0] res_data; logic [4*TW-1:0] res_data4;
    itx2d #(.TW(TW), .NLANES(ITX_LANES)) u_itx (.clk, .rst, .coef_clr(itx_clr), .coef_we(itx_we), .coef_addr(itx_addr), .coef_data(itx_data),
                            .start(itx_start), .tx_sz(t.txsz), .tx_type(t.lossless ? 4'd0 : t.txtype), .bit_depth(hdr.bit_depth), .lossless(t.lossless),
                            .busy(itx_busy), .done(itx_done), .res_addr, .res_data, .res_data4);
    // ipred
    logic edge_we, edge_we4, ip_start, ip_busy, ip_done, ip_ov; logic [1:0] edge_side; logic [7:0] edge_idx; logic [11:0] edge_data; logic [47:0] edge_data4; logic [47:0] ip_pix4; logic [5:0] ip_ox, ip_oy;
    logic ft_sel;
    assign ft_sel = (is_dir(mode) && !((t.plane == 2'd0) && bt.use_fi)) ? ((t.plane == 2'd0) ? ft_y : ft_uv) : 1'b0;
    ipred #(.PW(12)) u_ip (.clk, .rst, .edge_we, .edge_side, .edge_idx, .edge_data, .edge_we4, .edge_data4,
                           .start(ip_start), .mode, .use_filter_intra(!ii_run && (t.plane == 2'd0) && bt.use_fi), .filter_intra_mode(bt.fi_mode),
                           .angle_delta(ii_run ? 3'sd0 : (t.plane == 2'd0) ? bt.angle_y : bt.angle_uv), .log2w(l2w), .log2h(l2h), .bit_depth(hdr.bit_depth),
                           .have_left(have_l), .have_above(have_a), .filter_type(ft_sel), .edge_filter_en(rh.enable_intra_edge_filter),
                           .above_px, .left_px, .busy(ip_busy), .done(ip_done),
                           .out_valid(ip_ov), .out_x(ip_ox), .out_y(ip_oy), .out_pix4(ip_pix4));
    // cfl
    logic cl_lwe, cl_dwe, cl_start, cl_busy, cl_done, cl_ov; logic [9:0] cl_laddr, cl_daddr; logic [11:0] cl_ldata, cl_ddata, cl_pix; logic [4:0] cl_ox, cl_oy;
    logic [PXW-1:0] lx0, ly0;
    assign lx0 = PXW'(t.x << sub_x); assign ly0 = PXW'(t.y << sub_y);
    logic [6:0] l_av_w, l_av_h;
    assign l_av_w = 7'(max_luma_w - lx0); assign l_av_h = 7'(max_luma_h - ly0);
    cfl #(.PW(12)) u_cfl (.clk, .rst, .luma_we(cl_lwe), .luma_addr(cl_laddr), .luma_data(cl_ldata), .dc_we(cl_dwe), .dc_addr(cl_daddr), .dc_data(cl_ddata),
                          .start(cl_start), .log2w(l2w), .log2h(l2h), .sub_x, .sub_y, .alpha((t.plane == 2'd1) ? bt.cfl_u : bt.cfl_v),
                          .bit_depth(hdr.bit_depth), .luma_avail_w(l_av_w), .luma_avail_h(l_av_h), .busy(cl_busy), .done(cl_done),
                          .out_valid(cl_ov), .out_x(cl_ox), .out_y(cl_oy), .out_pix(cl_pix));
    // quantizer matrix ROM
    logic [16:0] qm_addr; logic [7:0] qm_data;
    qm_rom u_qm (.clk, .addr(qm_addr), .data(qm_data));

    // ================================================================ per-transform-block FSM
    logic tx_ack;                                          // registered: the transform block was fully written (R_MIW)
    // cycle counters per transform-FSM state and per block-FSM state (simulation profiling; read through the
    // hierarchy by the testbench, never reset except by rst)
    logic [31:0] perf_rs [0:31];
    logic [31:0] perf_bst [0:31];
    always_ff @(posedge clk) begin
        if (rst) begin
            for (int i = 0; i < 32; i++) perf_rs[i] <= 32'd0;
            for (int i = 0; i < 32; i++) perf_bst[i] <= 32'd0;
        end else begin
            perf_rs[rs] <= perf_rs[rs] + 32'd1;
            perf_bst[bst] <= perf_bst[bst] + 32'd1;
        end
    end
    logic tx_take, tx_pop;
    assign sb_start = ev_valid && (ev_kind == 2'd2) && (rs == R_IDLE) && (bst == B_IDLE);
    assign sb_r = ev_sb_r; assign sb_c = ev_sb_c;
    assign blk_take = ev_valid && (ev_kind == 2'd1) && (bst == B_IDLE) && blk_ready_q[!cur_par];   // one block ahead at most
    assign tx_take = ev_valid && (ev_kind == 2'd0) && (rs == R_IDLE) && blk_ready && !tx_ack && !mc_v_active && out_drained;
    assign tx_pop = tx_take;                                 // popped at take since 2026-11-08 (was at R_MIW: it kept the next block behind the adds)
    assign tx_rel = (rs == R_MIW) && !mi_tx_busy && !mi_tx_we;   // the slot release stays at the end (rec_fifo's in-flight count)
    assign ev_pop = sb_start || blk_take || tx_pop;
    assign q_slot = t.slot;
    logic [6:0]  ci, cj;                                   // generic pixel / coefficient counters (row, col)
    logic [8:0]  ek, n_edges;                              // edge entry counter: 0..2(w+h)
    logic        ep_valid, ep_const;                       // edge pipeline register
    // above-row groups: entries 0 .. w+h-1 are gathered 4 per read (aligned at t.x); entries past AboveRow's last
    // available sample (above_lim) replicate it, which may lie in an earlier group (last_above)
    logic        ep_grp, ep_rep;                           // landing is a group; group replicates the left neighbour (no above)
    logic [PXW-1:0] ep_xb;                                    // x of the group's first sample
    logic [11:0] last_above;
    logic [8:0]  n_above;
    assign n_above = n_edges >> 1;                         // w + h: n_edges is registered in R_SETUP
    logic [1:0]  ep_side; logic [7:0] ep_idx; logic [11:0] ep_val;
    logic        ep2_valid, ep2_const, ep2_grp, ep2_rep;   // the edge pipeline's second stage: the read lands two cycles after
    logic [PXW-1:0] ep2_xb; logic [1:0] ep2_side; logic [7:0] ep2_idx; logic [11:0] ep2_val;   // its issue (2026-10-31)
    logic        px_valid;                                 // generic 1-deep read pipeline
    logic [6:0]  px_i, px_j;
    logic        px2_valid, px_src, px2_src;               // second stage of the CfL loads (two-cycle read); px_src: 1 = the DC (chroma) read
    logic [6:0]  px2_i, px2_j;
    logic        p_valid;                                  // dequant / add pipelines: previous position issued
    logic [6:0]  pci, pcj;
    logic        p2_valid; logic [6:0] p2ci, p2cj;         // the add pipeline's extra stage (two-cycle read)
    // dequant walks the coded coefficients in scan order (k = 0 .. eob-1) instead of every position of the
    // block: scan ROM (registered) -> position -> Quant read (registered) -> dequant -> itx coefficient write
    logic [10:0] sk;                                       // next scan index to issue
    logic        sd_valid;                                 // scan index issued last cycle (its position lands now)
    logic [10:0] sd_k;
    logic [2:0]  s_bwl, s_hlog;                            // adjusted transform size (spec Adjusted_Tx_Size)
    logic [1:0]  s_cls;                                    // 0 2D (default scan), 1 Mrow (V_*), 2 Mcol (H_*)
    logic [9:0]  s_pos;                                    // position of sd_k in the adjusted grid
    logic [6:0]  sc_ci, sc_cj;                             // its coefficient row / column
    logic [11:0] scan_addr; logic [9:0] scan_data;
    scan_rom u_scan (.clk(clk), .addr(scan_addr), .data(scan_data));
    always_comb begin
        s_bwl  = tx_w_log2(tx_adj(t.txsz));
        s_hlog = tx_h_log2(tx_adj(t.txsz));
        s_cls  = (t.txtype == 4'd10 || t.txtype == 4'd12 || t.txtype == 4'd14) ? 2'd1 :
                 (t.txtype == 4'd11 || t.txtype == 4'd13 || t.txtype == 4'd15) ? 2'd2 : 2'd0;
        scan_addr = scan_base(t.txsz) + 12'(sk);
        case (t.lossless ? 2'd0 : s_cls)
            2'd1:    s_pos = sd_k[9:0];                                                                      // Mrow: row-major
            2'd2:    s_pos = ((sd_k[9:0] & ((10'd1 << s_hlog) - 10'd1)) << s_bwl) | (sd_k[9:0] >> s_hlog);   // Mcol
            default: s_pos = scan_data;
        endcase
        sc_ci = 7'(s_pos >> s_bwl);
        sc_cj = 7'(s_pos & ((10'd1 << s_bwl) - 10'd1));
    end
    logic        pal_first;
    logic [PXW-1:0] cur_x, cur_y;
    logic [11:0] mid_m1, mid_p1, mid;
    assign mid = 12'(13'd1 << (hdr.bit_depth - 4'd1));
    assign mid_m1 = mid - 12'd1;
    assign mid_p1 = mid + 12'd1;
    assign pix_max = 12'((13'd1 << hdr.bit_depth) - 13'd1);

    // edge entry k -> (side, idx, is_const, const value, read coordinates)
    logic        e_const;
    logic [1:0]  e_side;
    logic [7:0]  e_idx;
    logic [11:0] e_val;
    logic [PXW-1:0] e_rx, e_ry;
    always_comb begin
        e_const = 1'b0; e_side = 2'd0; e_idx = 8'd0; e_val = 12'd0; e_rx = t.x; e_ry = t.y;
        if (ek < n_above) begin
            e_side = 2'd0; e_idx = 8'(ek);
            if (have_a) begin
                e_rx = (t.x + PXW'(ek) > above_lim_r) ? above_lim_r : t.x + PXW'(ek); e_ry = t.y - PXW'(1);
            end else if (have_l) begin
                e_rx = t.x - PXW'(1); e_ry = t.y;
            end else begin e_const = 1'b1; e_val = mid_m1; end
        end else if (ek < n_edges) begin
            e_side = 2'd1; e_idx = 8'(ek - n_above);
            if (have_l) begin
                e_rx = t.x - PXW'(1); e_ry = (t.y + PXW'(e_idx) > left_lim_r) ? left_lim_r : t.y + PXW'(e_idx);
            end else if (have_a) begin
                e_rx = t.x; e_ry = t.y - PXW'(1);
            end else begin e_const = 1'b1; e_val = mid_p1; end
        end else begin
            e_side = 2'd2; e_idx = 8'd0;
            if (have_a && have_l) begin e_rx = t.x - PXW'(1); e_ry = t.y - PXW'(1); end
            else if (have_a) begin e_rx = t.x; e_ry = t.y - PXW'(1); end
            else if (have_l) begin e_rx = t.x - PXW'(1); e_ry = t.y; end
            else begin e_const = 1'b1; e_val = mid; end
        end
    end

    // dequant datapath, two stages behind the Quant/qm reads: q_data / qm_data are valid for the position issued
    // the cycle before; stage 1 forms the effective quantiser (qm multiply) and registers it with the coefficient
    // and position, stage 2 multiplies, shifts, clamps and writes the itx bank. (In one cycle the two chained
    // multiplies into the bank RAM were the decoder's worst path, -3.8 ns at 100 MHz.)
    logic [17:0] q_eff, q_eff_r;
    logic signed [20:0] q_data_r;
    logic        dq_v2;                                     // stage 2 holds a coefficient to write
    logic [6:0]  dq_ci2, dq_cj2;
    logic signed [39:0] dq_full;
    logic [23:0] dq_abs;
    logic [23:0] dq_sh;
    logic signed [TW-1:0] dq_out;
    logic signed [20:0] lim_pos;
    always_comb begin
        begin
            logic [14:0] qv;
            logic [22:0] prod;
            qv = (pci == 7'd0 && pcj == 7'd0) ? dc_q : ac_q;      // dequant of the position issued last cycle
            prod = 23'(qv) * 23'(qm_data);
            q_eff = use_qm ? 18'((prod + 23'd16) >> 5) : 18'(qv);
        end
        dq_full = 40'(q_data_r) * 40'(signed'({1'b0, q_eff_r}));
        dq_abs = (dq_full < 0) ? 24'(-dq_full) : 24'(dq_full);           // & 0xFFFFFF
        dq_sh = dq_abs >> dq_shift;
        lim_pos = 21'sd1 <<< (5'(hdr.bit_depth) + 5'd7);          // 1 << (7 + BitDepth), up to 2^19
        begin
            logic signed [24:0] v;
            v = (dq_full < 0) ? -$signed({1'b0, dq_sh}) : $signed({1'b0, dq_sh});
            if (v < -25'(lim_pos)) dq_out = TW'(-25'(lim_pos));
            else if (v > 25'(lim_pos) - 25'sd1) dq_out = TW'(25'(lim_pos) - 25'sd1);
            else dq_out = TW'(v);
        end
    end
    always_ff @(posedge clk) begin                            // dequant stage 1 -> 2
        dq_v2 <= p_valid && (rs == R_DQ || rs == R_DQ_LAST) && !rst;
        dq_ci2 <= pci; dq_cj2 <= pcj; q_eff_r <= q_eff; q_data_r <= q_data;
    end
    // recon add datapath: residual columns cj .. cj+3 of row ci map to the aligned picture group starting at
    // add_xx (reversed when flip_lr); (ci, cj) is the group being read, (pci, pcj) the one being added and written
    logic [6:0]  add_xx, add_yy, padd_xx, padd_yy;
    assign padd_xx = flip_lr ? 7'(tw_px - 7'd4 - pcj) : pcj;
    assign padd_yy = flip_ud ? 7'(th_px - 7'd1 - pci) : pci;
    // The written group's picture position, registered with (pci, pcj): the flip arithmetic and the block offset
    // then sit a cycle ahead of the frame memory's write address (31 logic levels from the transform-size register
    // to the UltraRAM address pin was the core build's worst clock-crossing path at 100 MHz).
    logic [FBX-1:0] padd_x_r;
    logic [FBY-1:0] padd_y_r;
    logic [FBX-1:0] p2add_x_r; logic [FBY-1:0] p2add_y_r;
    // The sum is registered too and written the cycle after: the residual read out of the transform engine's
    // banks, the add, the clamp and the frame memory's write-port mux and capture were one path (0.00 ns at 80 MHz,
    // 2026-10-18). Groups of a block are each written once and read (for the prediction) before their own add, so
    // the later landing changes nothing; R_ADD_LAST2 .. R_ADD_LAST4 drain the last write before R_FIN.
    // Stages: R_ADD issues the reads of (ci, cj) -> p: (pci, pcj) issued, res_addr out, prediction fb_rdata4 in ->
    // q: prediction held in fb4_q, residual res_data4 in, sum -> a: add_r written.
    logic           q_valid;
    logic [47:0]    fb4_q;
    logic [FBX-1:0] qadd_x_r;
    logic [FBY-1:0] qadd_y_r;
    logic           a_valid;
    logic [47:0]    add_r;
    logic [FBX-1:0] aadd_x_r;
    logic [FBY-1:0] aadd_y_r;
    assign add_xx = flip_lr ? 7'(tw_px - 7'd4 - cj) : cj;
    assign add_yy = flip_ud ? 7'(th_px - 7'd1 - ci) : ci;
    logic [47:0] add_out4;
    always_comb begin
        for (int m = 0; m < 4; m++) begin
            logic signed [TW:0] sum;
            logic [TW-1:0] r;
            r = res_data4[(flip_lr ? 3 - m : m) * TW +: TW];
            sum = $signed({1'b0, (TW - 12)'(0), fb4_q[m*12 +: 12]}) + $signed({r[TW-1], r});
            add_out4[m*12 +: 12] = (sum < 0) ? 12'd0 : (sum > $signed({1'b0, (TW - 12)'(0), pix_max})) ? pix_max : 12'(sum);
        end
    end
    always_ff @(posedge clk) begin                            // residual stage: the prediction group read last cycle waits
        p2_valid <= p_valid && (rs == R_ADD || rs == R_ADD_LAST) && !rst;  // the prediction read lands two cycles after the
        p2add_x_r <= padd_x_r; p2add_y_r <= padd_y_r; p2ci <= pci; p2cj <= pcj;   // issue (2026-10-31): one more stage, res_addr from p2
        q_valid <= p2_valid && (rs == R_ADD || rs == R_ADD_LAST || rs == R_ADD_LAST2) && !rst;   // for the residual (itx2d answers a cycle
        fb4_q <= fb_rdata4; qadd_x_r <= p2add_x_r; qadd_y_r <= p2add_y_r;   // after res_addr since 2026-10-26)
    end
    always_ff @(posedge clk) begin                            // add stage: the sum, written the cycle after
        a_valid <= q_valid && !rst;
        add_r <= add_out4; aadd_x_r <= qadd_x_r; aadd_y_r <= qadd_y_r;
    end
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
