Jonahss/openav1/rtl/lf_top.sv

// Deblocking loop filter (spec 7.14), frame-level, in the spec's order: for each plane, pass 0 (vertical
// edges) over the whole frame, then pass 1 (horizontal edges); per 4x4 edge position the edge parameters
// (7.14.2), filter size (7.14.3) and strength (7.14.4/5) come from mi_store, then the four samples along the
// edge are filtered one at a time (7.14.6: masks, narrow filter, 6/8/14-tap wide filters) read-modify-write
// through the single-port frame buffer. Filter levels follow 7.14.4 for intra and inter blocks (reference and mode deltas).
// Slow-and-correct: ~25 cycles per sample position. A real design filters 4-8 samples per clock out of
// line buffers and interleaves the passes per superblock.
module lf_top
  import blk_tables_pkg::*;
  import tx_tables_pkg::*;
  import syn_pkg::*;
#(
    parameter int FBX = 10,
    parameter int FBY = 9
) (
    input  logic        clk,
    input  logic        rst,
    input  hdr_t        hdr,
    input  lf_hdr_t     lh,
    input  logic        start,
    input  logic [MIW-1:0] row_first, row_last,  // mi rows to filter (inclusive): a superblock-row band, or the whole frame
    output logic        busy,
    output logic        done,
    // mi_store reads (registered, 1 cycle)
    output logic [MIW-1:0] rd_row, rd_col,
    input  mi_lf_t      rd_info,
    output logic [1:0]  txr_plane,
    output logic [MIW-1:0] txr_row, txr_col,
    input  logic [4:0]  txr_sz,
    // frame buffer
    output logic        fb_re,
    output logic        fb_we,
    output logic [1:0]  fb_plane,
    output logic [FBX-1:0] fb_x,
    output logic [FBY-1:0] fb_y,
    output logic [11:0] fb_wdata,
    input  logic [11:0] fb_rdata,
    input  logic [47:0] fb_rdata4,       // aligned group of 4 samples containing fb_x (vertical edges read groups)
    output logic        fb4_we,          // 4-wide write (vertical edges write back whole groups), aligned at fb4_x
    output logic [FBX-1:0] fb4_x,
    output logic [FBY-1:0] fb4_y,
    output logic [47:0] fb4_wdata
);
    localparam int MAX_LOOP_FILTER = 63;

    typedef enum logic [3:0] {L_IDLE, L_EDGE, L_RD1, L_RD2, L_CALC, L_S_RD, L_S_CALC, L_S_WR, L_NEXT, L_DONE} st_t;
    st_t st;

    // ---------------------------------------------------------------- loop state
    logic [1:0]  plane;
    logic        pss;                                   // 0: vertical edges (dx=1), 1: horizontal edges (dy=1)
    logic [MIW-1:0] row, col;
    logic        sub_x, sub_y;
    logic [MIW-1:0] rowa, cola, prow, pcol;                // adjusted (row | subY, col | subX) and previous positions
    logic [PXW-1:0] x, y, xp, yp;
    mi_lf_t      cur, prv;
    logic [4:0]  cur_tx, prv_tx;
    logic [1:0]  i4;                                    // sample index along the edge (0..3)
    logic [4:0]  filter_size;                           // 4, 8 or 16
    logic [5:0]  lvl;
    logic [7:0]  limit, blimit, thresh;
    logic [11:0] pix [0:13];                            // pix[7 + k] = pixel k (k = -7..6): p_j = pix[6-j], q_j = pix[7+j]
    logic [3:0]  kk, n_rd;                              // read counter / count
    logic        rd_pend;
    logic [3:0]  rd_slot;
    logic        rd_pend2, pss2;                        // the read lands two cycles after its request (2026-10-31)
    logic [3:0]  rd_slot2;
    // vertical edges (pss = 0): the n_rd samples k = -n_rd/2 .. n_rd/2-1 lie in n_rg aligned groups of 4 starting
    // at k = rbase (sx is a multiple of 4); every lane of those groups is kept so the groups can be written back whole
    logic [1:0]  rd_g, n_rg;
    logic signed [4:0] rbase;
    logic [11:0] pix_m8, pix_p7;                        // k = -8 and k = 7 (read with a 16-sample span, never modified)
    assign n_rg  = (n_rd == 4'd14) ? 2'd3 : 2'd1;      // groups - 1: 4 groups for a 16-wide filter, else 2
    assign rbase = (n_rd == 4'd14) ? -5'sd8 : -5'sd4;
    logic signed [4:0] wk;                              // write position k
    logic signed [4:0] w_lo, w_hi;
    // horizontal edges: the 4 columns of the position at once. pixc[c][7 + k] = column c's sample k rows from the
    // edge; cc = column being decided; colout[c][k + 6] = {modified, value} for k = -6..5 of column c
    logic [11:0] pixc [0:3][0:13];
    logic [1:0]  cc;
    logic [12:0] colout [0:3][0:11];
    logic        any_mod;
    logic signed [4:0] f_lo_all, f_hi_all;                // union of the columns' modified ranges
    logic [11:0] pix_a [0:13];                            // samples the filter datapath works on (registered)
    logic [11:0] pix_n [0:13];                            // the column decided this cycle, filtered the next
    logic [1:0]  cc_n;
    logic [PXW-1:0] sx, sy;                                // sample position

    always_comb begin
        sub_x = (plane != 2'd0) && hdr.ssx;
        sub_y = (plane != 2'd0) && hdr.ssy;
        x = PXW'(col) << 2; y = PXW'(row) << 2;
        rowa = row | MIW'(sub_y); cola = col | MIW'(sub_x);
        xp = x >> sub_x; yp = y >> sub_y;
        prow = pss ? rowa - (MIW'(1) << sub_y) : rowa;
        pcol = pss ? cola : cola - (MIW'(1) << sub_x);
        sx = pss ? xp + PXW'(i4) : xp;
        sy = pss ? yp : yp + PXW'(i4);
    end

    // ---------------------------------------------------------------- 7.14.4 / 7.14.5 strength
    function automatic logic [5:0] clip63(input logic signed [9:0] v);
        clip63 = (v < 0) ? 6'd0 : (v > 10'sd63) ? 6'd63 : 6'(v);
    endfunction
    function automatic logic [29:0] strength(input mi_lf_t info, input logic [1:0] pl, input logic ps);
        // returns {lvl[5:0], limit[7:0], blimit[7:0], thresh[7:0]}
        logic [1:0] i;
        logic signed [6:0] dlf;
        logic [5:0] base, lvl_seg, lv;
        logic [4:0] seg_i;
        logic [1:0] sh;
        logic [5:0] lim;
        i = (pl == 2'd0) ? 2'(ps) : 2'(pl + 2'd1);
        dlf = lh.delta_lf_multi ? 7'(info.delta_lf[7 * i +: 7]) : 7'(info.delta_lf[6:0]);
        base = clip63(10'(dlf) + 10'(signed'({4'b0, lh.level[6 * i +: 6]})));
        lvl_seg = base;
        seg_i = {i, info.seg};
        if (hdr.seg_enabled && lh.seg_lf_en[seg_i])
            lvl_seg = clip63(10'(signed'(lh.seg_lf_data[7 * seg_i +: 7])) + 10'(signed'({4'b0, lvl_seg})));
        if (lh.delta_enabled) begin
            // 7.14.4: the reference frame's delta, plus the mode delta for inter blocks, both scaled by lvlSeg >> 5
            logic signed [9:0] dl;
            dl = 10'(signed'(lh.ref_deltas[7 * info.ref0 +: 7]));
            if (info.ref0 != 3'd0) dl = dl + 10'(signed'(lh.mode_deltas[7 * info.mode_type +: 7]));
            lvl_seg = clip63(10'(signed'({4'b0, lvl_seg})) + (dl <<< (lvl_seg >> 5)));
        end
        lv = lvl_seg;
        sh = (lh.sharpness > 3'd4) ? 2'd2 : (lh.sharpness > 3'd0) ? 2'd1 : 2'd0;
        if (lh.sharpness > 3'd0) begin
            lim = lv >> sh;
            if (lim < 6'd1) lim = 6'd1;
            if (lim > 6'(4'd9 - 4'(lh.sharpness))) lim = 6'(4'd9 - 4'(lh.sharpness));
        end else begin
            lim = lv >> sh;
            if (lim < 6'd1) lim = 6'd1;
        end
        begin
            logic [8:0] bl;
            bl = (({3'b0, lv} + 9'd2) << 1) + {3'b0, lim};          // blimit = 2 * (lvl + 2) + limit
            strength = {lv, 8'(lim), 8'(bl), 8'(lv >> 4)};
        end
    endfunction
    logic [29:0] str_cur, str_prv;
    always_comb begin
        str_cur = strength(cur, plane, pss);
        str_prv = strength(prv, plane, pss);
    end

    // ---------------------------------------------------------------- 7.14.2 / 7.14.3 edge decision (combinational from cur/prv)
    logic [4:0]  plane_size;
    logic        is_blk_edge, is_tx_edge, apply_filter;
    logic [6:0]  base_size;
    logic [4:0]  fsize_c;
    always_comb begin
        plane_size = subsampled_size(cur.bsize, sub_x, sub_y);
        if (!pss) begin
            is_blk_edge = (xp & (PXW'(blk_w(plane_size)) - PXW'(1))) == PXW'(0);
            is_tx_edge  = (xp & (PXW'(tx_width(cur_tx)) - PXW'(1))) == PXW'(0);
            base_size = (tx_width(prv_tx) < tx_width(cur_tx)) ? tx_width(prv_tx) : tx_width(cur_tx);
        end else begin
            is_blk_edge = (yp & (PXW'(blk_h(plane_size)) - PXW'(1))) == PXW'(0);
            is_tx_edge  = (yp & (PXW'(tx_height(cur_tx)) - PXW'(1))) == PXW'(0);
            base_size = (tx_height(prv_tx) < tx_height(cur_tx)) ? tx_height(prv_tx) : tx_height(cur_tx);
        end
        apply_filter = is_tx_edge && (is_blk_edge || !cur.skip || cur.ref0 == 3'd0);   // 7.14.2: tx edges inside a skipped INTER block are not filtered
        fsize_c = (plane == 2'd0) ? ((base_size > 7'd16) ? 5'd16 : 5'(base_size)) : ((base_size > 7'd8) ? 5'd8 : 5'(base_size));
    end

    // ---------------------------------------------------------------- 7.14.6 sample filter datapath (from pix[])
    logic [3:0]  bd8;
    assign bd8 = hdr.bit_depth - 4'd8;
    logic [12:0] p [0:6];
    logic [12:0] q [0:6];
    // Two stages per column, skewed: the decision (hev, masks, filter mode) is taken on the next column's samples
    // (pix_n: column 0 as L_S_CALC is entered, cc+1 while it runs; the single column of a vertical edge throughout)
    // and registered with the samples (pix_a, fmode_r, hev_r); the filters work from the registers. Column mux,
    // decision and the narrow filter's clamp chain in one cycle into colout were the block's worst path (-2.6 ns).
    assign cc_n = (st == L_S_CALC) ? cc + 2'd1 : 2'd0;
    always_comb for (int m = 0; m < 14; m++) pix_n[m] = pss ? pixc[cc_n][m] : pix[m];
    always_ff @(posedge clk) pix_a <= pix_n;
    logic [12:0] pn [0:6];
    logic [12:0] qn [0:6];
    always_comb for (int j = 0; j < 7; j++) begin pn[j] = 13'(pix_n[6 - j]); qn[j] = 13'(pix_n[7 + j]); end
    always_comb for (int j = 0; j < 7; j++) begin p[j] = 13'(pix_a[6 - j]); q[j] = 13'(pix_a[7 + j]); end
    function automatic logic [12:0] adiff(input logic [12:0] a, input logic [12:0] b);
        adiff = (a > b) ? a - b : b - a;
    endfunction
    logic [4:0]  filter_len;
    logic        hev, filter_mask, flat, flat2;
    logic        hev_r;                          // hev of the column being filtered (registered)
    logic [15:0] thresh_bd, limit_bd, blimit_bd, one_bd;
    always_comb begin
        filter_len = (filter_size == 5'd4) ? 5'd4 : (plane != 2'd0) ? 5'd6 : (filter_size == 5'd8) ? 5'd8 : 5'd16;
        thresh_bd = 16'(thresh) << bd8; limit_bd = 16'(limit) << bd8; blimit_bd = 16'(blimit) << bd8; one_bd = 16'd1 << bd8;
        hev = (16'(adiff(pn[1], pn[0])) > thresh_bd) || (16'(adiff(qn[1], qn[0])) > thresh_bd);
        begin
            logic m;
            m = (16'(adiff(pn[1], pn[0])) > limit_bd) || (16'(adiff(qn[1], qn[0])) > limit_bd) ||
                ((16'(adiff(pn[0], qn[0])) * 2 + (16'(adiff(pn[1], qn[1])) >> 1)) > blimit_bd);
            if (filter_len >= 5'd6) m = m || (16'(adiff(pn[2], pn[1])) > limit_bd) || (16'(adiff(qn[2], qn[1])) > limit_bd);
            if (filter_len >= 5'd8) m = m || (16'(adiff(pn[3], pn[2])) > limit_bd) || (16'(adiff(qn[3], qn[2])) > limit_bd);
            filter_mask = !m;
        end
        begin
            logic m;
            m = (16'(adiff(pn[1], pn[0])) > one_bd) || (16'(adiff(qn[1], qn[0])) > one_bd) ||
                (16'(adiff(pn[2], pn[0])) > one_bd) || (16'(adiff(qn[2], qn[0])) > one_bd);
            if (filter_len >= 5'd8) m = m || (16'(adiff(pn[3], pn[0])) > one_bd) || (16'(adiff(qn[3], qn[0])) > one_bd);
            flat = (filter_size >= 5'd8) && !m;
        end
        begin
            logic m;
            m = (16'(adiff(pn[6], pn[0])) > one_bd) || (16'(adiff(qn[6], qn[0])) > one_bd) ||
                (16'(adiff(pn[5], pn[0])) > one_bd) || (16'(adiff(qn[5], qn[0])) > one_bd) ||
                (16'(adiff(pn[4], pn[0])) > one_bd) || (16'(adiff(qn[4], qn[0])) > one_bd);
            flat2 = (filter_size >= 5'd16) && !m;
        end
    end
    // narrow filter (7.14.6.3)
    logic signed [13:0] ps1, ps0, qs0, qs1, filt, filter1, filter2, filt_r;
    logic [11:0] nq0, np0, nq1, np1;
    logic signed [13:0] off_s, lo_s, hi_s;
    function automatic logic signed [13:0] c4(input logic signed [15:0] v, input logic signed [13:0] lo, input logic signed [13:0] hi);
        c4 = (v < 16'(lo)) ? lo : (v > 16'(hi)) ? hi : 14'(v);
    endfunction
    // The narrow filter's first half (the hev-gated difference and the 3*(q0-p0) clamp chain) is formed in the
    // decision stage from the next column's samples and registered: the remaining chain (filter1/2, the four
    // outputs) fits the filter cycle. (All seven steps in one cycle were the block's last path over 10 ns.)
    logic signed [13:0] pn_s1, pn_s0, qn_s0, qn_s1, filt_a_n, filt_a_r;
    always_comb begin
        pn_s1 = 14'(pn[1]) - off_s; pn_s0 = 14'(pn[0]) - off_s; qn_s0 = 14'(qn[0]) - off_s; qn_s1 = 14'(qn[1]) - off_s;
        filt_a_n = hev ? c4(16'(pn_s1) - 16'(qn_s1), lo_s, hi_s) : 14'sd0;
        filt_a_n = c4(16'(filt_a_n) + 16'sd3 * (16'(qn_s0) - 16'(pn_s0)), lo_s, hi_s);
    end
    always_comb begin
        off_s = 14'(13'd128 << bd8);
        lo_s = -(14'sd1 <<< (hdr.bit_depth - 4'd1));
        hi_s = (14'sd1 <<< (hdr.bit_depth - 4'd1)) - 14'sd1;
        ps1 = 14'(p[1]) - off_s; ps0 = 14'(p[0]) - off_s; qs0 = 14'(q[0]) - off_s; qs1 = 14'(q[1]) - off_s;
        filt = filt_a_r;                                                     // formed in the decision stage (below)
        filter1 = c4(16'(filt) + 16'sd4, lo_s, hi_s) >>> 3;
        filter2 = c4(16'(filt) + 16'sd3, lo_s, hi_s) >>> 3;
        nq0 = 12'(c4(16'(qs0) - 16'(filter1), lo_s, hi_s) + off_s);
        np0 = 12'(c4(16'(ps0) + 16'(filter2), lo_s, hi_s) + off_s);
        filt_r = (filter1 + 14'sd1) >>> 1;                                   // Round2(filter1, 1)
        nq1 = 12'(c4(16'(qs1) - 16'(filt_r), lo_s, hi_s) + off_s);
        np1 = 12'(c4(16'(ps1) + 16'(filt_r), lo_s, hi_s) + off_s);
    end
    // wide filters (7.14.6.4): F[i] = Round2(sum_j pix[clip3(-(n+1), n, i+j)] * tap(j), log2Size), i in -n..n-1
    function automatic logic [11:0] wide_val(input int i, input int n, input int n2, input int log2sz);
        logic [17:0] t;
        int pidx;
        t = 18'd0;
        for (int j = -6; j <= 6; j++) begin
            if (j >= -n && j <= n) begin
                pidx = i + j;
                if (pidx < -(n + 1)) pidx = -(n + 1);
                if (pidx > n) pidx = n;
                t = t + (((j < 0 ? -j : j) <= n2) ? 18'(pix_a[7 + pidx]) * 18'd2 : 18'(pix_a[7 + pidx]));
            end
        end
        wide_val = 12'((t + (18'd1 << (log2sz - 1))) >> log2sz);
    endfunction
    logic [11:0] w16 [0:11];                            // luma 16: n=6, n2=1, log2 4: i = -6..5
    logic [11:0] w8  [0:5];                             // luma 8 : n=3, n2=0, log2 3: i = -3..2
    logic [11:0] w6  [0:3];                             // chroma : n=2, n2=1, log2 3: i = -2..1
    always_comb begin
        for (int i = -6; i <= 5; i++) w16[i + 6] = wide_val(i, 6, 1, 4);
        for (int i = -3; i <= 2; i++) w8[i + 3] = wide_val(i, 3, 0, 3);
        for (int i = -2; i <= 1; i++) w6[i + 2] = wide_val(i, 2, 1, 3);
    end
    // decision + output pixel for write position k
    typedef enum logic [1:0] {F_NONE, F_NARROW, F_WIDE8, F_WIDE16} fmode_t;
    fmode_t fmode, fmode_r;
    always_comb begin
        if (!filter_mask) fmode = F_NONE;
        else if (filter_size == 5'd4 || !flat) fmode = F_NARROW;
        else if (filter_size == 5'd8 || !flat2) fmode = F_WIDE8;
        else fmode = F_WIDE16;
    end
    always_ff @(posedge clk) begin fmode_r <= fmode; hev_r <= hev; filt_a_r <= filt_a_n; end
    logic [11:0] out_pix;
    logic        out_valid;                             // this k is modified
    logic signed [4:0] f_lo, f_hi;                      // range of modified positions for the decided filter
    always_comb begin
        case (fmode_r)
            F_NARROW: begin f_lo = -5'sd2; f_hi = 5'sd1; end
            F_WIDE8:  begin f_lo = (plane == 2'd0) ? -5'sd3 : -5'sd2; f_hi = (plane == 2'd0) ? 5'sd2 : 5'sd1; end
            F_WIDE16: begin f_lo = -5'sd6; f_hi = 5'sd5; end
            default:  begin f_lo = 5'sd0; f_hi = 5'sd0; end
        endcase
    end
    function automatic logic [12:0] lf_out(input logic signed [4:0] k);   // {modified, value} of position k
        logic [11:0] o; logic v;
        o = 12'd0; v = 1'b0;
        case (fmode_r)
            F_NARROW: begin
                case (k)
                    5'sd0:  begin o = nq0; v = 1'b1; end
                    -5'sd1: begin o = np0; v = 1'b1; end
                    5'sd1:  begin o = nq1; v = !hev_r; end
                    -5'sd2: begin o = np1; v = !hev_r; end
                    default: ;
                endcase
            end
            F_WIDE8: begin
                if (plane == 2'd0) begin v = (k >= -5'sd3) && (k <= 5'sd2); o = w8[int'(k) + 3]; end
                else begin v = (k >= -5'sd2) && (k <= 5'sd1); o = w6[int'(k) + 2]; end
            end
            F_WIDE16: begin v = (k >= -5'sd6) && (k <= 5'sd5); o = w16[int'(k) + 6]; end
            default: ;
        endcase
        return {v, o};
    endfunction
    always_comb {out_valid, out_pix} = lf_out(wk);
    // vertical edges: the group rd_g written back whole, modified lanes replaced
    logic [47:0] grp_out, grp_h;
    always_comb begin                                    // horizontal edges: row wk of the 4 columns
        for (int l = 0; l < 4; l++) begin
            logic [12:0] r;
            r = (wk >= -5'sd6 && wk <= 5'sd5) ? colout[l][int'(wk) + 6] : 13'd0;
            grp_h[l * 12 +: 12] = r[12] ? r[11:0] : pixc[l][7 + int'(wk)];
        end
    end
    always_comb begin
        for (int l = 0; l < 4; l++) begin
            logic signed [4:0] k; logic [12:0] r; logic [11:0] orig;
            k = rbase + 5'(4 * int'(rd_g)) + 5'(l);
            r = lf_out(k);
            orig = (k == -5'sd8) ? pix_m8 : (k == 5'sd7) ? pix_p7 : pix[7 + int'(k)];
            grp_out[l * 12 +: 12] = r[12] ? r[11:0] : orig;
        end
    end

    // ---------------------------------------------------------------- memory / frame buffer addressing
    logic signed [4:0] rk;                              // pixel offset being read
    assign rk = 5'(signed'({1'b0, kk})) - 5'(signed'({1'b0, n_rd >> 1}));
    always_comb begin
        rd_row = (st == L_EDGE) ? rowa : prow;
        rd_col = (st == L_EDGE) ? cola : pcol;
        txr_plane = plane;
        txr_row = ((st == L_EDGE) ? rowa : prow) >> sub_y;
        txr_col = ((st == L_EDGE) ? cola : pcol) >> sub_x;
        fb_re = 1'b0; fb_we = 1'b0; fb_plane = plane; fb_x = '0; fb_y = '0; fb_wdata = out_pix;
        fb4_we = 1'b0; fb4_x = FBX'(PXW'(signed'(sx) + PXW'(rbase) + PXW'(4 * int'(rd_g)))); fb4_y = FBY'(sy); fb4_wdata = grp_out;
        if (st == L_S_RD && !pss && kk <= 4'(n_rg)) begin        // group kk of the vertical-edge span
            fb_re = 1'b1;
            fb_x = FBX'(PXW'(signed'(sx) + PXW'(rbase) + PXW'(4 * int'(kk)))); fb_y = FBY'(sy);
        end
        if (st == L_S_RD && pss && kk < n_rd) begin        // the group of 4 columns at row sy + rk
            fb_re = 1'b1;
            fb_x = FBX'(sx); fb_y = FBY'(sy + PXW'(rk));
        end
        if (st == L_S_WR && pss) begin                     // row sy + wk of the 4 columns, modified lanes replaced
            fb4_we = 1'b1; fb4_x = FBX'(sx); fb4_y = FBY'(sy + PXW'(wk)); fb4_wdata = grp_h;
        end
        if (st == L_S_WR && !pss) fb4_we = 1'b1;
    end
    assign busy = (st != L_IDLE);

    // ---------------------------------------------------------------- FSM
    always_ff @(posedge clk) begin
        done <= 1'b0;
        if (rd_pend2 && pss2) for (int l = 0; l < 4; l++) pixc[l][rd_slot2] <= fb_rdata4[l * 12 +: 12];   // read issued two cycles ago lands now
        if (rd_pend2 && !pss2)                           // group rd_slot[1:0]: lane l is position rbase + 4 g + l
            for (int l = 0; l < 4; l++) begin
                int k;
                k = int'(rbase) + 4 * int'(rd_slot2[1:0]) + l;
                if (k == -8) pix_m8 <= fb_rdata4[l * 12 +: 12];
                else if (k == 7) pix_p7 <= fb_rdata4[l * 12 +: 12];
                else if (k >= -7 && k <= 6) pix[7 + k] <= fb_rdata4[l * 12 +: 12];
            end
        rd_pend <= 1'b0;
        rd_pend2 <= rd_pend && !rst; rd_slot2 <= rd_slot; pss2 <= pss;
        if (rst) st <= L_IDLE;
        else case (st)
            L_IDLE: if (start) begin
                plane <= 2'd0; pss <= 1'b0; row <= row_first; col <= MIW'(0);
                st <= (lh.level[5:0] == 6'd0 && lh.level[11:6] == 6'd0) ? L_DONE : L_EDGE;
            end
            L_EDGE: begin
                if (x >= lh.frame_width || y >= lh.frame_height || (!pss && x == PXW'(0)) || (pss && y == PXW'(0))) st <= L_NEXT;
                else st <= L_RD1;                        // cur read issued (addresses are combinational on the state)
            end
            L_RD1: begin cur <= rd_info; cur_tx <= txr_sz; st <= L_RD2; end     // prev read issued
            L_RD2: begin prv <= rd_info; prv_tx <= txr_sz; st <= L_CALC; end
            L_CALC: begin
                filter_size <= fsize_c;
                begin
                    logic [29:0] s;
                    s = (str_cur[29:24] != 6'd0) ? str_cur : str_prv;
                    lvl <= s[29:24]; limit <= s[23:16]; blimit <= s[15:8]; thresh <= s[7:0];
                    if (!apply_filter || s[29:24] == 6'd0) st <= L_NEXT;
                    else begin
                        i4 <= 2'd0; kk <= 4'd0;
                        n_rd <= (fsize_c == 5'd16) ? 4'd14 : (fsize_c == 5'd8) ? ((plane == 2'd0) ? 4'd8 : 4'd6) : 4'd4;
                        st <= L_S_RD;
                    end
                end
            end
            // ---- one sample: read n_rd pixels (k = -n_rd/2 .. n_rd/2-1), compute, write back the modified ones
            L_S_RD: begin
                if (pss ? (kk < n_rd) : (kk <= 4'(n_rg))) begin
                    rd_pend <= 1'b1; rd_slot <= pss ? 4'(7 + int'(rk)) : 4'(kk); kk <= kk + 4'd1;
                end else if (!rd_pend && !rd_pend2) begin
                    wk <= -5'sd7; rd_g <= 2'd0; cc <= 2'd0; any_mod <= 1'b0; f_lo_all <= 5'sd6; f_hi_all <= -5'sd7;
                    st <= L_S_CALC;
                end
            end
            L_S_CALC: begin                              // samples settled: decide, then write only the modified positions
                if (pss) begin                           // one column per cycle; then the union of modified rows
                    for (int k = -6; k <= 5; k++) colout[cc][k + 6] <= lf_out(5'(k));
                    if (fmode_r != F_NONE) begin
                        any_mod <= 1'b1;
                        if (f_lo < f_lo_all) f_lo_all <= f_lo;
                        if (f_hi > f_hi_all) f_hi_all <= f_hi;
                    end
                    if (cc != 2'd3) cc <= cc + 2'd1;
                    else if (any_mod || fmode_r != F_NONE) begin
                        wk <= (fmode_r != F_NONE && f_lo < f_lo_all) ? f_lo : f_lo_all;
                        w_hi <= (fmode_r != F_NONE && f_hi > f_hi_all) ? f_hi : f_hi_all;
                        st <= L_S_WR;
                    end else begin kk <= 4'd0; st <= L_NEXT; end
                end else if (fmode_r == F_NONE) begin
                    kk <= 4'd0;
                    if (i4 == 2'd3) st <= L_NEXT;
                    else begin i4 <= i4 + 2'd1; st <= L_S_RD; end
                end else begin wk <= f_lo; w_hi <= f_hi; st <= L_S_WR; end
            end
            L_S_WR: begin                                // horizontal edges: one modified position per cycle (wk); vertical: one group per cycle (rd_g)
                if (pss ? (wk == w_hi) : (rd_g == n_rg)) begin
                    kk <= 4'd0;
                    if (i4 == 2'd3 || pss) st <= L_NEXT;    // a horizontal position's 4 columns were done together
                    else begin i4 <= i4 + 2'd1; st <= L_S_RD; end
                end else begin wk <= wk + 5'sd1; rd_g <= rd_g + 2'd1; end
            end
            // ---- next edge position: col, row, pass, plane
            L_NEXT: begin
                if (col + (MIW'(1) << sub_x) < hdr.mi_cols) begin col <= col + (MIW'(1) << sub_x); st <= L_EDGE; end
                else begin
                    col <= MIW'(0);
                    if (row + (MIW'(1) << sub_y) <= row_last && row + (MIW'(1) << sub_y) < hdr.mi_rows) begin row <= row + (MIW'(1) << sub_y); st <= L_EDGE; end
                    else begin
                        row <= row_first;
                        if (!pss) begin pss <= 1'b1; st <= L_EDGE; end
                        else begin
                            pss <= 1'b0;
                            // next plane with a non-zero level (plane 0 always runs when we got here)
                            if (plane == 2'd0 && !hdr.mono && lh.level[17:12] != 6'd0) begin plane <= 2'd1; st <= L_EDGE; end
                            else if (plane <= 2'd1 && !hdr.mono && lh.level[23:18] != 6'd0) begin plane <= 2'd2; st <= L_EDGE; end
                            else st <= L_DONE;
                        end
                    end
                end
            end
            L_DONE: begin done <= 1'b1; st <= L_IDLE; end
            default: st <= L_IDLE;
        endcase
    end
endmodule
