Jonahss/openav1/rtl/ipred.sv

// openav1 — intra predictor (AV1 spec 7.11.2), four pixels per clock.
//
// The caller loads the prepared edges (AboveRow[0..w+h-1], LeftCol[0..w+h-1], top-left) through
// the edge write port, sets the parameters and pulses start (both taken one cycle late, see the port register). The block then
//   1. runs the spec's edge preparation passes in place for directional modes
//      (filter corner, intra edge filter per side, 2x upsampling per side),
//   2. for DC, sums the available edges eight per clock and divides in one cycle,
//   3. emits pred[i][j] in raster order, four pixels per clock (an aligned group of columns), with (x, y) of
//      the group's first pixel alongside.
//
// Edge storage: A[] = AboveRow, L[] = LeftCol, indexed -2 .. 257 (index -1 holds the top-left
// sample of that side, exactly like the spec's two arrays; upsampling may rewrite it).
// Filter-intra keeps its own copy of the emitted pixels (max 32x32) for the recursion.
module ipred #(
    parameter int PW = 12                    // pixel width (covers 8/10/12-bit)
) (
    input  logic          clk,
    input  logic          rst,

    // ---- edge write port (while idle). side 0 = AboveRow[idx], 1 = LeftCol[idx], 2 = top-left ----
    input  logic          edge_we,
    input  logic [1:0]    edge_side,
    input  logic [7:0]    edge_idx,
    input  logic [PW-1:0] edge_data,
    input  logic          edge_we4,          // AboveRow[edge_idx .. edge_idx+3] <= edge_data4 lanes (edge_idx a multiple of 4)
    input  logic [4*PW-1:0] edge_data4,

    // ---- parameters (sampled at start) ----
    input  logic          start,
    input  logic [3:0]    mode,             // DC_PRED=0 .. PAETH_PRED=12 (spec order)
    input  logic          use_filter_intra,
    input  logic [2:0]    filter_intra_mode,
    input  logic signed [2:0] angle_delta,  // -3..3
    input  logic [2:0]    log2w,
    input  logic [2:0]    log2h,
    input  logic [3:0]    bit_depth,
    input  logic          have_left,
    input  logic          have_above,
    input  logic          filter_type,      // smooth neighbour (intra filter type process)
    input  logic          edge_filter_en,   // enable_intra_edge_filter
    input  logic [6:0]    above_px,         // Min(w, maxX - x + 1)
    input  logic [6:0]    left_px,          // Min(h, maxY - y + 1)
    output logic          busy,
    output logic          done,

    // ---- prediction output stream ----
    output logic          out_valid,
    output logic [5:0]    out_x,
    output logic [5:0]    out_y,
    output logic [4*PW-1:0] out_pix4       // pixels (out_x .. out_x+3, out_y), lane l at [l*PW +: PW]
);
    localparam int EOFF = 2;                 // edge index k is stored at k + EOFF
    localparam int ESZ  = 260;               // -2 .. 257

    localparam logic [3:0] DC_PRED = 0, SMOOTH_PRED = 9, SMOOTH_V_PRED = 10, SMOOTH_H_PRED = 11, PAETH_PRED = 12;

    // Idle-time port register (2026-10-31): the edge write port and start are taken one cycle late. The frame memory's
    // read data reaches this port from the double-pumped memory's mid-cycle register (frame_mem_uram a_q_r), so the
    // logic between that register and the first clk register here has half a clk cycle; the U200 image at 100 MHz
    // missed by 0.21 ns on a_q_r -> the request merge below -> bwdA_r (11 LUT levels, 83 % routing). Registered, the
    // half cycle holds only the pixel selects of frame_mem_uram and recon_top and the merge has a full cycle. The
    // block's internal timing is unchanged (every input shifts together); the caller sees busy / done one cycle later
    // and already waits for done (recon_top R_IP_W).
    logic            edge_we_q, edge_we4_q, start_q;
    logic [1:0]      edge_side_q;
    logic [7:0]      edge_idx_q;
    logic [PW-1:0]   edge_data_q;
    logic [4*PW-1:0] edge_data4_q;
    always_ff @(posedge clk) begin
        edge_we_q <= edge_we && !rst; edge_we4_q <= edge_we4 && !rst; start_q <= start && !rst;
        edge_side_q <= edge_side; edge_idx_q <= edge_idx; edge_data_q <= edge_data; edge_data4_q <= edge_data4;
    end

    // Edge storage in four banks each (entry e at bank e & 3, address e >> 2), as distributed RAM: every read site
    // is then a small asynchronous RAM port instead of a 260:1 mux. All writes come from the sequencer below and
    // never hit one bank twice in a clock (the 4-wide group write is aligned, the upsampler's pairs are adjacent).
    localparam int BKD = (ESZ + 3) / 4;
    (* ram_style = "distributed" *) logic [PW-1:0] A0 [0:BKD-1];
    (* ram_style = "distributed" *) logic [PW-1:0] A1 [0:BKD-1];
    (* ram_style = "distributed" *) logic [PW-1:0] A2 [0:BKD-1];
    (* ram_style = "distributed" *) logic [PW-1:0] A3 [0:BKD-1];
    (* ram_style = "distributed" *) logic [PW-1:0] L0 [0:BKD-1];
    (* ram_style = "distributed" *) logic [PW-1:0] L1 [0:BKD-1];
    (* ram_style = "distributed" *) logic [PW-1:0] L2 [0:BKD-1];
    (* ram_style = "distributed" *) logic [PW-1:0] L3 [0:BKD-1];
    // Edge read ports: NRP per side. Every port is read every clock at the address the sequencer state puts on it
    // (rp_addr, below); each consumer takes its values from its own ports. Reading the banks through a function
    // from many sites let Vivado merge the reads onto shared ports, and the netlist read zeros (LESSONS 2026-10-11).
    localparam int NRP = 8;
    logic signed [9:0] rpA_a [NRP], rpL_a [NRP];        // edge index -2 .. 257
    logic [9:0]        rp_eA [NRP], rp_eL [NRP];        // + EOFF: bank = [1:0], bank address = [8:2]
    logic [PW-1:0]     rpA_d [NRP], rpL_d [NRP];
    always_comb begin
        for (int q = 0; q < NRP; q++) begin
            rp_eA[q] = 10'(rpA_a[q] + 10'sd2);
            rp_eL[q] = 10'(rpL_a[q] + 10'sd2);
            case (rp_eA[q][1:0])
                2'd0: rpA_d[q] = A0[rp_eA[q][8:2]];
                2'd1: rpA_d[q] = A1[rp_eA[q][8:2]];
                2'd2: rpA_d[q] = A2[rp_eA[q][8:2]];
                default: rpA_d[q] = A3[rp_eA[q][8:2]];
            endcase
            case (rp_eL[q][1:0])
                2'd0: rpL_d[q] = L0[rp_eL[q][8:2]];
                2'd1: rpL_d[q] = L1[rp_eL[q][8:2]];
                2'd2: rpL_d[q] = L2[rp_eL[q][8:2]];
                default: rpL_d[q] = L3[rp_eL[q][8:2]];
            endcase
        end
    end
    // Edge writes: each write site of the sequencer posts a request (side, edge index, value) into its own slot
    // for the current clock, and a bank takes the request addressed to it. So every bank has exactly one write
    // port (the LUT-RAM template) while the sequencer keeps its natural "write edge[k]" form. A later slot wins
    // over an earlier one, matching the statement order the sites had in the sequencer.
    localparam int NRQ = 7;
    logic                 rq_v    [NRQ];   // request valid
    logic                 rq_side [NRQ];   // 0 = above, 1 = left
    logic signed [9:0]    rq_idx  [NRQ];   // edge index -2 .. 257
    logic [PW-1:0]        rq_d    [NRQ];
    logic [9:0]           rq_e    [NRQ];   // idx + EOFF (0 .. 259): bank = rq_e[1:0], address = rq_e[8:2]
    logic          bweA [4], bweL [4];
    logic [6:0]    bwaA [4], bwaL [4];
    logic [PW-1:0] bwdA [4], bwdL [4];
    always_comb begin
        for (int b = 0; b < 4; b++) begin
            bweA[b] = 1'b0; bwaA[b] = '0; bwdA[b] = '0;
            bweL[b] = 1'b0; bwaL[b] = '0; bwdL[b] = '0;
            for (int r = 0; r < NRQ; r++)
                if (rq_v[r] && rq_e[r][1:0] == 2'(b)) begin
                    if (!rq_side[r]) begin bweA[b] = 1'b1; bwaA[b] = rq_e[r][8:2]; bwdA[b] = rq_d[r]; end
                    else             begin bweL[b] = 1'b1; bwaL[b] = rq_e[r][8:2]; bwdL[b] = rq_d[r]; end
                end
        end
    end
    // The resolved bank writes are registered and land one cycle after they are posted: the filter / upsample
    // arithmetic behind a bank read and the routing to the replicated banks (one copy per read port) were one path
    // (-1.09 ns at 80 MHz with the read addresses already registered, 2026-10-18). A value read the cycle after it
    // was posted therefore reads the old entry; the sequencer never does that except across two transitions, which
    // take a one-cycle bubble (S_EF_PRE after the corner write, S_UP_DONE after the last upsample step): the edge
    // filter already bypasses its own last two writes through o0 / o1, the upsampler reads only positions it has
    // not yet written (and buf[1] from up_save1), and every other write precedes its first read by two cycles.
    logic          bweA_r [4], bweL_r [4];
    logic [6:0]    bwaA_r [4], bwaL_r [4];
    logic [PW-1:0] bwdA_r [4], bwdL_r [4];
    always_ff @(posedge clk) for (int b = 0; b < 4; b++) begin
        bweA_r[b] <= bweA[b] && !rst; bwaA_r[b] <= bwaA[b]; bwdA_r[b] <= bwdA[b];
        bweL_r[b] <= bweL[b] && !rst; bwaL_r[b] <= bwaL[b]; bwdL_r[b] <= bwdL[b];
    end
    always_ff @(posedge clk) begin
        if (bweA_r[0]) A0[bwaA_r[0]] <= bwdA_r[0];
        if (bweA_r[1]) A1[bwaA_r[1]] <= bwdA_r[1];
        if (bweA_r[2]) A2[bwaA_r[2]] <= bwdA_r[2];
        if (bweA_r[3]) A3[bwaA_r[3]] <= bwdA_r[3];
        if (bweL_r[0]) L0[bwaL_r[0]] <= bwdL_r[0];
        if (bweL_r[1]) L1[bwaL_r[1]] <= bwdL_r[1];
        if (bweL_r[2]) L2[bwaL_r[2]] <= bwdL_r[2];
        if (bweL_r[3]) L3[bwaL_r[3]] <= bwdL_r[3];
    end
    logic [PW-1:0] TL_in;                    // top-left as written through the port

    // ------------------------------------------------------------------ latched parameters
    logic [3:0]  l_mode;
    logic        l_fi;
    logic [2:0]  l_fimode;
    logic [2:0]  l_log2w, l_log2h;
    logic [6:0]  w, h;
    logic [7:0]  wh;
    logic [3:0]  l_bd;
    logic        l_hl, l_ha, l_ft, l_efe;
    logic [6:0]  l_apx, l_lpx;
    logic [8:0]  p_angle;
    logic        up_a, up_l;
    logic [10:0] dx, dy;
    // The directional index products (i+1)*dx (per row) and (j+1)*dy (per lane) are kept in registers and
    // stepped as the position advances (+dx per row, +4*dy per lane step), instead of multiplied every cycle in
    // front of the edge-RAM address (a DSP into the read address was the block's worst path, -2.9 ns at 100 MHz).
    // dx/dy are derived as the block starts (S_IDLE) and the registers loaded in S_SETUP, so they are valid from
    // the first S_PIX cycle with no bypass mux in the address path.
    logic [16:0] idx_i_r;
    logic [16:0] idx_j_r [4];
    logic [5:0]    px, py;
    // The position after this one (the S_PIX / S_FI2 stepping: four lanes along the row, then the next row), used
    // both for the register updates and for the edge-read address lookahead below.
    logic        nx_row_end;
    logic [5:0]  nx_px, nx_py;
    logic [16:0] nx_idx_i;
    logic [16:0] nx_idx_j [4];
    always_comb begin
        nx_row_end = (px + 7'd4 >= w);
        nx_px = nx_row_end ? 6'd0 : px + 6'd4;
        nx_py = nx_row_end ? py + 6'd1 : py;
        nx_idx_i = nx_row_end ? idx_i_r + 17'(dx) : idx_i_r;
        for (int l = 0; l < 4; l++) nx_idx_j[l] = nx_row_end ? 17'((l + 1) * int'(dy)) : idx_j_r[l] + (17'(dy) << 2);
    end
    // Edge-read address lookahead: the S_PIX read addresses of a position are computed the cycle before, from
    // the next-position values (in S_PIX) or from the current position (any other state, so the first S_PIX
    // cycle finds its addresses ready), into registers. The index -> address arithmetic (shifts, the Z1 limit
    // compare, the mode mux) then no longer sits in front of the edge RAMs' high-fanout address pins, which
    // was 8 ns of routing at 100 MHz in the placed core build.
    logic signed [9:0] la_a0 [4], la_a1 [4], la_l0 [4], la_l1 [4];
    // Z1's edge limit (w+h-1) << up_a is constant over a block: registered (it was computed in front of the
    // edge-RAM address compare every cycle; w, h, up_a are stable at least a cycle before the first S_PIX).
    logic [9:0]  maxb_r;
    always_ff @(posedge clk) maxb_r <= 10'((int'(w) + int'(h) - 1) << int'(up_a));
    logic [PW-1:0] pix_max;
    assign pix_max = PW'((1 << l_bd) - 1);
    wire is_dir = !l_fi && (l_mode >= 4'd1) && (l_mode <= 4'd8);

    // ------------------------------------------------------------------ tables (spec)
    function automatic logic [8:0] mode_to_angle(input logic [3:0] m);
        case (m)
            4'd1: mode_to_angle = 90;  4'd2: mode_to_angle = 180; 4'd3: mode_to_angle = 45;  4'd4: mode_to_angle = 135;
            4'd5: mode_to_angle = 113; 4'd6: mode_to_angle = 157; 4'd7: mode_to_angle = 203; 4'd8: mode_to_angle = 67;
            default: mode_to_angle = 0;
        endcase
    endfunction

    function automatic logic [10:0] dr_intra_derivative(input logic [8:0] a);
        case (a)
            9'd3: dr_intra_derivative = 1023; 9'd6: dr_intra_derivative = 547; 9'd9: dr_intra_derivative = 372;
            9'd14: dr_intra_derivative = 273; 9'd17: dr_intra_derivative = 215; 9'd20: dr_intra_derivative = 178;
            9'd23: dr_intra_derivative = 151; 9'd26: dr_intra_derivative = 132; 9'd29: dr_intra_derivative = 116;
            9'd32: dr_intra_derivative = 102; 9'd36: dr_intra_derivative = 90;  9'd39: dr_intra_derivative = 80;
            9'd42: dr_intra_derivative = 71;  9'd45: dr_intra_derivative = 64;  9'd48: dr_intra_derivative = 57;
            9'd51: dr_intra_derivative = 51;  9'd54: dr_intra_derivative = 45;  9'd58: dr_intra_derivative = 40;
            9'd61: dr_intra_derivative = 35;  9'd64: dr_intra_derivative = 31;  9'd67: dr_intra_derivative = 27;
            9'd70: dr_intra_derivative = 23;  9'd73: dr_intra_derivative = 19;  9'd76: dr_intra_derivative = 15;
            9'd81: dr_intra_derivative = 11;  9'd84: dr_intra_derivative = 7;   9'd87: dr_intra_derivative = 3;
            default: dr_intra_derivative = 0;
        endcase
    endfunction

    function automatic logic [1:0] edge_strength(input logic [7:0] blk, input logic ft, input logic [8:0] d);
        logic [1:0] s;
        s = 0;
        if (!ft) begin
            if (blk <= 8)       begin if (d >= 56) s = 1; end
            else if (blk <= 12) begin if (d >= 40) s = 1; end
            else if (blk <= 16) begin if (d >= 40) s = 1; end
            else if (blk <= 24) begin if (d >= 8) s = 1; if (d >= 16) s = 2; if (d >= 32) s = 3; end
            else if (blk <= 32) begin s = 1; if (d >= 4) s = 2; if (d >= 32) s = 3; end
            else s = 3;
        end else begin
            if (blk <= 8)       begin if (d >= 40) s = 1; if (d >= 64) s = 2; end
            else if (blk <= 16) begin if (d >= 20) s = 1; if (d >= 48) s = 2; end
            else if (blk <= 24) begin if (d >= 4) s = 3; end
            else s = 3;
        end
        edge_strength = s;
    endfunction
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
