Jonahss/openav1/(commit log)

2026-09-27 msac: arithmetic decoder RTL, dav1d-trace replay TB, spec-model fuzz TB (Pi mirror while sexica is down)
2026-09-27 itx2d: 2D inverse transform block (rows -> clamp -> cols, rect scaling, lossless WHT), fuzz over all 19 sizes; latch engine params; prog-start table as module for Yosys
2026-09-27 intra_model: spec-literal intra prediction (paeth, filter-intra, directional w/ edge filter+upsample, DC, smooth) + CfL
2026-09-27 Pi oracle host: dav1d trace patch v3 (edges, CfL, row-major coefs), synthetic streams, trace cross-check tool
2026-09-27 ipred: intra predictor RTL bit-exact vs dav1d on 5,842 trace blocks; trace v3 logs raw corner; replay TB; regress runs ipred replay
2026-09-27 trace v3: H event (frame header + tile bounds) at setup_tile; gen_spec_tables: brace-on-next-line tables, derived Block_Width/Height (212 tables)
2026-09-27 tile_model: spec-literal intra tile syntax decoder (all of 5.11 for intra frames + 8.3.2 contexts + 7.12.3 dequant); xcheck_tile compares every symbol/range/CDF and every coefficient block with dav1d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
2026-09-27 recon_model: whole-frame intra reconstruction (edge availability 7.11.2.1, palette, CfL, flips) bit-exact vs dav1d P/Q/R on all 6 streams; xcheck_recon; regress runs tile+recon checks
2026-09-27 lf_model: deblocking loop filter (7.14) — full frames bit-exact vs dav1d output on lf-only streams (8/10-bit); xcheck_frame; H event carries LF/CDEF params; regress checks frames
2026-09-27 cdef_model (7.15): full frames bit-exact vs dav1d on lf+cdef streams (8/10-bit); FrameState merge for multi-tile frames; regress frame checks for cdef streams
2026-09-27 lr_model (7.17): Wiener + self-guided loop restoration with stripe rule; full pipeline (recon→LF→CDEF→LR) bit-exact vs dav1d output on lf_cdef_lr streams; tile_model stores per-unit LR params; regres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
2026-09-27 obu_parser: OBU/IVF/Annex B + sequence/frame header parser (all fields == dav1d on the corpus); tools/decode.py standalone Python intra decoder; regress checks headers + standalone decode
2026-09-27 coverage corpus (odd sizes, sb128+tiles, qm/deltaq, 444/422/12-bit/mono): frame buffer padding, CDEF availability by MI size; D trace event for interleaved tiles; harnesses route by tile; regress cov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
2026-09-27 synthetic stream generator: arithmetic encoder (msac_enc), OBU/IVF writer, gen_stream (RecordingDecoder-driven random syntax), fuzz_streams.sh differential harness; first stream byte-identical dav1d 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
2026-09-27 syntax decoder RTL part 2: blk_ctx (above/left records, seg strip, coefficient contexts), blk_syntax (intra mode info, delta q/lf, cdef, tx size, residual loop), tile_syntax (superblock loop + partit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
    [blk_ctx.sv, blk_syntax.sv, coef_top.sv, sym_seq.sv]
2026-09-27 pal_syntax: palette_mode_info (on-the-fly cache merge, delta colours, sort network, V wrap deltas) + palette_tokens (diagonal-buffer colour context, per-plane map memory) integrated into blk_syntax (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
    Co-Auth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
    [blk_syntax.sv, pal_syntax.sv, syn_pkg.sv, tile_syntax.sv]
2026-09-27 recon_top + dec_top: intra reconstruction in RTL (dequant with Dc/Ac_Qlookup + Quantizer_Matrix ROM, edge preparation 7.11.2.1 from the frame buffer, ipred/cfl/palette prediction, itx2d, flip-aware a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
    Repo scaffolding for publication: README (purpose, method, s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
    [blk_ctx.sv, blk_syntax.sv, dec_top.sv, frame_mem.sv]
2026-09-27 lf_top + mi_store: deblocking loop filter in RTL (spec 7.14: frame-level plane/pass/row/col walk, edge + filter-size + strength from per-4x4 state, per-sample masks, narrow and 6/8/14-tap wide filter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
    [lf_tb_top.sv, lf_top.sv, mi_store.sv, syn_pkg.sv]
2026-09-27 dec_top: deblocking filter integrated (recon_top writes per-4x4 state into mi_store with writer back-pressure; lf_top owns the frame buffer while lf_busy; lf_start/lf_done); test_dec_top TS_STAGE=lf 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
2026-09-28 cdef_top + lr_top: CDEF (7.15: direction search with 8x15 partial sums and 64 MAC terms, variance-adaptive strength, constrained directional filter, chroma direction map) and loop restoration (7.17: 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
    Co-Authored-By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
2026-09-28 dec_top: loop restoration integrated (third frame buffer, unit records from lr_done, lr_from_deblocked source select for CDEF-off frames, h_buf 0/1/2); test TS_STAGE=lr; tools/cmp_dump_refout.py comp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
2026-09-28 test_dec_top: TS_NOMODEL mode (RTL runs deblock/CDEF/restoration from the headers; output compared with dav1d's decoded frames; Annex B inputs) for conformance-scale runs
2026-09-28 runner: FBX/FBY parameters for the frame-level tops (mi_store / mode-map capacity derived); test_dec_top model-free mode gains md5 references (Argon layout); tools/nightly.sh regression driver
2026-09-28 obu_parser: buffer_removal_time is only present for operating points containing the OBU's temporal/spatial layer (Argon streams with extension headers desynced the frame header)
2026-09-28 tools/trace.sh: DAV1D_EXTRA passthrough (e.g. --filmgrain 0)
2026-09-28 test_tile_syntax: TS_IVF mode (real IVF / Annex B streams); test_dec_top: reference slicing follows per-frame sizes
2026-09-28 dec_top: tile_done_lvl (held until the next tile_start); runner SIM_FAST=1 (Verilator -O3, -CFLAGS -O2, threads); test_dec_top model-free fast path polls busy levels every 128-256 cycles and logs per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
2026-09-28 Argon RTL results write-up (36 frames identical, 5 streams stop on intrabc); close stream files in the testbenches
2026-09-28 RTL: intra block copy syntax (mv_stack, mv_mem, MV coding, var-tx trees, inter tx types, leaf residual walk) and block-copy prediction in recon_top
    Model: tx_depth ctx counts inter neighbours with their block size (Argon test5366). dav1d trace hooks now
    cover inter blocks; xcheck_frame / test_dec_top map decoded frames to dav1d's output pictures through
    show_frame / show_existing_frame (obu_parser.shown_frames). Tile-level RTL test: test4592 473 blocks exact.
2026-09-28 RTL: transform-tree walk child count at full width (test5366 tile-exact, 4914 blocks); super-resolution model (7.16) wired before loop restoration in the frame check; README status row for intra bloc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
2026-09-28 RTL: super-resolution upscaler (7.16) sr_top, in place through a line buffer, run on the deblocked and CDEF frames before loop restoration; harness sizes output pictures by UpscaledWidth
    Model: superres_model.py verified against dav1d on Argon test60 / test5644 / test6617 (60->67, 255->447, 1706->1919).
2026-09-28 sr_top: copy MiCols*4 decoded samples per row (the filter clamps to the MI-aligned width); test60 and test5644 pictures identical through the RTL; tools/argon_batch.py plans model-free Argon batches 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
2026-09-28 LR unit syntax under super-resolution: unit columns scale by SuperresDenom / SUPERRES_NUM (hdr_t carries use_superres + superres_denom); tile test on Argon test7463 exact (48 units); testbench logs N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
2026-09-28 nightly: Argon feature streams (intrabc, superres, re-shown frames) when the Argon set is present
2026-09-28 lr_top: row-streaming loop restoration (ring of 16 tagged line buffers, per band x unit segment; Wiener/copy one sample per clock, self-guided one box position per clock)
    Same ports and results: 25 real frames + generated frames identical to the model; 640x360 4:2:0 frame 722 k cycles (was 5.1 M).
2026-09-28 cdef_top: window version (12x12 window per block and plane, direction search in one cycle, one filtered sample per clock)
    36 real frames + generated frames identical to the model; 4.0 cycles per pixel (was 19-28).
2026-09-28 mv_mem: explicit written-this-frame bitmap (64 rows, cleared per superblock row) replaces the frame-parity tag; nothing depends on memory initialisation
    Tile tests test8304 / test4592 exact.
    [blk_syntax.sv, mv_mem.sv, mv_stack.sv, syn_pkg.sv, tile_syntax.sv]
2026-09-28 lf_top: write only the modified sample positions (no -7..6 scan); real frames identical, 640x360 frame 1.37 M cycles (was 2.33 M)
2026-09-28 rec_fifo: event queue between tile syntax and reconstruction (superblock start / block / transform block, 8-slot coefficient buffer in coef_rd); the syntax decoder runs ahead of reconstruction; dec_t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
    Corpus (4 frames) and Argon test4592 / test8304 identical; reconstruction is now the tile-stage bottleneck.
    [blk_syntax.sv, coef_rd.sv, dec_top.sv, rec_fifo.sv, recon_top.sv, syn_pkg.sv]
2026-09-28 recon_top: dequant one coefficient per clock and residual add one pixel per clock; frame_mem gains a second write port so the add reads on port 1 and writes on port 2; per-state cycle counters (TS_PE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
    Corpus (3 streams, 6 frames), Argon 4592/8304 (8 frames) and the deblock suite identical; 640x360 tile 1.59 M cycles (was 2.02 M with the event queue alone).
2026-09-28 itx2d: NLANES (4) parallel 1D engines, one row/column group per pass; recon_top: dequant walks only the coded coefficients in scan order (own scan_rom), itx2d coefficient array cleared per block
    Generated frames, corpus (6 frames) and Argon 4592/8304 (8 frames) identical; 640x360 tile 1.045 M cycles (was 1.59 M); a 4x4 DCT block's transform is 14 cycles (was ~52).
2026-09-28 4-wide reconstruction: frame_mem gains a 4-sample write port and a 4-sample read (aligned groups in x); ipred emits 4 pixels per clock (DC sums 8 edge samples per clock, single-cycle divide); recon_t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
    ipred fuzz (400 blocks), generated frames, corpus (6 frames) and Argon 4592/8304 (8 frames) identical; 640x360 tile 625 k cycles (was 1.045 M). Hardware note: the 4-wide ports are 4 banks by x mod 4.
2026-09-28 syntax-side profiling: per-state cycle counters in tile_syntax, blk_syntax and coef_rd; the testbench prints the top states of each with TS_PERF=1 (names parsed from the RTL enums)
    First profile (640x360 frame): the block FSM waits 37% for the reconstruction queue and 28% for the coefficient reader, which costs ~15 cycles per coefficient.
2026-09-28 cdef_top / lf_top: 4-wide frame buffer access. CDEF loads its 12x12 window as aligned groups of 4 (4 reads per luma row, 3 per chroma row) and copies unfiltered blocks 4 samples per read/write pair; 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
    CDEF real frames: 36 identical, 2.2 cycles/pixel (was 4.0). Deblock real frames: 44 identical, 1.8 cycles/pixel (was ~2.0). Corpus + Argon (incl. superres + CDEF + LR stream) identical through dec_top.
    [cdef_tb_top.sv, cdef_top.sv, dec_top.sv, lf_tb_top.sv, lf_top.sv]
2026-09-28 Stage pipelining: the in-loop filters trail the tile decoder by superblock rows (frame time = the slowest stage, not the sum)
    frame_mem v3: NRD read ports (sample + aligned group of 4) and NWR write ports (4 lanes with enables) so that
    reconstruction, deblocking, CDEF, super-resolution and loop restoration access the picture concurrently; a
    frame_mem_w adapter turns a stage's single/4-wide writes into one port; the *_busy port muxes are gone.
    lf_top / cdef_top take a superblock-row range (mi rows), lr_top / sr_top a luma-row range; whole-frame when the
    range covers the frame. mi_store gains a second read port (CDEF alongside the deblocking filter).
    dec_top frame sequencer (pipe_en): rows com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
2026-09-28 lf_top: horizontal edges filter the 4 columns of a position at once (rows across the edge read as aligned groups, one decision per column over 4 cycles, modified rows written back as groups)
    Real frames: 44 identical, 1.23 cycles/pixel (was 1.77).
2026-09-28 cdef_top: four filtered samples per clock (the constrained filter as a function of the block position, evaluated for an aligned group of 4 columns, written through the 4-wide port)
    Real frames: 36 identical, 1.41 cycles/pixel (was 2.16).
2026-09-28 lr_top: 4-wide line-buffer loads and four output samples per clock (source / Wiener / self-guided blend as functions of the column), written with lane enables at segment edges
    Real frames: 25 identical, 0.73 cycles/pixel (was 2.3). With the three filter changes a 640x360 frame decodes in ~1.12 M cycles pipelined (tile 625 k + filter tail 497 k); corpus and Argon identical in both modes.
2026-09-28 recon_top: the above-row edges are gathered as aligned groups of 4 (the clamp past AboveRow's last available sample replicates it per lane); ipred gains a 4-wide edge write port
    640x360 tile 559 k cycles (was 625 k), edge state 143 k (was 214 k); corpus (6) and Argon (9) frames identical pipelined; ipred fuzz 300 blocks.
2026-09-28 itx1d: the 4-point DCT as one dedicated row (permutation, two rotations and two Hadamards in a step, like ADST4); the generator emits it for n = 2 and replays it with the spec model
    1-D fuzz 1950 vectors / 2-D fuzz 152 blocks / corpus pipelined identical. Small effect on the corpus (intra 4x4 blocks mostly use ADST types, already single-row): transform state 125.5 k -> 123.3 k cycles on the 640x360 frame.
2026-09-28 test_dec_top: transform size x type x no-residual histogram per frame under TS_PERF (model-compare mode)
2026-09-29 Showcase demo: tools/demo.sh, decode-progress trace and renderer
    tools/demo.sh decodes one picture with the RTL (pipelined mode), compares it with dav1d's picture and
    renders both side by side; streams/demo holds a 640x360 and a 320x180 key frame of a Wyldcard dev kit
    photo (aomenc cq18, deblock+CDEF+restoration on). The reference picture is made with dav1d on first use.
    tb/test_dec_top.py: with TS_DUMP, identical frames are now written out too (<stream>_frame_<n>.rtl.yuv,
    the name tools/cmp_dump_refout.py expects). tb/runner.py: TS_VIS=<file> passes +vis=<file>.
    rtl/dec_top.sv (Verilator only): +vis=<file> writes one line per reconstructed transform block and per
    finished filter row with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
2026-09-30 Fix two screen-content bugs found by Argon fb10x12 (128-px SB, narrow pictures)
    blk_syntax: the neighbour width/height used for the tx_depth and txfm_split contexts (spec 8.3.2
    get_above_tx_width / get_left_tx_height) was 7 bits, so a skipped inter (intrabc) neighbour of block size
    128 read as 0 and the context was off by one: the entropy decoder desynchronised at the first such
    neighbour and the rest of the picture was garbage (Argon test10440 f4, test10485 f2, test10487 f0, all
    128-px superblocks). Widened to 8 bits.
    pal_syntax: the palette colour map was only written for the onscreen part of the block; spec 5.11.49
    replicates the last onscreen column/row into the rest, and that part is r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
    [blk_syntax.sv, pal_syntax.sv]
2026-09-30 dec_top: no declaration initializer on the vis cycle counter (Verilator 5.05 PROCASSINIT is fatal under -Wall; the process resets it)
    [dec_top.sv]
2026-10-10 argon_index: frame size = max over all sequence headers
    Argon splices several tests into one stream, each with its own sequence
    header; the index kept only the last one, so test11016_11097 (16384x2470
    behind a 75x8960 header) and test11106_11154_11129 were filed under a
    75-px-wide class and the batch tried to simulate 147 Mpx frames. 236 of
    the 765 profile0_core streams change size; the 60 that ran were correct
    apart from those two.
2026-10-10 Argon batch: classes run in parallel, one build dir per FBX/FBY
    tb/runner.py builds build/<top>_fb<X>x<Y> when FBX is set, so classes no
    longer share build/dec_top. argon_batch.py emits a run.sh that starts up
    to --jobs classes at once (default one per class, largest first) with
    --threads Verilator threads each (default cores / jobs), and stamps the
    summary with the job/thread counts. Sims are ~1 core each, so this is
    where a 64-thread box pays off.
2026-10-10 Parametric coordinate widths: frames up to 16384 px (MIW/SBW/PXW in syn_pkg)
    Row and column indices were hard-coded for frames up to 8192 px (11-bit
    MI, 7-bit superblock, 13-bit pixel), so a build with FBY=14 failed with
    Verilator SELRANGE in mi_store, mv_mem and recon_top. Every position and
    count now derives from three package constants (MIW=13, SBW=9, PXW=15,
    plus signed variants with headroom), the LR unit store is sized from
    ML2R/ML2C instead of a fixed 64x64 units per plane, and the testbench
    packing tables follow. Nightly gate (dec_top small/large, corpus_full_rtl,
    argon_features) green on atium; lr_top's row rule carries its source flag
    at bit PXW now, not a literal 14.
    Co-Authored-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
2026-10-10 Memories shaped for block-RAM inference; Vivado synthesis flow for the K26
    Vivado only infers RAM from arrays of plain vectors with one synchronous
    read, so mv_mem.mem, mi_store.lf_info and mi_store.lr_units are now flat
    vector arrays with the struct cast on at the read, and lf_info is kept as
    two identically written copies so each of its two readers has its own
    simple dual-port RAM. Behaviour is unchanged.
    synth/vivado/run.sh <FBX> <FBY> synthesises dec_top out of context for
    the xck26 with the frame buffer as a black box (frame_mem_bb.sv): the
    multi-port array in frame_mem.sv is a simulation model, the real design
    keeps pictures in DRAM behind per-stage line buffers, and leaving it
    extern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
2026-10-11 recon_top: BlockDecoded flags as 34-bit rows updated by masked ORs
    The flags were a 3 x 34 x 34 bit array written one bit at a time with
    computed indices: 256 such writes per transform block (16 x 16 loop) and
    1,156 per superblock start, each a decoder over the whole array, which
    Vivado never finished optimising (recon_top stalled for hours even with
    its children black-boxed). Rows are now the unit: a transform block ORs
    a shifted mask into up to 16 rows, the superblock-start pattern is a
    combinational table of rows, and the two availability reads select a bit
    of a row. Same values, same cycle timing.
2026-10-11 lr_top: line buffers in block RAM, sliding register window, fixed-position taps
    The 16-line ring was a 16 x W register array indexed at ~200 random
    columns per clock (7 lanes x 7 taps x 4 outputs, 25 box taps): 622k
    LUTs at a 256-wide build, five K26s. The lines are now block RAMs of
    4-sample words read once per clock at a common group address, and the
    filters read a 10-row x 12-column register window that advances with
    the column position (four-clock prologue per compute row), with the
    plane's edge samples replicated into the columns outside it so every
    tap is a fixed window position. Output rate unchanged (4 samples per
    clock; one box position per clock). The self-guided A/B tables are
    unc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
2026-10-11 ipred: edge arrays banked four ways as distributed RAM; filter-intra buffer as LUT RAM
    A[] and L[] (260 x 12 bits each) were read at ~50 sites, each a 260:1 mux
    after synthesis (ipred: 72k LUTs). Each is now four banks (entry e at
    bank e & 3) of distributed RAM, read through rA/rL and written through
    wA/wL; the aligned 4-wide group write lands one entry per bank and the
    upsampler's adjacent pairs never share a bank. fi_buf (one write, four
    lane reads) is tagged distributed as well. Fuzz vs the model passes.
2026-10-11 coef_rd: level map as valid-masked LUT RAM; coefficient store read registered then masked
    lev[1024] was cleared with a 1024-entry loop per block and read at five
    neighbourhood positions per clock as flops (coef_rd: 30k LUTs). It is
    distributed RAM now, behind a valid bit per position that the block
    start clears in one clock. quant_mem's read register no longer carries
    the non-zero mask inside it, so the 8192 x 21 store infers as block RAM.
    coef_top (the unit test top) connects the slot pins it had been missing
    since the slots were added; the unit test runs again and passes.
2026-10-11 ipred: one write port per edge bank; pal_syntax: colour maps as block RAM
    ipred's banked edge arrays were still flop forests: Vivado refused the LUT-RAM
    template because each bank was written from several sites of the sequencer.
    Every write site now posts a (side, index, value) request into its own slot and
    each bank takes the one addressed to it, so a bank sees exactly one write port.
    The sequencer keeps its 'write edge[k]' form; behaviour and cycle counts are
    unchanged (ipred fuzz: 300 blocks match the model). The filter-intra buffer is
    read as a whole word and then sliced, for the same template.
    pal_syntax's two 4096-entry colour maps are written through one (we, addr,
    data) port and rea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
2026-10-11 ipred: spell out the filter-intra lane select
    Vivado elaborated the filter-intra patch buffer as unused and removed it, both
    with the variable part-select directly on the array element and with it on a
    function-local copy of the word; a case over the eight lanes is the shape it
    understands. Simulation was unaffected (ipred fuzz passes before and after).
2026-10-11 ipred: filter-intra tap table as a module-level constant
    As a function-local array initialised inside fi_tap, Vivado evaluated the taps
    as zero: the whole filter-intra path folded to a constant and the patch buffer
    was dropped as unused, so hardware would have predicted zeros for every
    filter-intra block while simulation matched dav1d. The table is now a
    localparam the function indexes. Fuzz unchanged (300 blocks, 25 filter-intra).
2026-10-11 ipred: smooth-weight tables as module-level constants; patch-buffer address as bit fields
    Same shape as the filter-intra taps: tables initialised inside the function
    become module-level localparams. The filter-intra buffer entry is addressed by
    {row[4:1], col[4:2]} instead of the equivalent int arithmetic. Fuzz unchanged.
2026-10-11 ipred: filter-intra working variables at module scope
2026-10-11 ipred: filter-intra buffer written at {row[4:1], col[4:2]}
2026-10-11 ipred: filter-intra buffer declared with an explicit index range
2026-10-11 Declare every module-scope identifier before its first use (Vivado made implicit nets)
    Vivado turns an identifier used before its declaration into an implicit 1-bit
    net and only warns ([Synth 8-6901] / [Synth 8-8895]); Verilator accepts the
    same text silently. The whole-decoder synthesis had 25 of them, among them
    mi_store's three transform-size RAMs written before they were declared and the
    frame-buffer read-data buses connected to the filter instances in dec_top. The
    declarations now precede their uses (dec_top, recon_top, mi_store, tile_syntax,
    the lr test top), and tools/check_decl_order.py reports any new ones.
    Simulation is unchanged (dec_top and tile_syntax unit tests pass).
    Co-Autho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
2026-10-11 ipred: edge-write requests as plain arrays; gate-level replay harness
    The request slots are parallel arrays filled field by field through a task,
    instead of an unpacked struct array assigned with positional patterns, which
    is the shape least likely to be misread by a synthesiser. Fuzz unchanged.
    tools/vcd2vec.py turns a block-level simulation's waves into per-cycle port
    vectors, and tb/gate/replay_ipred.sv replays them in xsim against the RTL or a
    post-synthesis functional netlist, comparing the outputs cycle by cycle. The
    first run showed the synthesised ipred producing zero pixels on almost every
    block while every Verilator test passes: hardware correctness needs this
    check, not just simu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
2026-10-11 ipred: filter-intra buffer read through fixed ports
    The current patch word (four output lanes) and the three neighbouring words
    the next patch's taps need are read as four explicit ports instead of through
    a function called from the prediction and filter code. Read through the
    function, Vivado dropped the buffer and the netlist predicted zeros for the
    second row of every filter-intra patch (gate-level replay of b62ca8f: the one
    failing block was the filter-intra one). Fuzz unchanged.
2026-10-11 tools/gen_replay.py: generate a block's gate-level replay testbench from its ports
    Parses the module header (parameters, package localparams, packed struct and
    enum port types), emits the replay module and prints the vcd2vec signal lists.
    The ipred control build can zero the memories so xsim starts like Verilator.
2026-10-11 ipred: every edge read is an explicit port
    Eight read ports per edge side, read every clock; the sequencer state puts the
    addresses on them (the four output lanes' two above and two left reads, the
    filter-intra taps, the DC sum's eight samples, the edge filter's five taps,
    the upsampler's four) and each consumer takes its values from its own ports.
    pred_pix is split into an address half and a value half. Reading the banks
    through a function from 36 sites let Vivado merge the reads onto shared ports:
    the netlist returned zeros for every edge (gate-level replay, 37 of 40 blocks
    wrong) while every simulation passed. Fuzz unchanged.
2026-10-11 runner: WAVES=vcd records a VCD trace
    The FST tracer of the apt Verilator aborts on the bigger blocks and the
    toolchain's needs lz4 headers the Pi lacks; VCD needs neither.
2026-10-11 runner: WAVE_DEPTH limits the trace to the top's ports; dec_top and tile_syntax replay testbenches
2026-10-11 ITX_LANES: the transform lane count as a dec_top/recon_top parameter; run.sh -g NAME=VAL
    Measured on the K26 build: 4 lanes 94.7k LUT / 416 DSP, 2 lanes 57.9k / 224,
    1 lane 40.8k / 128; decode cycles (dec_top_small) +2.6% at 2 lanes, +8.3% at
    1. The default stays 4; the board build passes -g ITX_LANES=2.
2026-10-11 mv_mem: the written bitmap as row-word LUT RAM; mode-info and entry stores as UltraRAM / block RAM
    At the 1024x512 build the decoder grew by 68k LUTs over the 256x256 one,
    mostly here: the per-row 'written' bitmap of the motion-vector store was a
    flop array scaling with the frame width (16k flops), its entry store was
    mapped to 42 single-bit block RAMs, and the mode-info transform-size stores
    fell to LUT RAM. The bitmap is now 64 row words in distributed RAM with one
    write port (a row clear writes zeros, a bit set writes the asynchronously read
    word with the bit merged, so both land in the same cycle as before); the big
    stores ask for UltraRAM, the 5-bit ones for block RAM. Unit tests unchan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
2026-10-11 cdef: filter taps from a 5x9 neighbourhood with per-direction constant offsets
    The per-sample filter read its 13 taps straight from the 12x12 window at
    direction-dependent positions: four lanes of 144-way muxes, 19.7k LUTs of
    write-data path. The neighbourhood of the four samples (rows pi..pi+4,
    columns pj..pj+8) is selected once per group; each tap then reads it at an
    offset that is a constant in every arm of a case on the direction, an 8-way
    mux. Combinational only, cycle-exact; cdef unit test unchanged.
2026-10-11 rec_fifo queues as LUT RAM; coef_rd nonzero bitmap as row-valid flops plus row words in LUT RAM
    The reconstruction FIFO's record queues were struct-typed arrays, which no RAM
    template matches: 14k flops and a 4k-LUT read mux. They are flat vectors in
    distributed RAM now, written from their own processes, cast to the record on
    read. The coefficient reader's nonzero map was 8 slots x 1024 flops with per-bit
    writes and a random read (15.6k LUTs); it is now 32 row-valid flops per slot
    and 32-bit row words in distributed RAM (a set merges the bit into the row
    word read asynchronously and writes it back the same cycle; a read ANDs the
    row-valid bit with the word bit). Same cycles; unit tests uncha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
2026-10-12 lr_top: the self-guided A/B arithmetic as a five-stage pipeline
    The box sums, a_r*n - d_r^2, p*s, the a2 ROM and the two b2 multiplies were
    one combinational cone from the pixel window to the A/B line RAM: 93 logic
    levels, 30 ns, the decoder's worst path by a factor of two. Five registered
    stages now carry each position (index, row, pass, last-of-row) and the writes
    land five clocks later; a drain state before the blend keeps the ordering.
    Loop-restoration and decoder unit tests unchanged.
2026-10-12 lr_top: box sums as registered row partials (six-stage A/B pipeline)
    The 25-term square-and-add tree was the next worst path (14 ns). Each of the
    five window rows is summed combinationally, registered, and the five row sums
    are added in the following stage. Unit tests unchanged.
2026-10-12 cdef: best direction and variance registered (third search stage)
2026-10-12 blk_ctx: context aggregates registered as the above word lands
    The max level, nonzero and dc-sign aggregates over the block's above and left
    entries were computed in T_OUT from the registered above word together with
    the context compare chain: 44 LUT levels, tile_syntax's worst path. They are
    now computed from the RAM output as it lands (T_RD2) and the left word read
    the cycle before, registered, and T_OUT derives the contexts from the
    registers. Same cycles; tile_syntax and decoder unit tests unchanged.
2026-10-12 ipred: filter-intra taps summed as a balanced tree
    The seven tap products of each filter-intra output were accumulated in
    sequence, which Vivado built as a seven-deep DSP cascade into fi_buf: the
    block's worst path (-6.1 ns at 100 MHz). The products are now summed as a
    balanced tree. Same cycles; ipred and decoder unit tests unchanged.
2026-10-12 ipred: filter-intra patches in two cycles
    Summed as a balanced tree the seven tap products were still a six-deep DSP
    cascade into fi_buf (-7.1 ns at 100 MHz): Vivado chains the adders through
    the DSP post-adders whatever the expression's shape. Each filter-intra patch
    now takes two cycles: S_PIX forms the 56 products (buffer read, tap mux, one
    multiply) into registers, and the new S_FI2 sums, rounds and clips them,
    stores the patch and emits its top row. Odd rows read back as before. One
    extra cycle per 4x2 patch on filter-intra blocks only; ipred and decoder
    unit tests pass.
2026-10-12 ipred: DC prediction divides by w+h with a shift and a reciprocal multiply
    The both-edges DC value (sum + (w+h)/2) / (w+h) was a general 20-bit
    division by one of twelve sizes: 41 CARRY8 levels, the block's worst path
    after the filter-intra split (-4.5 ns at 100 MHz). With m = min(w, h) the
    divisor is m * {2, 3, 5}, so the quotient is the sum shifted by log2 m and
    then divided by 2, 3 or 5 as a multiply by a scaled reciprocal, exact over
    the whole 15-bit input range (checked exhaustively). Same cycles.
2026-10-12 ipred: pixel lanes in two stages
    Each lane's pixel was formed in one cycle: edge-RAM read, mode mux, the
    smooth or directional products, their sums, round and clip, straight into
    out_pix4, a four-deep DSP cascade and the block's worst path (-3.6 ns at
    100 MHz). The lane datapath is now two stages: S_PIX fetches the values and
    forms the products (pred_prep) into registers, and a second stage sums,
    rounds and selects (pred_fin) into the output register. Filter-intra rows
    pass through the same stage as ready pixels. Outputs land one cycle later,
    and a new S_DRAIN state lets the last one out before done, which recon_top
    gates the writes on. One cycle more per block.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
2026-10-12 mv_mem: the area-fill pauses while the clear engine holds the bitmap's write port
    Since f70860c the written bitmap is 64 row words in distributed RAM with
    one write port, muxed clear-first. The comment claimed the clear engine and
    the area-fill never overlap; they do (busy covers both, and a clear can be
    posted while a fill is stepping), and for the cycles a clear ran the fill's
    bits were dropped. Four tall Argon streams (test10440, test10482,
    test10434_6644, test10484) failed in luma from mid-frame on; bisected to
    f70860c. The fill now pauses while a clear runs (entry store and bitmap
    alike), so every bit lands. Unit tests unchanged.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
2026-10-12 lf_top: the filter decision a cycle ahead of the filters
    Each column's samples were muxed, the decision taken (hev, masks, filter
    mode) and the narrow filter's clamp chain run into colout in one cycle, the
    block's worst path (-2.6 ns at 100 MHz). The decision is now taken on the
    next column's samples (column 0 as L_S_CALC is entered, cc+1 while it runs;
    the single column of a vertical edge throughout) and registered with the
    samples; the filters work from the registers. Same cycles; lf_top and
    decoder unit tests unchanged.
2026-10-12 blk_ctx: context aggregates as balanced trees over masked entries
    The max level, nonzero and dc-sign aggregates were loops carrying a running
    value over the 16 entries of each word: a 16-deep compare chain behind the
    level RAM output, 38 LUT levels and tile_syntax's worst path (-2.9 ns at
    100 MHz). The entry masks (which entries belong to the block) depend only on
    the request and are now registered in T_RD, a cycle before the word lands;
    the aggregates are a balanced max tree, an OR and two population counts
    over the masked entries. Same cycles; the 4-bit biased dc-sign sum, unused,
    is gone.
2026-10-12 gen_replay: the X-masked compare honours the strobe gates too
    The RTL control (xmask=1) compared every output bit, masking only X, while
    the netlist compare applied the --gate strobes. Outputs that are don't-care
    while idle passed the RTL control only when they happened to be X; lf_top's
    registered samples made its idle write data definite and the control
    reported 2494 mismatches in gated-off fields while the netlist replay was
    bit-exact. The generator now emits a gmask over the gated outputs and
    applies it in the X-masked compare as well. replay_lf_top regenerated
    (fb_we: fb_wdata,fb_plane,fb_x,fb_y; fb_re: fb_plane,fb_x,fb_y; fb4_we:
    fb4_x,fb4_y,fb4_wdata); the other harnesses are unchange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
2026-10-12 sr_top: the per-plane step and initial subpel from a sequential divider
    stepX = (down << 14 + up/2) / up and the truncating initialSubpelX
    quotient were two combinational 32-bit divisions feeding the plane setup
    registers: 132 logic levels, the decoder's worst path (-19.5 ns at 100 MHz).
    They now share one restoring divider, a quotient bit per cycle (S_DIV, 32
    cycles each), followed by two cycles for the error term and the subpel.
    About 68 cycles more per plane, once per frame.
2026-10-12 recon_top: dequantisation in two stages
    The effective quantiser (the qm multiply), the coefficient multiply, the
    shift, the clamp and the itx bank write all sat in the one cycle after the
    Quant and qm reads: two chained DSP multiplies into the bank RAM, the
    decoder's worst path once the other blocks met 100 MHz (-3.8 ns). Stage 1
    now registers the effective quantiser with the coefficient and its
    position; stage 2 multiplies, shifts, clamps and writes. The previously
    unused R_ITX_START state lets the last coefficient land before the
    transform starts: one cycle more per transform block.
2026-10-12 lf_top: the narrow filter's first half in the decision stage
    The hev-gated difference and the 3*(q0-p0) clamp chain are formed from the
    next column's samples alongside the decision and registered; the filter
    cycle keeps filter1/2 and the four outputs. Same cycles; lf_top and decoder
    unit tests unchanged. (Seven clamp steps in one cycle were the block's last
    path over 10 ns, -1.7 ns.)
2026-10-12 gen_replay: --maxv vector capacity (default 800k); dec_top harness to 800k
    A multi-frame whole-decoder recording (seeds 2-8 through loop restoration)
    is 679k cycles; the old 400k cap would have silently truncated the replay.
2026-10-12 gen_replay: +maxerr=N plusarg for the MISMATCH print limit (default 100000)
2026-10-13 tb/gate/models: versioned gate-replay driver + frame-memory sim wrappers
    The flat funcsim instantiates the black-boxed frame memory by Vivado's
    per-parameterisation names with no overrides; each name needs a wrapper
    with that instance's parameters. Found via the first loop-filter replay.
2026-10-13 cdef: direction-search squares in a registered DSP stage (C_DIR_B2)
    The 120 squares of the partial sums were LUT multipliers (~14k LUT cells
    with the cost sums). They now land in sq_r with use_dsp, one extra cycle
    per luma 8x8 block (+0.36 % cdef cycles on seeds 2-8).
2026-10-13 itx2d: transpose-memory rotations as explicit log rotators
    Indexed lookups rotated by s synthesised to 64 independent 64:1 muxes per
    bit on both the read and the write side. Six 2:1 stages do the same.
2026-10-13 itx2d: one shared round2v/clamp datapath for the row and column store states
2026-10-13 itx_lvl: level-folded 1D inverse transform engine (32 fixed pair units, one spec level per clock)
    Generated by tools/gen_itx_lvl.py from tb/itx_model.py: the DCT/ADST pair ops scheduled ASAP into levels
    (DCT4 2 .. DCT64 10, ADST8 5, ADST16 7), small sizes packed 64/N rows per vector, input permutations folded
    into the level-0 sources, the ADST output permutation and negation as the output map. No indexed register
    file: unit inputs and write-back are fixed per (program, level), fan-in <= 14. --check simulates the
    tables against the model; tb/test_itx_lvl.py fuzzes the RTL (1400 packed vectors, all programs).
2026-10-13 itx2d: 2D wrapper around the level engine (itx_lvl) with row packing; itx_row for ADST4/identity/WHT
    Rows of a group shift into the engine vector one per clock, the engine runs one spec level per clock,
    results shift out one row per clock (top slot first, rows stored in reverse order). Zero row groups
    (rows >= 32) store directly; the non-network transforms stream through itx_row. Transpose memory and
    ports unchanged. tb: ITX2D_SIZES/ITX2D_TYPES filters and a mismatch row/column histogram; dec_top builds
    the new engine instead of itx1d. itx2d fuzz: 114 + 380 blocks over 19 sizes match the model.
2026-10-13 itx2d: streamed rows (ADST4/identity/WHT) as a 3-stage pipeline, one row per clock
    The combinational read -> prescale -> itx_row -> register path was the critical path at -3.2 ns; now row
    ri is read into ld_row, transformed into st_row the next cycle and written the cycle after, overlapped.
    Latched classes declared with the other latched parameters; itx_row takes 32 lanes.
2026-10-14 synth/vivado: implementation trial flow — null stubs (-n), frame-memory stand-in (-f pr), impl.sh/impl.tcl (opt, place, phys_opt, route, reports)
2026-10-14 docs: frame memory for the FPGA builds (on-chip URAM version for the core build; DDR version outline)
2026-10-14 docs/frame-memory: one double-pumped URAM copy (two copies at 512x512 are 48 URAM, over budget)
2026-10-14 frame_mem_uram: on-chip double-pumped UltraRAM frame memory for the core build (2 read + 2 write ports + host)
    One URAM copy at 2x the decoder clock: both reads on the mid-cycle clk2x edge (one per RAM port, the host taking
    read-port 1's slot when idle), both writes on the clk-aligned edge from captured requests. One-cycle latency,
    a write visible from the next cycle, same-cycle read-before-write exact: the frame_mem model's contract. Words
    are four 18-bit lanes (URAM byte-pair enables = lane enables). tb/test_frame_mem_uram.py fuzzes it against a
    Python picture (40k reads); synth.tcl constrains a clk2x port at 5 ns. Design: docs/frame-memory.md.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
2026-10-14 synth/vivado/run.sh: frame_mem_uram in the source list
2026-10-14 frame_mem_uram: read-first UltraRAM template (one block per port, 9-bit byte enables), read data captured at the clk-aligned clk2x edge
2026-10-14 frame_mem_uram: no-change write mode with byte enables (Vivado rejected read-first + byte enables for UltraRAM); synth: clk2x constraint via SYNTH_CLK2X
2026-10-14 frame_mem_uram: URAM288 via xpm_memory_tdpram (byte enables) under SYNTHESIS, behavioural model for simulation; 16-bit lanes
    Vivado infers UltraRAM only for full-word no-change writes (probed: read-first and per-byte enables are both
    'invalid write mode'); the primitive has 8-bit byte-write enables, so the XPM macro instantiates it. Lanes
    are two bytes (sample in the low 12 bits), byte 8 unused. The gate-level replay checks the two models agree.
2026-10-14 docs/frame-memory: implemented numbers (24 URAM, 5.4 ns half-cycle) and the XPM/inference note
2026-10-14 dec_top: FRAME_URAM parameter (fb0 on the double-pumped UltraRAM, fb1/fb2 left out) with clk2x/phase ports; tests drive the 2x clock; replay harness generates it
    tb/runner.py builds the variant with FRAME_URAM=1 (build/dec_top*_uram); tools/gen_replay.py --gen2x/--genphase
    keep the generated clocks out of the vectors; tb/gate/models/gate_block.sh elaborates the netlist with -L xpm.
    Verilator, FRAME_URAM=1: seed 1 and seeds 2-8 at stage lf match the model with unchanged cycle counts.
2026-10-14 frame_mem_uram: reads on the clk-aligned 2x edge, writes mid-cycle; multicycle constraints clk <-> clk2x
    The model samples a request at the clk edge that ends its cycle, so the reads belong there (not half a cycle
    earlier): every decoder-side path becomes a full clk cycle, read data is the URAM output register itself, and
    the write requests captured at that edge land mid-cycle before the next reads. The first implemented core build
    showed the half-cycle version at -7.4 ns on clk -> clk2x. Fuzz and the FRAME_URAM dec_top sims unchanged.
2026-10-14 gate_block.sh: never elaborate the funcsim with -L xpm (UltraRAM reads simulate as zeros with it)
    Bisected on a directed write/read test: the same flattened netlist reads back correctly with unisims_ver +
    secureip only. Reverts the flag added for the XPM frame memory; the memory's block replay and the whole-decoder
    replays run clean without it.
2026-10-14 synth/impl: HD.CLK_SRC for clk2x in implementation; fast->slow multicycle with -start (launch at the clk-aligned clk2x edge)
    The first implementation of the double-pumped core build had every clk2x -> clk path failing by 13 ns and the
    clk paths at -15 ns: an unanchored clk2x port and the destination-period form of the multicycle.
2026-10-14 impl: URAM -> clk2x paths are a full clk cycle (multicycle 2 once the primitives exist); frame-memory note updated; block replay harness tracked
2026-10-14 dec_host: AXI4-Lite host interface around dec_top (headers, CDF defaults, tile-byte FIFO, stage starts, status, pixel read-back) + cocotb test through the register map with a replayable transcript
2026-10-14 fpga/kv260: Verilog shells for the module-reference flow (SystemVerilog is refused as a reference top)
2026-10-14 frame_mem_uram: header comment matches the schedule (reads + write capture on the clk-aligned edge)
2026-10-14 fpga/kv260: frame-memory multicycle covers the XPM's column-select registers
2026-10-14 docs: KV260 bring-up status (first frames decoded bit-exact on the board) and the two board lessons
2026-10-14 docs: natural streams decoded bit-exact on the board
2026-10-14 host_regs: the host protocol without cocotb (register map, header packing, HostDecoder); tools/kv260/decode.py decodes a stream on the board
    The header field tables and packing (hdr_t / rec_hdr_t / lf_hdr_t) move out of the cocotb tests into
    tb/host_regs.py, which the tests import back, and HostDecoder drives a frame through the register file
    synchronously: headers, CDF default rows, tile bytes with the FIFO's free count, end of stream, done polls,
    loop filter, picture read-back. tools/kv260/decode.py runs it over /dev/mem on the KV260: an .ivf in, the
    shown frames out as a dav1d-layout .yuv, optionally compared against dav1d's output. No transcript, no model
    on the board.
2026-10-14 dec_host: packed picture read-back (HDATA2 / HDATA4 with the address advancing itself, a four-sample prefetch behind HADDR)
    An HADDR write fetches the four samples at x .. x+3 into a buffer (each address held HL = 3 cycles, which
    covers both frame memories' one-cycle host port); a data read before they are in waits on the AXI read
    channel. HDATA still returns sample x and leaves the address, so recorded transcripts replay unchanged;
    HDATA2 returns two 16-bit lanes and advances by 2, HDATA4 the low bytes of four samples (8-bit pictures) and
    advances by 4. Read-back was 94 % of a frame's time on the board (three bus transfers per sample from the PS);
    this makes it one transfer per two or four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
2026-10-14 docs/kv260-bringup: the direct decode path, the packed reads and the 120-frame clip numbers
2026-10-14 kv260 driver: the CDF default rows built and marshalled once per base_q_idx, the picture buffer through memoryview (list() on a ctypes array cost 100 ms a plane)
2026-10-14 kv260 decode.py: the reference compare took the per-sample path on every row (precedence)
2026-10-14 README: board numbers (18 fps end to end on the 120-frame clip, ~0.8 M cycles a frame)
2026-10-14 Picture DMA: dec_host writes the decoded frame into DDR (AXI4 write master), 4-lane host read on the frame memories
    h_rdata4 on frame_mem / frame_mem_uram / dec_top (the four samples of the addressed x-group), so the engine
    reads four samples a clock. The engine (registers 0x180..0x1BC: format, plane bases / strides / sizes, start,
    status) walks each plane row by row, packs eight 8-bit or four 16-bit samples a 64-bit beat, strobes the row
    tail, and issues INCR bursts of up to 16 beats that stop at 4 KB boundaries; it owns the frame memory's host
    port while busy (register pixel reads wait). Block design: S_AXI_HP0_FPD at 128 bits behind a second
    smartconnect, DDR low + high mapped. Test: tb/a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
2026-10-14 kv260 decode.py --dma / --show: the picture through the DMA engine into the framebuffer's spare lines, and onto the screen (C YUV 4:2:0 -> RGB565 blit)
2026-10-14 dec_host: the DMA plane registers start at 0x190 (word group index 1), the decode read them one group early; the DMA test clears the memory model before each run
2026-10-14 host_regs.unpack_dma: 16-bit samples through array.array (the per-sample Python loop cost 0.2 s a frame)
2026-10-14 hostlib: the screen blit copies rows out of the uncached staging and into the framebuffer with wide accesses (byte-wise device-memory access cost 50 ms a frame)
2026-10-14 docs/kv260-bringup: the picture DMA path and its numbers
2026-10-14 Pipelined frames through the host interface: HostDecoder / decode.py --pipe and TS_PIPE=1 in test_dec_host run the deblocking filter under the frame sequencer, overlapped with the tiles; nightly dec_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
2026-10-14 decode.py: with --dma and no output or reference the picture stays in memory (no per-frame unpack into Python lists)
2026-10-14 msac in two stages: the symbol in the accept cycle, renormalisation / bit consumption / CDF adaptation the cycle after
    The symbol sequencer already takes two cycles per symbol (go, request), so splitting the decoder costs no
    throughput: resp_sym still arrives one cycle after the request, the adapted row (resp_cdf / resp_cnt /
    resp_rng, resp_wb_valid) two cycles after, and a request is accepted every other cycle at most. The
    sequencer writes the row back a cycle later than before and forwards it to its own re-read of that row;
    cdf_store forwards a write-back announced for the next cycle (wb_pre) to any requester; the two tops route
    the write-back by whoever has one, since the request's owner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
2026-10-14 msac: the two range boundaries picked in stage 2 from the registered candidates (the 16:1 mux leaves the compare chain); cdf_store in block RAM (a third of the UltraRAM clock-to-out at the head of th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
2026-10-14 recon_top: the written group's frame address registered a cycle ahead (flip arithmetic + block offset off the UltraRAM address path); frame_mem_uram: CASCADE_HEIGHT 4 (seven cascade hops on every rea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
2026-10-14 recon_top: the write address is registered where the add stage sets its position (R_ADD), not in the dequant loop
2026-10-14 docs/FUTURE: the msac symbol loop is done (two stages), the early-read idea kept for a one-symbol-per-cycle decoder
2026-10-14 docs: 80 MHz on the board (86 fps), the hand-instantiated MMCM and why
2026-10-15 Window frame memory: FRAME_WIN superblock rows in UltraRAM, rows flushed to DDR as they become final (design in docs/frame-memory.md)
    frame_mem_uram: FRAME_WIN > 0 addresses lines by superblock row modulo FRAME_WIN (64-line luma rows, 32-line
    4:2:0 chroma rows). dec_top: row_final pulses (LF(r) done makes row r-1 final, the last pass releases the last
    row), flush_done counts, a hold on the superblock hand-off into reconstruction until the slot's previous
    occupant is flushed, the window build's limits on the unsupported flag (sb128, non-4:2:0, intra block copy,
    non-pipelined frames), frame_done after every release. dec_host: DMA_CFG bit 8 auto-flush queues released
    rows and writes each row's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
2026-10-15 dec_top: a superblock held by the window still ends the previous row's count once reconstruction is idle (the hold waited for a flush that waited for a filter that waited for that count)
2026-10-15 dec_top: window builds narrow the motion-info store to 32 4x4 rows and the filters' per-4x4 store to 64 (rings by row truncation)
2026-10-15 test_dec_host: per-plane byte accounting when a DMA image is short
2026-10-15 test_dec_host: the DMA status and beat count in the short-image message
2026-10-15 dec_top: simulation-only window trace
2026-10-15 frame memory host port: h_ok (the read was served); the DMA engine refetches a group the UltraRAM did not serve (a window flush runs alongside the filter, which owns that slot)
2026-10-15 test_dec_host: progress logging around the frame start
2026-10-15 window build: one tile column (a tile column spans every row), the limits sticky in hardware and checked by the driver; the test skips streams outside them
2026-10-15 docs/frame-memory: the window's tile-column limit, the served flag, the held-row count, the 1080p numbers
2026-10-15 test_dec_host: on a window mismatch, read the samples back from the window through the registers
2026-10-15 decode.py --dma-base / --dma-size: a reserved physical region as the DMA target for full-size pictures
2026-10-15 msac: simulation-only end-of-stream trace
2026-10-15 Host push loops budget pushes, not bytes: a tile's tail bytes go through DATA1 one word each (the Python loops counted a 3-byte tail as one word and lost the last byte into a full FIFO; the C helper 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
2026-10-17 synth/vivado/run.sh: -t dec_host compiles the host interface around the decoder (for the window-config netlist replay: only dec_host's DMA engine can drive flush_done)
2026-10-17 kv260/build.tcl: the K26 DDR geometry on the PS (4 GB), so the block design has the HP0_DDR_HIGH segment and the picture DMA above 4 GB reaches memory
    The IP default models 2 GB of DDR and offers no high segment: the first 1080p run on the board (2026-10-17) wrote its picture through a 40-bit address that the interconnect had no segment for, and read back the stale bytes already in DDR. Geometry per the kv260_som 1.4 board preset.
2026-10-17 docs: 1080p bit-exact on the KV260 through the reserved-region DMA target; the PS DDR geometry lesson
2026-10-17 vcd2vec: a VCD identifier can stand for several names (Verilator merges equal nets: the AXI channels' constant size / burst / prot ports); every name takes the value
    The dec_host FRAME_WIN=3 replay compared the recorded awsize / awburst as 0 against the netlist's 3 / 1 on every write address: the converter kept only the last name of each shared identifier, so m_axi_awsize (same identifier as m_axi_arsize) never received its value.
2026-10-17 kv260 decode.py --show from the reserved-region DMA target too: the picture is blitted from wherever it was staged onto fb0 (FbStage's show had been displaced into MemStage, where it returned False)
2026-10-17 kv260 decode.py --flip: the screen blit turned by 180 degrees for a panel mounted upside down (the console gets fbcon=rotate:2)
2026-10-17 test_dec_host: window mode skips CDEF / loop-restoration streams like the board build refuses them (a recording with those blocks busy does not replay on the stubbed netlist)
2026-10-17 docs: the 80 MHz window build closes timing under ExtraTimingOpt and runs 1080p bit-exact on the board
2026-10-18 Timing at 80 MHz: shallow window address, block-constant edge limits registered, two-cycle palette sort
    The 80 MHz 1080p window build misses timing by 1.03 ns with Vivado's default strategy (ExtraTimingOpt closes it with 38 ps
    to spare). The worst path ran from recon_top's transform-size register through the availability flags and the edge-gather
    limit clamps into the frame memory, whose window-line modulo and plane arithmetic were synthesised as a divider and adders
    in front of the UltraRAM address (39 logic levels).
    - frame_mem_uram: the window line is a table over the superblock row, and line * words-per-row + x / 4 is a concatenation
    (only the plane base is added, with zero low bits).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
2026-10-18 ipred: edge-filter / upsample read addresses from a lookahead register
    The intra edge filter and the edge upsampler read the LUT-RAM edge banks at positions derived from the step counter
    and the pass size with clamps, computed in front of the RAM address every cycle; with the filter arithmetic and the
    write-request mux behind the read, that was one 26-level path (-0.56 ns at 80 MHz, 70 % routing, 2026-10-17). The six
    indices the next cycle reads are now computed where the sequencer sets the next k / pass size (ef_la / up_la, the same
    clamps), into a register the read-address block takes in S_EF / S_UP_A / S_UP_L, as the pixel loop already does. Same
    addresses every cycle, so the same pixels;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
2026-10-19 ipred and recon_top: the edge-bank writes and the residual-add writes land one cycle after they are computed
    With the read addresses registered, the 80 MHz build's worst paths were still the intra predictor's read-modify-write of the
    edge banks (k -> clamps and selects -> LUT-RAM read -> filter arithmetic -> request mux -> the replicated banks, -1.09 ns,
    two thirds routing), then reconstruction's residual add (transform-engine residual read -> add -> clamp -> frame-memory
    write-port mux and capture, 0.00 ns). Both end in a memory write, so both are cut the same way: the resolved write is
    registered and issued the next cycle.
    - ipred: the per-bank write enables, addresses and data are regist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
2026-10-19 docs: the 80 MHz timing pass (window address, edge limits, palette sort, edge-bank and residual-add writes); the default strategy closes, 1080p bit-exact on the board
2026-10-19 kv260 decode.py: frames per second in the summary line
2026-10-19 obu_parser: inter frame headers (5.9.2 inter branch, set_frame_refs, frame_size_with_refs, skip mode, global motion, load_previous, 7.20 / 7.21 slot state)
    The parser stopped at inter frame headers. It now reads the reference list (explicit or via the set frame refs process), the
    frame size from a reference, interpolation filter, motion mode switch, use_ref_frame_mvs, order hints and sign biases; the
    frame reference mode, skip mode params, allow_warped_motion and the global motion parameters (sub-exponential coding against
    the previous frame's parameters); and segmentation params in their inter form. Each decoded frame updates the slots it
    refreshes with the header-level state of 7.20 (sizes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
2026-10-19 Inter frame headers checked against dav1d: the trace's H event carries the inter fields, xcheck_hdr compares them
    tools/dav1d_trace_patch.py appends 79 values to the H event (order hint, refresh flags, error resilient, force_integer_mv,
    show / showable, high-precision MVs, interpolation filter, motion mode switch, use_ref_frame_mvs, reference_select, skip
    mode allowed / present / frames, allow_warped_motion, ref_frame_idx[7], the references' order hints, global motion type and
    parameters per reference); tb/tile_model.FrameHeader reads them when present (older traces still load), and no longer
    refuses inter frames at the header level (the tile decoder keeps its intra-only guard). tools/xcheck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
2026-10-19 Tile model: inter frame syntax (5.11.7-5.11.33), the full MV stack (7.10.2 with global, temporal and compound candidates), and a frame-sequence state
    tb/tile_model.py decodes inter frames: inter_frame_mode_info with the inter segment id, skip mode, is_inter, intra blocks
    of inter frames (y_mode), read_ref_frames with the reference contexts of 8.3.2, compound / new / zero / ref / drl modes,
    assign_mv for every mode, inter-intra, motion mode (overlappable candidates, warp samples, is_scaled), compound type and
    the switchable interpolation filter. find_mv_stack gains the global motion candidates, the temporal scan over the motion
    field, compound search and extra search, and clamps both lists. A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
2026-10-19 seq_model: a frame that does not update the segmentation map stores the previous map verbatim; tile_model: segment prediction contexts sized past the frame edge
    Found on Argon test10147 by the dequantisation oracle: an intra block of an inter frame took its quantiser from a segment
    feature, and its segment id was predicted from the previous frame's map. The spec's decode frame wrapup (7.4) sets
    SegmentIds equal to PrevSegmentIds when segmentation_enabled = 1 and segmentation_update_map = 0; the model had stored the
    per-block minima the blocks used, which differ wherever a block covered mixed ids. dav1d keeps the previous map the same
    way. Also: AboveSegPredContext / LeftSegPredContext are wr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
2026-10-19 Reconstruction model: inter prediction (7.11.3) with references from a frame store; the frame check runs the sequence
    tb/recon_model.py predicts inter blocks from the reference frame store: motion vector scaling against the reference's
    size, the 8-tap block prediction, local and global warp (warp estimation from the syntax's warp samples, setup shear,
    resolve divisor, block warp), compound averaging, distance weights, wedge / difference-weight / inter-intra masks and
    the mask blend, overlapped motion compensation, and the inter-intra intra prediction. compute_prediction follows 5.11.34
    for inter and inter-intra blocks.
    tools/xcheck_frame.py decodes the frames in order with tb/seq_model.py's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
2026-10-19 lf_model: inter blocks (reference and mode deltas, isIntra from the block's reference); xcheck_frame merges RefFrames; --blocks report
    The deblocking filter's level takes the block's reference frame and mode deltas (7.14.4: modeType 1 for inter modes other
    than the global ones) and skips the internal transform edges of skipped inter blocks (7.14.2 isIntra). The frame state now
    carries RefFrames per 4x4. With this, Argon test10001 (7 decoded frames, compound, OBMC) and test10046 decode identical
    to dav1d's pictures through the whole Python pipeline (syntax, motion compensation, deblocking, CDEF, loop restoration).
    --blocks prints the blocks that hold differing samples with their inter syntax.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
2026-10-19 xcheck_tile: the trace is read one frame at a time (a whole large Argon stream parsed into Python lists took 15 GB)
2026-10-19 xcheck_tile: a decoded tile is reduced to what the sequence state needs (a frame of 100+ tiles held as decoders took tens of GB)
2026-10-19 CDF store: the inter tables mapped after the intra rows (1501 rows), and a host read-back of the working store
    cdf_map.INTER_TABLES / TABLES; every intra address is unchanged. DEF_ADDR bit 31 reads a row of the tile's adapted
    CDFs back into DEF_DATA (between tiles; reads wait for the row). The host test checks the rows after a decoded
    tile against the model's CDFs, counters included; host_regs.read_cdf_rows for the board.
2026-10-19 ihdr_t: the inter frame header record (skip mode, MV precision, filters, order hints, sign bias, scaled refs, global motion, segment ref features) on a 64-word host window at 0x200
    Plumbed dec_host -> dec_top -> tile_syntax -> blk_syntax -> mv_stack, unused yet; zero for intra frames. host_regs
    IHDR_FIELDS / ihdr_vals(th) pack it from the parsed header; the testbenches drive it.
2026-10-19 mv_ent_t v2: the motion entry carries the inter fields (two references and MVs, mode family bits, skip mode, compound indices, filters, segment prediction); intra frames fill the intra values
    85 bits (was 42): mv_mem in the 1080p window build goes from 4 to 8 UltraRAMs. MVs stored as 16 bits (conformance
    bounds them below 1 << 14); the stack sign-extends.
2026-10-19 mv_stack: find_mv_stack for inter frames (global, spatial, temporal and compound candidates, extra search, NewMv / RefMv / ZeroMv / Drl contexts); mf_band motion field memory; fuzz vs the model
    Single or compound reference, GLOBALMV substitution, the sorts and the clamping as before; intra block copy keeps its
    PredMv path. tb/test_mv_stack.py: random partitions decoded in order on synthetic frames with a random motion
    field, 60 seeds / 1,701 inter blocks identical to tile_model.find_mv_stack (incl. the extra search, 128x128
    superblocks, sub-tiles, odd frame sizes). tile_syntax instantiates mf_band (host-written; dec_top ties it off).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
2026-10-19 blk_syntax: the inter block syntax (5.11.7 - 5.11.33): segment id with the previous map, skip mode, is_inter, reference frames, modes, DRL, MVs with fraction and precision bits, inter-intra, motion m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
    Contexts from the two neighbours' motion entries (mv_mem), the previous segmentation map from a seg_band memory,
    the stack's outputs for the mode contexts and the predicted MVs. The block record and the motion entry carry the
    inter fields (ymode widened to 5 bits; recon_top keys the block copy on intrabc). Intra frames decode as before
    (tile_syntax plain / screen, nightly inter-c on atium green so far).
    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
2026-10-19 test_tile_syntax: the frame sequence (seq_model) drives inter streams: inherited CDFs, the previous segmentation map and the motion field are loaded into the DUT's band memories per frame
    tile_syntax's band defaults cover whole frames in simulation (dec_top sizes the board's).
2026-10-19 Inter syntax fixes from the first Argon runs: DRL only for NEWMV / NEW_NEWMV, the neighbour reads wait for the motion entry write, the model records the optional inter fields; loop restoration unit s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
    test10046 / test10001 / test10041 (8 inter frames, 1,288 inter blocks, compound, OBMC, LR units) are record- and
    symbol-exact through tile_syntax.
2026-10-19 dec_host: host registers for the inter frame bands (motion field entries, previous segmentation map words) through dec_top; host_regs helpers
2026-10-19 docs: inter frame syntax in RTL (stage 1); README progress entry
2026-10-19 test_tile_syntax: the frame's saved CDFs read back through the rb port after the context-update tile equal the model's
2026-10-19 runner: tile_syntax simulations get whole-frame inter bands by default (a 4352-px-tall Argon frame aliased its segmentation map)
2026-10-19 mv_stack: no bit-select on a function result (Vivado Synth 8-12513); blk_syntax: intra block copy records BILINEAR filters
2026-10-19 coef_rd: the DC category comes from the level before the 20-bit mask (spec 5.11.39; Argon test10075 lossless 64x64, golomb value 2^20); blk_syntax: block record reset to zero; testbench probe TS_DBG_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
    The DC-category bug predates the inter work (reproduces on main); found by running Argon streams the RTL had never seen.
2026-10-19 xcheck_tile / xcheck_frame / seq_model: the giant Argon streams no longer need tens of GB
    xcheck_tile indexes the trace (byte spans of each tile's D sections) and reads a tile's events lazily while the
    model decodes it; a 10-million-line Argon frame held as Python lists was the 30 GB. TileSummary keeps only the
    tile's own window (end_frame indexes it with the offsets); xcheck_frame merges each tile into the frame state as
    it finishes and drops the decoder (a 1,456-tile frame held as decoders was the picture batch's OOM).
    Checked: test10046/test10041 syntax and test10046 pictures identical to before; RTL tile_syntax on test10046 PASS;
    intra traces unchanged.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
2026-10-19 seq_model: the frame-level state shares tuples (motion field holes, zero MVs) and shown-key-frame slots
    A 16K x 16K Argon frame has 16M 4x4 cells; per-cell [0, 0] lists in the stored motion vectors and per-cell
    [MV_INVALID, MV_INVALID] lists in the 8-reference motion field were gigabytes per frame, and show_existing deep-copied
    the frame arrays into all 8 slots. Slots are never mutated after end_frame builds them, so they are shared.
    Checked: test10147 (temporal MV candidates, 246 tiles), test10041, test10046 syntax exact; test10046 pictures OK;
    RTL tile_syntax on test10046 PASS.
2026-10-19 tile_model: a frame's tiles share one set of per-4x4 frame arrays (FrameCtx.arena)
    Every TileDecoder allocated 25 frame-sized arrays; a 2,200-tile Argon frame allocated and freed them 2,200 times
    (hours, and 20-30 GB of allocator churn). Tiles only touch their own region (is_inside / availability stop at tile
    edges; the above contexts are per tile), so one set per frame is exact. Symbol-exact on test10046 / 10041 / 10147 /
    10075 and the intra traces; test10046 pictures OK; RTL tile_syntax on test10046 PASS.
2026-10-19 mc_filt: the motion compensation filter (7.11.3.4, unscaled) with the AVERAGE / DISTANCE blend; fuzz vs the model
    Stage 2a, first block: a patch of clamped reference samples (written by ref_fetch, or the testbench) -> horizontal
    8-tap pass into a 16-bit strip -> vertical 8-tap pass, four output columns per clock, InterRound0 / 1 per bit depth
    and compound; list 0 of a compound block parks in a prediction buffer and list 1 blends (average or distance
    weights) as it emerges. Subpel_Filters as a generated package (tools/gen_mc_tables.py). tb/test_mc_filt.py drives
    recon_model.block_inter_prediction on random pictures with units crossing every edge, all filters and phases,
    2 .. 64 wide and high,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
2026-10-19 ref_fetch: the reference region of a prediction unit from DDR (AXI4 read master) into mc_filt's patch buffer
    Stage 2a, second block: per patch row the clamped column range is read as 8-byte INCR bursts (<= 16 beats, never
    across 4 KB; one byte or 16-bit LE per sample as the DMA flush writes them) into a line buffer, then the patch
    words are written with every lane's column clamped (7.11.3.4 edge replication); rows outside the picture read the
    nearest row again. tb/test_ref_fetch.py: random pictures in the AXI memory model (read channels with random
    stalls), 40-bit addresses, units crossing every edge, both formats: 150 units, 25k patch words exact.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
2026-10-19 recon_model: the frame store dict is self.fstore; self.frame stays the FrameCtx
    FrameRecon overwrote TileDecoder's self.frame (the FrameCtx) with the frame store dict, so TileSummary.frame was
    the dict and seq_model.end_frame failed on prev_segment_ids for frames that inherit a segmentation map
    ('dict' object has no attribute 'prev_segment_ids'): 40 of 67 picture checks on atium. test10041 pictures OK.
2026-10-19 recon_top: inter blocks predicted whole by ref_fetch + mc_filt (stage 2a); the slot table and AXI read channels through dec_top / dec_host
    The block FSM's B_MC_* states follow the intra-block-copy pattern: per plane, per prediction unit (the block, or
    the per-luma-4x4 chroma units from blk_rec_t.cmv), per 64x64 strip, per list: ref_fetch brings the clamped
    reference region into mc_filt's patch, mc_filt filters (list 1 blends with the parked list 0: AVERAGE, or
    DISTANCE with the 7.11.3.15 weights computed from the order hints), and the output goes to the frame memory
    through the 4-wide write port with lane enables (2-wide chroma units); the transform flow then adds residuals.
    Features beyond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
2026-10-19 tools/gen_y4m_motion.py: a panned multi-frame y4m from a single-frame one (inter test sources for aomenc)
2026-10-19 inter_scan: scaled references detected from the reference sizes (test7565 / 8064 / 8181 use them; test10046 is the one stage-2a-clean Argon stream)
2026-10-19 blk_syntax: the OBMC overlap neighbours in the block record (blk_rec_t.obmc), stage 2b.1 syntax side
    For an OBMC block the syntax stage walks overlapped_motion_compensation's candidates (above: x4 from MiCol in steps
    of the candidate's clipped width at (MiRow - 1, x4 | 1), the first min(4, log2 w4) inter ones; left likewise) and
    publishes each one's offset, step, reference, MV and filters, so reconstruction's overlap predictions need no mv_mem
    port. Model: tile_model.obmc_neighbours; test_tile_syntax compares the packed field. test10001 (823 inter blocks,
    32 OBMC) exact.
2026-10-19 streams/inter: stage-2a inter test streams (aomenc, features restricted, dav1d-exact in the model); nightly dec_inter suites
    inter2a (2 frames, single reference), inter2b (8 frames, 243 inter blocks), inter2c (4 compound AVERAGE blocks),
    inter2d (828 inter blocks, 102 sub-8x8 chroma units, 6 compound) from tools/gen_y4m_motion.py sources, and
    inter_obmc (71 OBMC blocks, for stage 2b.1). tools/nightly.sh: dec_inter (the four 2a streams through dec_top vs
    the model, references from the model's pictures) and dec_inter_argon (test10046). inter2a / 2c / test10046
    identical today; 2b at 7 of 8 frames when committed.
2026-10-19 mc_filt: mode 4 'pair' emits the two unblended 16-bit predictions for the masked blends of stage 2b; fuzzed (120 units incl. 23 pairs)
2026-10-19 ref_fetch: keep the 16-bit sample select in range for the unrolled lanes 4..7 (Vivado Synth 8-524; behaviour unchanged, fuzz 150 units PASS)
2026-10-19 recon_top: stage 2b inter prediction — OBMC (neighbour predictions blended into the frame memory by a read-modify-write pass with Obmc_Mask), masked compound (wedge from the master ROM, DIFFWTD from 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
    Verified bit-exact through dec_top (TS_STAGE=recon, references = model pictures): inter_obmc (71 OBMC blocks), inter_mask (1 DIFFWTD), inter_mask2 (9 wedge), inter_ii (8 inter-intra), 8 frames each; streams added to the nightly dec_inter suite.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
2026-10-19 Scaled references (stage 2c.1): mc_filt takes startX/startY fractions and xStep/yStep (per-lane positions and filter phases in the horizontal pass, 8 strip reads per output row in the vertical pass w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
    mc_filt fuzz: 520 units (210 scaled, steps 64..2048) exact vs recon_model.block_inter_prediction; OOC synth 7,490 LUT / 73 DSP, WNS +0.96 ns. Streams inter_scaled / inter_scaled2 (aomenc --resize-mode 1 / 2) are dav1d-ex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
2026-10-19 warp_setup: warp_estimation + setup_shear (7.11.3.6-8) as a sequential unit (shared multiplier, ~18 cycles) from the syntax-stage least-squares sums or the global parameters; Warped_Filters and Div_L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
2026-10-19 mc_filt: warp mode (7.11.3.5 block_warp, one 8x8 per run): the unscaled address streams with Warped_Filters taps per lane and row from (sx4, alpha, beta) / (sy4, gamma, delta); fuzz vs recon_model.bl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
2026-10-19 blk_syntax: the least-squares sums of the warp samples (7.11.3.8) accumulated during the find_warp_samples scan into blk_rec_t.ls (LOCALWARP blocks; 8-sample cutoff, threshold validity, the first sca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
2026-10-19 recon_top: warped motion (stage 2c.2): warp_setup per block and list (LOCALWARP from the record's sums, GLOBALMV-family from gm_params), units with a warping list predicted in 8 x 8 strips with the a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
2026-10-19 FrameState callers follow the incremental API of e218ff6 (dec_host suites, cdef/lf/lr tests, decode.py, model_stages.py: the 2b nightly's three dec_host FAILs); TD_MCTRACE: matching MC traces in test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
2026-10-19 recon_top: an OBMC neighbour unit runs all its strips before the next neighbour (in frames with scaled references the 8 x 64 / 64 x 32 neighbour units span two 32-strips; the second was skipped, leav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
2026-10-20 tools: xcheck_mvstack.py compares the model's MV stack with dav1d's per block (new trace bit 16 'M' event at the end of refmvs_find, added to the dav1d trace patch); first use pins test7773's extra d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
2026-10-20 seq_model: a KEY_FRAME source exits the motion field projection with 0 (7.9.2), as INTRA_ONLY does; refStamp was being consumed by key-frame references and LAST2 never projected (the 3 Argon MV-stack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
2026-10-20 Trace tooling: dav1d's last_active_segid = -1 maps to the spec's LastActiveSegId 0 (the trace-driven checkers produced segment ids of -1 on frames without active segments: test2776_9777 symbol-exact 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
2026-10-20 test_dec_inter: the stored reference width follows the stage's pictures (FrameWidth at recon, UpscaledWidth at lr): super-res streams no longer index past the pre-upscale reference (test7043 identica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
2026-10-20 Loop filter: reference and mode deltas for inter blocks (7.14.4); inter test applies super-resolution at the lr stage
    lf_top only ever applied loop_filter_ref_deltas[INTRA_FRAME]: an inter frame with
    loop_filter_delta_enabled and non-default deltas got the wrong level on every inter
    block (Argon test11 frame 4: ref_deltas [-16,0,-64,0,-1,-20,59,31], mode_deltas
    [-35,0], base level 4: the RTL left the edges at x=184/376/464 unfiltered). The
    corpus runs at the recon stage and the generated inter streams keep the default
    deltas, so nothing had exercised it.
    - mi_lf_t carries ref0 (RefFrame[0]) and mode_type (inter modes other than
    GLOBALMV / GLOBAL_GLOBALMV); recon_top fills them from the blo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
2026-10-20 tb/gate/models: frame_mem_sim regenerated from the current frame memory (h_rdata4 / h_ok host ports from 78993ab were missing: a plain-frame-memory whole-decoder replay would have left h_rdata4 uncon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
2026-10-20 tb/gate/models: frame_mem_sim: the +fminit block after the N declaration (xvlog: identifier used before its declaration)
2026-10-20 tb/gate/models: frame_mem_sim: the +fminit block after the array declarations (xvlog declaration order)
2026-10-20 lf_top: transform edges inside a skipped inter block are not deblocked (7.14.2)
    apply_filter carried "|| 1'b1" for isIntra from the intra-only days, so every
    transform edge of a skipped inter block was filtered. Found by the first Argon
    batch run through the whole pipeline (150 small inter streams at TS_STAGE=lr:
    11 mismatched by a few LSBs on one inter frame each; test47 frame 9, test6491
    frame 4, ...). isIntra is now ref0 == INTRA_FRAME from the per-4x4 info added
    with the inter deltas. test47 identical through lr (10 frames).
2026-10-20 INTER build-time switch: the intra-only decoder for the K26 (board build follows main again)
    INTER = 0 (dec_host / dec_top / tile_syntax / blk_syntax / recon_top) leaves out
    ref_fetch, mc_filt and warp_setup (generate-ifs with tie-offs), never dispatches an
    inter block (recon_top blk_inter) and never parses an inter frame (blk_syntax
    inter_frm), so synthesis trims the inter paths. Default 1 everywhere; tb/runner.py
    takes INTER from the environment.
    fpga/kv260: the RTL list is synth/vivado/run.sh's again (it had stopped at the
    pre-inter files: mc_tables_pkg missing, sym_path missing) and build.tcl sets
    CONFIG.INTER from KV260_INTER (default 0: the board is intra-only, main's inter RTL
    is 1.3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
2026-10-20 nightly: dec_top_intra0 suite (the INTER=0 intra-only build on the generated frames)
2026-10-20 tb/gate/models/gate_block.sh: the netlist replay runs with +fminit=zero (xsim starts the frame memories X, Verilator 0: every host read of an untouched pixel mismatched, 2026-10-20)
2026-10-21 dav1d trace: I events (inter prediction of a block after MC / warp / blend, before the residual; mask bit 1<<5): a per-block inter oracle, used to arbitrate test10310 frame 2 (model = dav1d, RTL wron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
2026-10-21 recon_top: the scaled-path strip offset is 8 px when the unit's other list warps (GLOBAL_GLOBALMV compounds of a global warp and a translation in a frame with a scaled reference read 32 px too far fr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
    B_MC_STRIP2's general (scaled) branch offset the strip by mc_sc << 5 / mc_sr << 5 steps, but a unit whose other list
    warps is predicted in 8 x 8 strips (unit_warp, ss = 3), so the translational list of such a compound read 32 px too far
    from the second strip on: the first 8 columns right, the rest wrong. In a frame with any scaled reference every
    translational list takes this branch, scaled or not. Shift by (unit_warp ? 3 : 5), like B_MC_STRIP's px / py.
    Found on Argon te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
2026-10-22 tb: reference slots get 512 MB planes (test10505: luma rows 1024+ were aliased by the chroma plane), mismatch dump + mc_case tools
    test_dec_inter's reference store gave each plane a 16 MB window; an 8192 x 1088 10-bit luma plane is 17 MB, so
    load_slot's chroma write overran luma rows 1024 and up and the RTL read chroma for every block whose reference
    window reached row 1024 (test10505 frame 1: 18% of the picture wrong, filed as an RTL +-1 bug on 2026-10-21).
    PLANE_STRIDE is now 512 MB (fb14x14 at 16 bits), SLOT_STRIDE three planes, and load_slot asserts the fit.
    Also: TS_DUMP writes the rtl/model planes of a mismatching frame before the assert (test_dec_top), RF_FAR fuzzes
    ref_fetch windows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
2026-10-22 INTER=0 compiles the inter paths out structurally: K26 window build 119,312 -> 109,861 LUT
    The INTER switch (65a7181) left the inter FSM states in place: a constant-false dispatch does not make a
    state unreachable to synthesis. Now:
    - blk_syntax: the 79 inter-frame states (S_NBA ..) live in their own case under
    `if (INTER != 0 && int'(st) >= int'(S_NBA))`, in both the main FSM and the symbol-request block; the
    seven states the intra block copy path shares (S_NBW, S_MVFR*, S_MVHP*) move ahead of S_NBA in the enum;
    nb_rd gated.
    - mv_stack: INTER parameter; at 0 the block is intra-block-copy only (no compound lists, global motion,
    temporal candidates, extra search or contexts), cycle be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
2026-10-23 Alveo U200 host path: XDMA + DDR4 block design around dec_host, host driver --xdma backend
    fpga/u200/build.sh + build.tcl: a block design for xcu200 (board part xilinx.com:au200:part0:1.3 from AMD's
    au200 board files, not in the Vivado store) with XDMA Gen3 x16 (512-bit AXI at 250 MHz, AXI-Lite BAR0 to the
    register file), one DDR4 bank (board preset, ECC; its control port is a second register target at 0x1_0000),
    the KV260's hand-instantiated 2:1 MMCM fed from the controller's 100 MHz user clock (VCO capped at 1550 MHz:
    that clock is really 100.04 MHz), a JTAG-to-AXI master for driver-less bring-up, smartconnects for the width
    and clock conversions; sys.xdc with the U200 configuration settin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
2026-10-23 docs: throughput budget from the lr-stage Argon census (3.69 c/px total, tile 2.87, LF 0.80; 1080p60 at 200 MHz = 1.6 c/px per stage)
2026-10-24 picture memory step A: fb1 / fb2 UltraRAM rings, fb0 mirror + SR ring, per-buffer holds, inter through dec_host
    dec_top: FRAME_WIN1 / FRAME_WIN2 put the CDEF and LR frames on UltraRAM rings (docs/picture-memory.md); the
    RING build (FRAME_URAM with FRAME_WIN1 >= 0) runs CDEF / super-res / LR under the frame sequencer with the
    final picture flushed row by row. Port budget: a double-pumped UltraRAM serves 2 reads + 2 writes and the
    stages never stall, so fb0 (recon + LF) gets a mirror ring fb0m written alongside it and read by CDEF and
    SR / LR source 0, and SR writes its upscaled deblocked rows into fb0s (final_buf 3 when nothing follows);
    the first ring simulation flushed an all-zero picture b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
2026-10-24 ring build: MI store sized from FRAME_WIN, inter bands full-height; decode.py --inter
    The per-4x4 filter state (CDEF indices, LR units) is a ring of 2^ML2R MI rows; the window build sized it at
    64 rows (4 superblock rows), one short of a 5-row fb0 ring: reconstruction of row 4 overwrote row 0's LR units
    while LR was reading them (seed 28 at 128x320, test47 frame 1). ML2R = clog2(FRAME_WIN * 16) now; the
    motion-field / segmentation bands (the previous frame's whole picture, written by the host) are full-height
    whenever inter is built. tools/kv260/decode.py --inter / --pool drive HostDecoder.decode_frames_inter on the
    board (frame-buffer pool in the DMA region, --show follows the frame's targe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
2026-10-24 test_dec_host_inter: on a mismatch, counts per (plane, superblock row) and line, and every frame buffer's samples
2026-10-24 dec_top: frame_done waits for every row release in all builds; test_dec_host_inter: per-frame header line, model pre-filter / deblocked values at mismatches
2026-10-24 dec_host / dec_top: declarations ahead of their uses (Vivado 8-6901 / 8-8895: ref_slot_r was an implicit 1-bit wire at the dec_top instance); u200 build waits for the module runs before implementatio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
2026-10-24 dec_host: START.tile empties the tile byte FIFO (multi-tile frames decoded the previous tile's tail)
    The FIFO was cleared only by CTRL.rst. The arithmetic decoder leaves a tile's trailing bytes unread, so the next
    tile of the same frame started on them: test47 frame 1 (three tile rows) decoded its third tile from the second
    one's tail, intra and inter blocks alike, and the deblocking of that row then found nothing to filter. Every
    stream through dec_host before today had one tile per frame (the board's included). Software pushes a tile's
    bytes after its START, so the pulse can empty the FIFO. test47 frames 0-2 (1 / 3 / 2 tiles, inter) now identical
    through the RING build. test_dec_host_inter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
2026-10-24 test_dec_top: idle watchdog 2M cycles (TD_IDLE_LIMIT), MC / fetch / AXI state in the hang report
    test20017 (profile 1, 4:4:4 10-bit) frame 35 is one 128x128 compound block with scaled references: 96 strip
    fetches of 57-row patches on three full-resolution planes, ~500k cycles before the first tx record is taken,
    which the 300k-cycle per-block watchdog called a hang. Decodes identical with the limit raised.
2026-10-24 cdef_top / lr_top: registered write ports, done and busy one cycle later
    The CDEF filter output (window registers -> direction / strengths -> out4) and LR's Wiener / self-guided output
    went combinationally into the frame memory's write capture: 50-65 logic levels, -8.4 ns at 100 MHz in the U200
    inter build (both blocks were null stubs on the K26 and had never met a timing tool). The write request is now
    registered at the port, done and busy follow a cycle later so a consumer starting on done reads landed data.
    Bit-exact on the CDEF and LR unit tests (natural streams and seeds), dec_top lr-stage and pipelined seeds, the
    ring seeds through dec_host and test6641 through the inter host path.
    Co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
2026-10-24 blk_syntax: tx-type CDF row address a cycle ahead; mi_store: cdef index write pipelined
    Two of the U200 inter build's 100 MHz violators (2026-10-24). The tx-type CDF row (set selection, Tx_Size_Sqr,
    row arithmetic from p_txsz and intra_dir) was computed in the request cycle and ran 25 logic levels into the CDF
    store's forwarding compare (-4.8 ns); p_txsz is set three states before S_TXTYPE, so the address is registered
    ahead. mi_store's cdef_arr took the header's sb128 fan-out, the +1 adders and a 4-lane enable decode over
    2^(ML2R+ML2C-8) entries in one cycle (35 levels, -4.5 ns); the request is registered and written the next cycle
    (CDEF reads a unit a superblock row later). Bit-exact: tile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
2026-10-24 warp_setup: registered 64x32 multiplier with a wait cycle per product, divide split, centre products in their own cycle
    The shared 64x64 multiplier's product, Round2Signed and the clamp sat in one cycle (55 logic levels through 25
    CARRY8 and the DSP cascade, -5.1 ns at 100 MHz in the U200 inter build, 2026-10-24). The multiplier is 64x32
    now (every second operand is a 32-bit sum, divFactor, a parameter or a LUT factor; the low 64 bits are what the
    wide version kept), its product is registered and each consuming state waits one cycle for it; W_DIV only forms
    the determinant and W_DIVR resolves the divisor; the block centre's four products are registered in W_Q5 and
    summed / clamped in W_V. Wa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
2026-10-25 dec_top: drop the "CDEF / LR without fb1 / fb2 -> unsupported" flag; the ring-depth rule only in pipelined mode
    The flag (added this morning) fired on host-driven frames of the core UltraRAM build whose headers enable CDEF
    but whose host never starts it: the nightly's dec_host_core suite stalled on seed 2 (the decoder stopped, the
    host waited forever for FIFO space). A core build asked for CDEF / LR is the host software's business
    (HostDecoder.check_core_build). The fb0 ring depth rule (3 + CDEF + LR rows) stays, gated on pipe_en, the only
    mode in which the sequencer would deadlock. Verified: seed 2 through dec_top, the nightly's dec_host_core /
    dec_host_pipe / dec_host_dma suites, the ring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
2026-10-25 tb: motion-field loaders write (MiRows >> 1) x (MiCols >> 1) entries; MV-stack traces (TD_MVTRACE, MV_TRACE), weights in the MC trace
    The harness and the board driver wrote one row and one column past the field; in a build whose band is exactly the
    frame's height (41x1020 at fb10x10: MiRows 256, MFL2R 7) the extra row aliased onto row 0 and erased the top row's
    temporal candidates (test1861 frame 7: three 8x4 NEWMV blocks with the wrong base MV).
2026-10-25 ihdr_t.order_hint_bits: 4 bits (OrderHintBits is 1 .. 8); pack() rejects values that do not fit their field
    With OrderHintBits = 8 the 3-bit field read 0 in the RTL. blk_syntax's rel_dist_abs survived by accident (0 - 1 wrapped to 7
    in 3 bits), recon_top's rel_dist did not (1 << -1 = 0: no wrap), so the compound distance weights came out swapped on
    streams with 8 order-hint bits (test13842 frame 11, profile 2: Fwd/Bck 7/9 instead of 9/7). The host driver packed the
    value with a silent mask; it now asserts.
2026-10-25 tb: the TD_MCTRACE launch trace as a function (test_dec_inter.mc_trace); test_dec_host_inter uses it on u_dec.u_rc
2026-10-25 test_dec_host_inter: a model-only reference is loaded at the referencing slot's own address, bookkept per slot (not cached in the entry shared by every slot the frame refreshed); both inter harnesses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
    test10316_84 frame 12 through dec_host: the key frame's entry (slots 0-7) had its address cached as slot 0's when frame 10
    referenced it; frame 11 (model-only) was then loaded into slot 0, and frame 12's refs 5 and 6 (still the key frame's
    entry) read frame 11's picture: every reference read of the frame went to slot 0. A harness bug; dec_top decodes the
    stream bit-exact, and the RTL reads exactly the addresses the slot table gives it (TD_ARTRACE).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
2026-10-25 cdef_top / lr_top: pipelined filter datapaths (100 MHz on the U200)
    cdef_top: the filter is four stages: A the group's neighbourhood and the block's constrain shifts, B the taps by
    direction with their differences and min / max, C constrain times tap weight, D sum / round / clamp into the port
    register; a group lands at t + 4 (was t + 1), done and busy follow the last write.
    lr_top: the three output kinds share a three-stage pipeline: P1 Wiener horizontal filters / self-guided 3x3 sums /
    copy samples with the unit's coefficients and the group's address, P2 Wiener vertical MAC and self-guided F, P3 round /
    clamp / blend into the port register; a group lands at t + 3.
    The one-cycle functions w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
2026-10-25 cdef_top / lr_top: one more pipeline split each (post-synth at 100 MHz: CDEF -3.2 ns on the direction mux + min/max, LR -1.9 ns on a seven-deep DSP cascade)
    cdef_top: stage B selects the taps only; C constrains and weights them and takes the min / max; D forms three partial
    sums; E sums, rounds and clamps into the port register (a group lands at t + 5).
    lr_top: the Wiener horizontal and vertical MACs are two partial DSP cascades each (taps 0-3 / 4-6, rows 0-3 / 4-6)
    with a sum stage after (S1 .. S4, then the combinational round / clamp / blend; a group lands at t + 5).
    Verified bit-exact: cdef unit (seeds + natural streams), lr unit (natural + seeds), dec_top lr seeds, dec_host RING
    seeds 7/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
2026-10-25 cdef_top: the min / max of the taps as balanced trees (the sequential if-chain synthesised twelve deep: -4.6 ns at 100 MHz post-synth)
    Stage B registers each tap masked for the trees (0 / 4095 when absent); stage C takes max13 / min13 over the 12 taps and
    the centre in four compare levels. Verified bit-exact: cdef unit (seeds + natural), dec_top lr seeds, dec_host RING seeds
    7/8, test47 inter through dec_top at lr.
2026-10-26 Timing round 1 at 100 MHz: registered stages on the 2,089 routed violators' main groups
    From the ring100-88753d5 routed checkpoint (U200, 100 MHz: WNS -1.43 ns, 2,089 failing endpoints) each violator group
    was traced with report_timing and cut where the evidence pointed, every change bit-exact on the unit, dec_top, dec_host
    and Argon suites:
    - itx_lvl (gen_itx_lvl.py): the per-level control word (unit source codes, rotation constants, mode / flip, per-lane
    write-back codes) is decoded for the next level and registered; the datapath of a level no longer contains the
    (program, level) decode (843 paths, 19-20 levels from the wrapper's size / class registers). prog and r must be
    stable th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
2026-10-27 Hardware-vs-twin debug hooks: ILA capture + cycle log diff, register transcripts, random reset, paced host
    Built while chasing the U200 "flat frame" of 2026-10-26/27 (which turned out to be dav1d references made with
    film grain on; the decoder and Argon's md5_no_film_grain are grain-free). The hooks stay:
    - tb/test_dec_host_inter.py TS_ILA_LOG=<file>: the ila-u200 debug build's probe set (residual pipeline, record
    pops, coefficient writes, start pulses) sampled every clk from the first record pop for TS_ILA_N cycles,
    struct fields unpacked; tools/ila_diff.py diffs a card capture (fpga/u200/ila_capture.sh + .tcl, hw_server
    over JTAG, trigger / capture conditions from the environment) ag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
2026-10-27 host_regs: window_ok refuses pictures wider than 1 << FBX or taller than 1 << FBY (the geometry from identify()); the U200 sweep had tried 3096-4040 wide Argon frames on the 2048-wide image
2026-10-27 Inter driver: frames the image cannot take are decoded by the model and uploaded as references (model_only), so the card decodes every in-limit frame of a stream; tools/kv260/decode.py reports them a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
2026-10-27 SB128 window builds: 128x128 superblocks through the window frame memory (WIP)
    frame_mem_uram gets SB128 (slot pitch 128 luma / 64 chroma lines, FRAME_WIN * 128 lines of words) and the stream's
    sb128 flag; dec_top SB128 deepens the mode-info rings by a bit (tile_syntax ML2R/MFL2R/SPL2R, recon_top ML2R,
    mi_store FRAME_WIN * 32 rows) and win_unsup no longer refuses sb128; dec_host CFG bit 1 reports it; dec_host_v,
    the U200 build (U200_SB128=1), tb/runner.py (SB128=1), the driver (window_ok sb128 from identify()) and the twin
    tests follow.
2026-10-27 docs/frame-memory.md: the SB128 window
2026-10-27 Tile engines (phase 1 of tile columns): TE tile_syntax engines with their own queues, feeds and CDF stores behind one reconstruction, events in raster order per superblock row (rtl/tile_engines.sv); 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
2026-10-27 frame_mem_uram: the UltraRAMs instantiated directly (no XPM): per-URAM enable decode and an output mux whose select is loaded at E_b only, so nothing on the read path launches at the write edge and t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
2026-10-27 dec_top: the window's LR accounting in superblock rows for sb128 (stripes are 64 lines: rows wholly final after lr_next stripes, the last row a stripe touches for the fb2 hold; sb64 unchanged); the t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
2026-10-27 tile_engines: +vis arbiter trace
2026-10-27 tiles debug: unconditional arbiter trace, host-side run_tile_row logging, 4 ms tile-row poll
2026-10-28 frame_mem_uram: read data captured at E_a (the URAMs' DOUT is disturbed by a write on the same port: the own-URAM 50 MHz image still decoded wrongly, fewer samples); the clk2x -> clk multicycle excep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
2026-10-28 tiles debug: arbiter trace to a flushed file, host logs before FIFO status reads
2026-10-28 phase_gen: the phase flag from clk sampled on the falling clk2x edge (race-free alignment with a quarter period of margin) instead of a clk2x toggle aligned by a clk-domain reset race that Vivado's r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
2026-10-28 Inter driver: a model-decoded picture bigger than a pool buffer stays on the host (mem=None) and a frame naming such a reference goes model-only too; decode.py prints the reason. 43 Argon streams wit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
2026-10-28 dec_top: a superblock row counts as decoded once the merged reconstruction stream passed it (row_cnt != 0), not once per tile column: the tile engines merge all columns of a tile row into one raster 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
2026-10-28 Twin debug hooks: dec_top heartbeat (sequencer state every 2^18 cycles while a frame is active) and the twin logs how long the model's filters took, since simulated time stands still while Python fil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
2026-10-28 Tile engines: reconstruction gets the tile column bounds of the engine it is serving (hdr_rc.mi_col_start/end from tile_engines), not the header's first column: with two columns every neighbour-avail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
2026-10-28 tile_engines: arbiter heartbeat in te_trace.txt every 2^18 cycles (the single-engine multi-row path on TE=2 stalls after the first superblock row: test7870_10283 frame 12)
2026-10-28 tile_engines: the arbiter no longer waits for the engine's queued transform count to reach zero before switching: that count includes the next row's already-parsed transforms, so every single-engine 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
2026-10-28 Twin traces: recon_top logs the tile bounds it holds at every superblock start; tile_engines logs the header's row/column bounds and the engine columns at tile_start (second tile rows of two-column f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
2026-10-28 Tile-row feeding (twin + driver): the control word reused for engine selects had the previous tile row's EOS bit in it, so engines of the second and later tile rows of a two-column frame saw end-of-s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
2026-10-28 Twin tile-row done poll: 2M reads 256 cycles apart (the 40000-read debug limit, 7.6 ms of simulated time, failed test7402 frame 16, an 84x776 LR-heavy frame still reconstructing)
2026-10-28 Inter driver: a model-decoded picture whose planes do not fit the pool buffer stays on the host instead of aborting the stream (test10573_11003 frame 3: the DMA layout said it fit, the model planes d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
2026-10-28 Two-engine tile pushes: budget FIFO words, not bytes (twin + driver slow path): a 2-3 byte tail into one free word overflowed the engine FIFO and lost the tile end (test5413 frame 0, 189x750 sb128, 2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
2026-10-28 Two engines: a held palette block is released by its own engine (queue drained, reconstruction idle), not by the engine-blind queue-drained test, which also held while the head was a next-row superbl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
2026-10-28 Twin: a differing flush dumps the pictures (flush, model final / pre-filter / deblocked, cropped) to TS_TEST_DIR/mismatch_<tag>.json for a look offline (the per-buffer "fbN holds" readback means noth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
2026-10-28 docs: intra block copy on the window build, the design (MC path with the current picture as the reference, ring + DDR patch loaders, no new flush granularity)
2026-10-28 Intra block copy on the window build: through the MC path (BILINEAR, single list, the current picture's flush layout as the reference via cur_planes from dec_host's DMA registers), the patch filled b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
2026-10-29 dec_top: a row is decoded once every tile column passed it again (row_cnt >= n_tile_cols), a pass of the merged reconstruction stream counting for the engines of the tile row (n_pass = popcount(eng_m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
2026-10-29 dec_host: end of stream per engine (CTRL bit 8 ends the stream of the engine CTRL[27:24] selects; CFG bit 2 says so), the twin and the driver sending it with each engine's last bytes: one global EOS 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
2026-10-29 dec_top: the simulation-only window trace moved to the end of the module (it read lf_pend and the sequencer's state before their declarations; xvlog refuses that, Vivado never saw it)
2026-10-29 dec_host: the per-engine EOS select reads the merged CTRL word from a wire (ctrl_nx) instead of a part-select on the strb() call: Vivado refuses a select on a function call (Synth 8-12513), the te2j 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
2026-10-29 dec_host: the per-engine FIFO free counts in a packed array: the gate replay of the two-engine netlist (te2a at 5a51e90, te2b at f3ea1b4) returned engine 0's free count on the 0x074 read of engine 1 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
2026-10-30 dec_host: begin/end around the per-engine FIFO read loop: e5e0086's for-if swallowed the following 'else case', so every other register read (ID, STATUS, ...) assigned nothing and the twin failed at 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
2026-10-30 docs/code-tour.md: the data flow from stream file to pictures, with file and line anchors (for a first read of the code; written 2026-10-30)
2026-10-30 docs/frame-state.md: census of the frame-to-frame state the host still carries for inter streams (CDFs, segment map, motion field) and the design that moves it onto the card: sideband + CDF areas per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
2026-10-30 frame state, stage A (docs/frame-state.md): rtl/frame_state_w.sv captures the 7.19 motion-field words (one per 8x8) and the segment ids (one byte per 4x4) of each superblock row from the popped block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
2026-10-30 frame_state_w in every source list (runner, synth, U200 and KV260 builds)
2026-10-30 card-state host path (docs/frame-state.md stage A): seq_model.CardSequenceState keeps the slots from the card's sideband words and read-back CDF rows and projects the motion field itself; HostDecoder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
2026-10-30 frame_state_w: buffer lines are the 4x4 / 8x8 line within the superblock row, not the frame row modulo the buffer (odd rows of 64-pixel superblocks landed in the upper half of the buffer the DMA neve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
2026-10-30 sideband DMA: the burst length is latched a state before awvalid (awlen was computed in the same cycle the address handshake sampled it: a 32-beat awlen on a 24-beat burst, the first row never comple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
2026-10-30 card-state projection in numpy (seq_model._project_np, raster-order last-writer-wins): tools/fstate_selftest.py checks it against the scalar spec code on random slots (30 frames, 161,518 cells identi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
2026-10-31 frame_state_w: 7.19 saves the LAST qualifying list (a compound block with both references in the past saves list 1): twin run 2 caught 64 cells of a 64x64 compound block saved from list 0
2026-10-31 frame state, stage B (docs/frame-state.md): rtl/fs_load.sv loads the segment map and the CDF rows (counter zeroed) from the reference slot's areas in DDR into the bands at a frame start (START bit 6,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
2026-10-31 stage B twin mode (TS_FSTATE_B=1): the card loads the primary slot's segment map and CDF rows (START_LOAD, zero map when the model uses none) and saves the context engine's rows after its tile row (S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
2026-10-31 docs/frame-state.md: stage B as built + the projection engine's design (register table, job, cost, verification)
2026-10-31 twin B mode: loaded_cdf initialised before the frame branch
2026-10-31 twin B mode: the rows / cdf_area decision after the loader has run (it was computed before the frame branch)
2026-10-31 decode.py: --pool defaults to 10 (8 reference slots + the frame being decoded need at least 9 buffers)
2026-10-31 decode.py --card-state prints where the card put each frame's state; tools/kv260/peek_state.py draws a frame's saved motion field read back from the card's DDR
2026-10-31 tools/kv260/show_stream.py: the frame headers of a stream as the host parses them (for the walkthrough)
2026-10-31 fs_load: the burst length settles a state before arvalid (the loader hung on its first DDR read, FS_STATUS 0x44, the same awlen race the sideband DMA had); twin B: a slot whose frame ended with disab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
2026-10-31 decode.py: pictures are output in display order (a coded frame shown twice or shown later through show_existing_frame is written where it is displayed; the reference comparison happens per display); 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
2026-10-31 stage B, the projection engine: rtl/mf_project.sv fills the motion-field band from the reference slots' saved MV words (7.9: posValid, mv_projection with the Div_Mult ROM, block_position, seven desti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
2026-10-31 host_regs card-state: a frame that updates its CDFs at the end but whose context tile rows were never read back now raises instead of silently storing the starting/default rows (audit 3, 2026-10-30);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
2026-10-31 mf_project: the destination phase counter reaches 8 (3-bit d compared against 7 + 1, which wrapped to 0: a cell that projected never left the destination loop, P_DRAIN waited forever and the host saw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
2026-10-31 stage B host path: decode.py --card-load (docs/frame-state.md section 5): the card loads the segment map and CDF rows from its own areas, saves the context tile's rows (fs_layout's new CDF area behin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
2026-10-31 ipred: the idle-time port (edge writes and start) is registered on entry, one cycle late together, so the half-clk path from the double-pumped frame memory (frame_mem_uram a_q_r, captured at the mid-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
2026-10-31 recon_top: an intra block copy whose patch starts above the picture keeps every row in the frame buffer when nothing is flushed (yb == 0: the whole-picture build, or the first FRAME_WIN superblock ro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
2026-11-01 frame memory: two-cycle read. The double-pumped UltraRAM memory read at the clk-aligned clk2x edge and a fabric register captured the data mid-cycle, leaving half a clk cycle for the output mux over 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
2026-11-01 recon_top: every reference fetch request starts with the whole patch from ref_fetch (rf_r_lo / rf_r_hi / ff_r_lo / ff_r_hi = 0 in B_MC_STRIP, the intra block copy split overriding): the four were ass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
2026-11-01 gen_replay: a 2x-clock harness refuses a recorded phase
    With --gen2x but no --genphase, a block with a phase input had its phase recorded from the twin VCD, sampled once per
    clk cycle: a constant 0. frame_mem_uram captures its read only when phase is 1, so every frame-memory read under the
    netlist came back zero and five replays on 2026-11-01 (the fm2 shards and the test5439 FB11 replay) failed in frame 0
    with zero pixels in the filter write-back, while the card decoded the same frames identically. The last passing replay
    (fs2b, 10-31) had --genphase. Now gen_replay exits with the reason; --recorded-phase overrides on purpose.
2026-11-01 Stage B host path: a buffer holding a live slot's state areas is not free
    7.20 passes the primary slot's segment map and CDF rows on to a frame that kept them, so a slot can name areas inside
    another frame's buffer. The flush target only avoided buffers whose picture a slot held: test5439 frame 8 took frame
    0's buffer and saved its CDF rows and segment ids over the areas slots 0-6 still pointed at, and frame 9 loaded frame
    8's state for a reference that carried frame 0's (1,604 samples off by one, card-load mode only; stage A re-sends the
    state from the host and never saw it). test5416 frames 5-9 were the same aliasing. Now every buffer that holds a live
    slot's seg / cdf / mv area counts as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
2026-11-02 Host paths: a segment map kept verbatim is the primary slot's only at the same dimensions
    load_previous_segment_ids (7.20) gives a frame zeros when its primary reference had other dimensions, so a frame
    that keeps its map verbatim (segmentation_enabled, segmentation_update_map = 0) keeps zeros then, not the
    reference's map. Both host paths passed the reference's map on regardless: stage A (seq_model.end_frame_card)
    stored a map of another frame's size under this frame's mi_rows / mi_cols, and a later frame of this size passed
    start_frame's geometry check and seg_map_seq indexed past it (IndexError, test6562_1344_5677, which changes size
    every few frames); stage B (host_regs end_frame_load) r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
2026-11-02 Host: pictures read back as raw rows. unpack_dma turned every DMA picture into Python lists of ints (and write_planes / compare turned them back): on the U200 host that was ~30 ms a 1080p frame, ten 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
2026-11-02 tools/kv260 -> tools/host: the host driver (decode.py, host_regs' register traffic through hostlib, xdma.py, play.py, show_stream.py, peek_state.py) runs the Alveo U200 as much as the KV260, so the d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
2026-11-02 Twin: the host's frame-buffer pool and recycling rule, in simulation. decode_frames_inter chose the flush target by a rule the simulation twin never ran (tb/test_dec_host_inter.py flushed every frame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
2026-11-02 Gate rung: the simulator is a switch. tools/gate_block.sh (from ~/gate on atium, now in the repo) replays a recording against the funcsim netlist under SIM=xsim (as before: unisims_ver / secureip, ho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
2026-11-02 docs/reference-prefetch.md: the inter decoder's wall is DDR latency per patch row, measured, and the fix in steps. ref_fetch reads a prediction unit's patch one row per AXI read with nothing in fligh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
2026-11-03 docs/reference-prefetch.md: frames 2 and 3 measured, 48 and 50 cycles per reference read (frame 1 re-read the same way: 48). The 1080p twin ran frames 2-3 of in_to_tree-aom.ivf (stage B off, frames 0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
2026-11-03 Update README with project goals and current status
    Expanded project details, current status, and future goals for the openav1 hardware decoder.
2026-11-03 ref_fetch: pipelined rows (docs/reference-prefetch.md step A). An address side issues a row's bursts as soon as one of RING=4 line buffers is free, a data side takes the in-order responses into that 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
2026-11-03 gate_block.sh (SIM=verilator): the build flavour follows the recording length. Measured on dec_host 2026-11-03 (100k-cycle m2d replay, xsim 51 min): g++ -O0 single thread 29 min (build 35 min); -O2 2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
2026-11-03 frame_mem_uram (synthesis branch): per-UltraRAM phase copies and request muxes. The U200 image of the pipelined ref_fetch missed timing by -0.981 ns on phase -> LUT3 -> URAM288 ADDR/EN pins (97 % wir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
2026-11-03 recon_top / mc_filt: block-ahead fetch (docs/reference-prefetch.md step B). mc_filt holds two patch buffers (patch_buf on the write port, rbuf with the run); the sequencer starts a strip's run as soo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
2026-11-04 Frame-state loader group: the projection engine at one cell a cycle, both loaders with reads in flight (docs/frame-state.md §6)
    The 1080p measurement (docs/reference-prefetch.md §3) found the stage B loader group past 460k cycles a frame before the
    first tile: the motion-field clear wrote one entry a cycle (7 x w8 x h8 = 227k at 1080p), each valid cell took 11 cycles
    (up to 356k a source), and both loaders read one burst at a time (~64 cycles per 16 beats at the card's latency).
    - rtl/mf_band.sv: one memory per reference (we[6:0], w_row / w_col per reference at [16r +: 16]); the host's register path
    writes one reference (we = 1 << ref), the engine all seven in one cycle. Same bits of BR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
2026-11-04 host: time the waits on the frame-state loader group and the CDF save (card-load summary: host waits: loads Xs, CDF saves Ys). Measured 2026-11-03 on the TE=2 image, in_to_tree-aom.ivf 548 frames: lo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
2026-11-04 dec_host: the CDF save in 16-beat bursts with writes in flight
    The stage B save of the context tile's 1501 CDF rows went one row per round trip (read back, AW, 4 beats, wait for B),
    and the host waits on it between tile rows: 0.6 ms a frame measured on the U200 (tools/host/decode.py now reports the
    host's waits on the loader group and the save: loads 5.69 s, saves 0.32 s over 548 1080p frames). Rows are now read back
    one a cycle into a group of four (the read-back port's two-cycle latency pipelined by slot), each group goes out as one
    16-beat burst (split at 4 KB), and up to four bursts stay in flight (B responses counted, drained before done).
    Verified: dec_host_cardload at TS_AXI_LAT=48 T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
2026-11-04 docs/reference-prefetch.md: measured. Step A on the U200 at 100 MHz: in_to_tree-aom.ivf 548 frames 78.9 s = 6.9 fps (serial 3.5; 80 MHz serial 3.0), 500/500 identical; the phase fan-out miss and its 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
2026-11-04 docs/reference-prefetch.md: the 80 MHz prefetch row (92.2 s, 5.9 fps): A gains 2.0x at both clocks, 80 vs 100 MHz costs 17 %, the frame time scales with the clock now.
2026-11-04 host: --overlap reads each picture back in a thread while the card decodes the next frame (one frame of output lag; pool_target keeps the buffer of a picture still being read). Measured 2026-11-03 on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
2026-11-04 docs/reference-prefetch.md: section 7, the tile stage profiled (1080p frames 0 and 1 at the card memory timing): intra balanced with CfL 35 % of the reconstruction FSM; inter reconstruction-bound, sy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
2026-11-04 docs/reference-prefetch.md: section 7 finished (MC state and mc_filt breakdown, ref_fetch counters, RING=16: frame 1 -34 % / frame 2 -26 %, 11.6 fps on the card; the address-side pipeline is not a le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
2026-11-05 README roadmap item 7 + docs/FUTURE.md: what a product needs beyond conformance, as asked at the AOMedia symposium (2026-11-04): metadata OBU pass-through, render_size in the output stage, film grain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
2026-11-05 docs/FUTURE.md: sizing the decoder for silicon (130 nm proves blocks, 28 nm is the product)
2026-11-05 msac: copy the stage-1 CDF arrays element by element (s1_cur, s1_icdf). Yosys 0.55, which the Tiny Tapeout port reader and LibreLane 3.0.14 use, rejects a whole unpacked-array assignment (msac.sv:226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
2026-11-06 u200: program.sh binds the XDMA driver after the rescan (atium helper openav1-xdma-bind.sh; the udev rule never fired: its inline sh -c quoting reached the shell literally, exit 127, found after the 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
2026-11-07 recon_top: the inter-intra request waits for the filter and its blends to drain (filt_free)
    Since the block-ahead fetch (fc34a84) the sequencer reaches the next plane's B_MC_PL while the previous
    plane's run is still blending. The plane's intra prediction (intra engine, R_IP_W) and the run's blend
    writes (ob_wr_v / mb_b_v) share the fb4 write port; the always_comb gives the blend the port, so an intra
    write in the same cycle was dropped silently. B_MC_PL now issues ii_req only when filt_free, the gate
    B_MC_DRAIN already uses. Residual adds are safe (tx_take needs blk_ready, which follows filt_free).
    Census 7 (card-load, u200-fm2rf16s100p-b98724d, 2026-11-07): five Argon streams identical on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
2026-11-07 recon_top: simulation-only fatal when two sources claim a frame-memory port in one cycle (fb4 / fb2 writes, fb reads)
    The combinational block drives fb4, fb2 and fb from several places with last-assignment-wins, so two claims in one
    cycle are one access silently dropped. The census-7 bug (a40009e) was exactly that: since the block-ahead fetch the
    next plane's inter-intra intra write (R_IP_W) could meet the previous plane's blend write (ob_wr_v) on fb4. A
    $fatal under `ifndef SYNTHESIS now counts the claims of each port every cycle, so a twin or the nightly fails on
    the first collision whatever the pixels do.
    Checked both ways on Argon test7588_6663 frame 8 (stage-B twin, FBX/FBY 11, sb128):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
2026-11-07 tooling: frame-buffer write trace (TD_FBTRACE), ccache behind Verilator, tools/bisect_twin.sh
    - tb/test_dec_inter.py fb_trace + the TD_FBTRACE hook in test_dec_host_inter.py: every prediction write on fb4
    (plane, x, y, byte enables, data, the sequencer's live plane and state, which source drove it) plus the MC run
    starts and busy edges. It found the census-7 port collision in two runs (the intra write of plane 2 (0,79)
    missing from the list, the blend write of plane 1 in its cycle). TD_FBTRACE=<plane> filters, =all logs every plane.
    - env.sh exports OBJCACHE=ccache (CCACHE_DIR ~/.ccache-verilator) when ccache is installed: a repeated build of the
    same RTL + parameters in any worktree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
2026-11-07 nightly: the three long suites run as NIGHTLY_SHARDS parallel processes after one build (runsh)
    dec_inter (3 h), corpus_full_rtl (2 h) and argon_features (1 h) loop over many streams in one process and were
    the nightly's wall (~8 h). runsh builds once (TS_BUILD_ONLY=1), then splits the TS_IVF list round-robin over
    NIGHTLY_SHARDS processes (default 4), each in its own run directory (TS_TEST_DIR), and reports PASS only when
    every shard says OK (frames per shard in the summary line). Trial on argon_features with the port assertions
    in place: PASS 1787 s, frames 2 / 8 / 9 / 6 = the 25 of the serial run, which took 3740 s in the last nightly.
    The split is by stream count, so the longest shard set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
2026-11-08 u200: U200_TWIN=1 puts the Tiny Tapeout twin in the shell instead of the decoder
    With U200_TWIN=1 build.tcl keeps XDMA, the DDR4 bank and the MMCM (U200_MHZ=50 for the chip's clock) and instantiates
    tt_twin_v (the chip behind its 24 pins on two 32-bit GPIO words, the chip repo's fpga/kv260 wiring) with a dual-channel
    AXI GPIO at BAR0 offset 0 where dec_host sits otherwise; the memory smartconnect drops to one master (two clocks).
    Driven by the chip repo's fpga/u200/build.sh with U200_SOURCES = its sources. 2026-11-07, the day the KV260 died:
    the same register-driven twin, on the card; it found and then confirmed the fix of the self-test's first-run bug.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
2026-11-08 Twin profiling (TS_PERF): perf_report() runs on both tile-run paths (the cycle-accurate loop printed nothing before), state names come from the RTL enums (the hard-coded bst list ended before the MC 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
    (cherry picked from commit 47ac6bf1af564c8bf619a7671f531b077a3b3342)
2026-11-08 mc_filt: the second strip buffer starts at STRIP_LN (1136), not at bit 11: with the concatenated buffer bit its words fell outside the array, so every other run filtered garbage (unit test iter 0/7, 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
2026-11-09 Block-ahead step 1 fix: the transform FSM takes its neighbour availability from its own block record (tav_*) and the edge filter type from a per-parity register (ftq_*): with the next block taken ear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
2026-11-09 Block-ahead step 1 fix 2: rec_fifo counts a transform block in flight until reconstruction releases it (new tx_rel pulse at R_MIW through dec_top/tile_engines), not until its event is popped: with th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
2026-11-09 Block-ahead step 1 fix 3: during an inter-intra intra prediction (ii_run) the transform side reads the block FSM's record and edge filter type, not the last taken transform's block
2026-11-09 host: split the per-frame filter-tail timer into the frame-done wait and the DDR flush wait, and print the host phases per board frame (tiles, filter tail = frame done + flush, read-back, other host 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
2026-11-09 ref_fetch handover step C1: a request is accepted as soon as the address side is idle (the ring and the writer may still hold the previous request's rows), each row carries its request's geometry in 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
2026-11-09 Fetch handover step C2 (recon_top): the block FSM issues the next strip's fetch as soon as the engine accepted the previous one and queues the run, two deep (everything mc_filt samples at start plus 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
2026-11-09 Early block take: the block FSM takes the next block record past the transform events still queued for the current block (they wait for that block's prediction to land, which kept the next block behi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
2026-11-09 Early block take, two fixes from dec_top seed 3 (4:4:4, four tiles): (1) rec_fifo's scan for the next block record stops at a record already taken early, so the block FSM is never more than one block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
2026-11-09 Early block take: the inter-intra prediction request and the intra block copy wait while a transform event of an earlier block is still queued at the head (tx_pending_other): they read the reconstruc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
2026-11-10 Early block take: a block does not read as landed in a run start cycle
    pred_done dropped the queued-run term (pq_pend) at run_go but counted the run only a cycle later (runs_started follows mc_start), so the block read as landed for one cycle. The wedge mask fill of the next block holds only its first write on that signal: with the early block take the next block sits in B_MC_MASK at that moment, the fill started under the queued inter-intra run of the previous block and overwrote its mask (Argon test6641 frame 1: three wedge inter-intra blocks blended with the next block mask; dec_host_inter_argon). pred_done now stays low while mc_start is up for that parity.
    tb: TD_TAKETRACE (block takes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
2026-11-10 Declare before use everywhere: mc_filt v_hold was tied to 0 in the netlist
    recon_top connected mc_filt v_hold as (rs != R_IDLE) above the declarations of rs and its state enum. Verilator resolves that; Vivado makes implicit 1-bit nets with only a warning (Synth 8-6901), and the funcsim netlists of mc-block, mc-fetch2 and mc-take all carry .v_hold(1 b0): the vertical side of the filter was never held while the transform FSM writes the frame memory, in hardware, since the block-ahead merge (8191b6e). Three gate rungs passed over it; the fourth (mc-take, shard q2a) showed one transform event taken 36 cycles early in the netlist (rec_fifo ev_pop at vector 444904 vs 444940), found with a trace of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
2026-11-10 Two patch words a cycle: fetch writer, patch RAM and horizontal pass (rung A)
    The fetch writer, the patch RAM and the horizontal pass each moved one 4-sample word a cycle (2.34 M words on the 1080p frame). Rung A of docs/notes openav1-mc-datapath8:
    ref_fetch: the writer delivers a row in word pairs (patch_we2 / patch_d4b beside the even word; an odd count ends with a single). The address side takes two cycles a row instead of five: the first row address by the multiply, then a running sum (+ stride whenever the clamped source row advances); lead bytes and beats are per request (the stride is a multiple of 8).
    mc_filt: patch and strip buffers stored as pairs (an even and an odd memory, one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
2026-11-10 Vertical pass at two groups a cycle with an output FIFO (rung B)
    mc_filt: the vertical pass of an unscaled, non-warp run reads a strip pair a cycle and computes two groups a cycle (V_RUN2: second window, 32 more products); the parked list-0 prediction is stored and read as pairs. The frame memory still takes one 4-sample word a cycle (its second write port is the loop filter), so the outputs go through a FIFO of pair entries (256 entries of one or two words) and leave one word a cycle, in the order (g, i), (g + 1, i), (g, i + 1); the vertical side stalls while the FIFO is nearly full. done is an entry of the FIFO: it pulses after the last output word of the run has left; busy and v_active st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
2026-11-10 mc_filt: at most two runs alive
    recon_top keeps two run records selected by the one-bit tag. With the output FIFO a run still has words waiting after the vertical side has moved on, so a third run could start and take the record those words need: every inter suite failed (dec_host_inter inter2a frame 1, test10046 frame 2, test47 frame 9), and the 1080p profile hung. h_ready now also waits until fewer than two runs are alive (started, done not pulsed); a sim assertion guards it.
2026-11-10 Output FIFO: the first word of a run waits for the blend pipelines
    A run of the filter used to start its outputs at least 15 cycles after the last word of the previous run (drain + warm-up), so the read-modify-write blends of an OBMC / inter-intra / masked run, a few cycles behind their words, never met the direct writes of the next run on the frame-memory write port. Out of the FIFO the runs are back to back: dec_host_inter stopped on the sim assertion "fb4 write port claimed twice: mc 1 ob 1". recon_top passes out_wait (= its blend pipelines are not drained) and the FIFO holds the first word of a run while it is up; runs without blends cost nothing.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
2026-11-10 A run start waits while words of the record it would take are still in the blend pipelines
    The output path keeps two run records, selected by the one-bit tag, so the run after next reuses a record. The blend pipelines (OBMC, inter-intra, masked) read the record of their words for a few cycles after the run's last word. Since the output FIFO (rung B) mc_filt's done comes one cycle after the last word, the filter is ready for a start right behind it, and that start took the record while the last words were still in the pipelines: they were written with the next run's plane and origin.
    Found on the card: census 15 on the 86c2847 image had 30 Argon streams with differing samples (census 11: non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
2026-11-10 Nightly: two streams of card census 15 in the card's configuration; bisect twin defaults to it
    dec_host_census15 runs test5530 and test6687 through the dec_host twin with the card image's parameters (TE=2, REF_RING=8, sb128, FBX 11, stage B, pool 10). The run-record reuse fixed in d3ba9fd passed every suite and the gate rung and showed only on the card; test5530 fails on 86c2847 only with two tile engines. PASS on this commit in 452 s.
    tools/bisect_twin.sh now runs TE=2 REF_RING=8 unless told otherwise: three census-15 streams passed the one-engine twin on the broken commit.
2026-11-10 sr_top: the line buffer's write is registered (timing rung 1)
    In the 100 MHz image of 86c2847, 3,222 of the 4,364 failing setup endpoints were one family: the mirror frame memory's read data, from the UltraRAM output mux straight into the data pins of the super-resolution line buffer (LUT RAM with eight read ports), 8 levels, 9.5 ns of which 87 % routing, worst slack -0.614 ns. The copy states now load a write register (lw_v / lw_a / lw_d) and the write lands one cycle later; the first read of a row is in the second S_OUT cycle, the cycle after the row's last write.
    Suites on this change (tag t1sr): argon_features, dec_inter_lr, dec_host_inter_argon, dec_host_census15 PASS.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
2026-11-11 cfl, lr_top: frame-memory read data is registered before the CfL stores and the LR line buffer (timing rung 1)
    The same shape as the super-resolution line buffer, smaller: 76 failing endpoints at 100 MHz from the frame memory's select register into u_cfl's luma store and 65 from the mirror into u_lr's line buffer, 4 to 5 levels, 96 % routing, worst -0.475 and -0.514 ns.
    cfl: luma and dc are written from registers one cycle after luma_we / dc_we. recon_top raises start at the earliest the cycle after the last write and the first read (S_L) is the cycle after start.
    lr_top: the load's write (enable, slot, address, data) is registered. The last group of a row lands in the L_ROWS cycle after L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
2026-11-11 blk_syntax: the scanned neighbour's entry is registered before the warp sample's arithmetic (timing rung 2a)
    find_warp_samples took the MV memory's read data (3.7 ns after the clock: the UltraRAM cascade and a fan-out of 106) through the block-centre and difference adders, a DSP product and the ls_v accumulator in one cycle: 29 levels, 10.4 ns, -0.516 ns in the 100 MHz image of 86c2847, 85 failing endpoints. A new state S_WS_R registers the entry and its written bit (ws_ent, ws_wr); S_WS_P computes from the registers. One more cycle per scanned sample, at most eight samples a block.
    tile_syntax_inter and dec_inter_argon PASS (tag t2a).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
2026-11-11 mv_stack: the scanned entry is registered before the candidate logic (timing rung 2b)
    mv_mem's read data leaves its UltraRAM cascade 3.7 ns after the clock with a fan-out of 106, and the candidate compare and weight update behind it (st_row0, st_col0, weight) were the largest family left in the syntax stage in the 100 MHz image of 86c2847, about 300 failing endpoints. 88e3499 closes 100 MHz without this, at zero slack; this is margin.
    M_WAIT2 and M_EX_WAIT2 capture the entry and its written bit (ent_q, wr_q) and every consumer reads the registers. A scanned position takes four cycles, was three. In the 1080p frame-2 profile (perf1080-f2-dp8b3) the syntax stage is stalled on reconstruction f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
2026-11-11 decode.py --xdma --show: output pictures on the host's own screen (tools/host/fbshow.py)
    The card path had no screen (XdmaStage.show returned False). atium's P400 now drives the 7-inch panel through nouveau (nomodeset removed 2026-11-10), a 1024 x 600, 32-bit console framebuffer. fbshow.Screen maps /dev/fb0 and puts each output picture on it at emit time, in display order, 1:1 from the top-left corner (a larger picture shows its top-left part), from the planes decode.py reads back anyway: any bit depth, 4:2:0 / 4:4:4 / mono, BT.601 limited range as on the board. --show asks for the planes even without --ref / -o.
    On the card (u200-fm2rf8te2s100p-88e3499): in_to_tree_1080p50_20, 20 of 20 pic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
2026-11-11 Checkpoints: a table of card speed and chip usage per image, the fps chart drawn from it, the C10 layout picture
    docs/checkpoints/checkpoints.csv has one row per card image that decoded the reference clip (in_to_tree-aom.ivf, 1080p, 548 frames) faster than the one before: date, fps unchecked and checked, pictures identical, clock, image and commit, share of the xcu200's LUTs / registers / block RAM / UltraRAM / DSPs, and a layout picture from C10 on. Ten rows from the first full decode on 2026-10-30 (1.2 fps) to C10, u200-fm2rf8te2s100p-88e3499 (17.9 fps unchecked, 16.3 checked, 500 of 500 identical, 100 MHz, 35.6 % of the LUTs). The earlier rows come from the journals and the utilization re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
2026-11-11 README: current status shows the fps chart and the C10 layout, 1080p speed updated to 17.9 fps
    The status line still said 3.6 fps (2026-11-01). The chart and the placement picture come from docs/checkpoints.
2026-11-11 README: the speed line without the date and board
2026-11-11 cdef_top: the read data is registered before the window (timing rung 3)
    With the larger families gone, the mirror frame memory's UltraRAM output mux fanning straight into the 144 CDEF window registers was the biggest decoder group near the limit in the 100 MHz image of 88e3499: 667 endpoints within 0.3 ns of failing (5 levels, 87 % routing). The window load now lands three cycles after the read (rd4_q and the *3 tags) and C_WIN_LAST3 waits for the last group before the direction search; one more cycle per plane of a filtered 8x8 block.
    cdef_tb_top PASS; suites (tag t3): dec_top_small, dec_top_intra0, dec_top_large, dec_host_ring, corpus_full_rtl, dec_inter_lr PASS.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
2026-11-11 Nightly: NIGHTLY_PAR=<n> runs up to n suites at the same time, each in its own build directory
    The 22 suites ran one after another, 3.4 h on a 64-thread machine, from habit and from the days the CPU ran hot. With NIGHTLY_PAR set, run / runsh start each suite in the background (at most n at a time) and pass TS_BUILD_TAG = the suite's name; tb/runner.py appends it to the build directory, because the usual directory name leaves out INTER, TE, REF_RING, SB128 and two suites building in one directory collide. Result lines then come in finishing order and rc is counted from the FAIL lines. Default 1: unchanged behaviour.
    Validated on main acb1531 (known good): NIGHTLY_PAR=12, 22 PASS, DONE rc=0 i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
2026-11-11 decode.py --perf-tiles: per tile, the host's push and tile times beside the card's PERF_SYN / PERF_REC counters
    A measurement before the bitstream-over-DMA rung: whether the register-fed tile FIFO (about 1 MB/s) holds the decoder back, read from the card's own counters instead of the host profile. Off by default; two register reads per tile after tile done.
2026-11-11 cdef_top: per-state cycle histogram for simulation (TS_PERF), printed per frame by the dec_host inter twin
    Counters before the CDEF speed rung: the stage free-runs at about 155k cycles a 1080p superblock row (2.6 M a frame) against a tile stage of 2.8 M at ring 16, and three of its rows are the largest part of the frame's tail. Not in the netlist (ifndef SYNTHESIS).
2026-11-11 test_dec_host_inter: the CDEF histogram's delta no longer shadows the stream decoder (d)
    The TS_PERF print assigned d, the test's obu_parser.Decoder: the frame after the first printed one failed with AttributeError. Seen on the first run (frame 2 printed and identical, then the failure).
2026-11-11 cdef_top: unfiltered blocks are copied one group a cycle (was three cycles a group)
    The copy path read a group, waited and wrote it: 72 cycles for the 24 groups of an 8x8 block's three planes. On the 1080p clip's frame 2, 31,592 of 32,400 blocks are copies and the three copy states were 2,274,624 of the stage's 2,646,136 busy cycles. Now a read is issued every cycle and each group is written from the tag that travelled with it, two cycles behind (cpv/cpp/cpx/cpy); C_COPY_RDW and C_COPY_WR are gone.
2026-11-11 blk_syntax: the segmentation band word and its minimum are registered before sp_min (timing rung 5)
    The band memory's output through the 16 masked compares into sp_min's clock enable was 40 logic levels: the worst failing path of the ring-16 100 MHz image of f9bfa6e (-0.128 ns) and one of the 21 of the 7d1b595 image. S_SP_W now captures the word, S_SP_W1 its minimum over the block's columns, S_SP_W2 updates the running minimum: two more cycles per band word, only in frames that read the segmentation map of the previous frame.
2026-11-11 warp_setup: the block-centre products take the registered q[5] (timing rung 5)
    W_Q5 computed the last parameter and fed it straight into t_yb's multiplier: product register, rounding shift by divShift, clamp, subtract, DSP input, 32 logic levels; 26 of the 84 failing endpoints of the ring-16 image of f9bfa6e and 91 of the 165 of ring 12. W_T now forms the four products from q[2..5]: one more cycle per warp setup.
2026-11-11 frame_mem_uram: the request capture and the read select take a local two-stage copy of phase (timing rung 6)
    The clock generator's phase register enabled rq_* / wq_* and a_sel_q / b_sel_q in every frame memory directly: one clk2x period for a net from the shell across the die. 187 of the 191 failing endpoints of the ring-16 100 MHz image of 6fbf579 are these CE pins (one logic level, 97 % wire; worst -0.240 ns); the decoder's own logic met timing there. phm1 / phm2 equal phase exactly, as the per-UltraRAM ph1 / ph2 of 2026-11-03 do.
2026-11-12 frame_mem_uram: phm1 / phm2 declared outside the SYNTHESIS branch (the simulation build could not find phm2)
    9e125e3 put the local phase inside the ifdef SYNTHESIS part while the request capture below it is common to both builds: every simulation suite failed to build ('Can't find definition of variable: phm2'), the gate rung's twin with them. The synthesis build was unaffected.
2026-11-12 coef_rd: scan position read one coefficient ahead; a zero coefficient takes one cycle in the sign pass
    On the big frames of the 1080p clip the tile time is the coefficient reader: frame 14 has 468,363 coefficients at ten cycles each (six in the level pass, four in the sign pass) = about 5.0 M of its 8.59 M tile cycles. Two of the six and two of the four were the scan ROM lookup, repeated for every coefficient, and the sign pass spent its four cycles on zero coefficients as well.
    The ROM is now addressed with the coefficient that follows the current one, so its position is at the output when the pass moves on: the level pass is L_CTX, L_BASE_W, L_STORE per coefficient, the sign pass P_CHK, P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
2026-11-13 Checkpoint C14: 21.3 fps unchecked (18.9 checked) with u200-fm2rf16te2s100p-92aa6af
    Step 2 of the coefficient reader on the card at 100 MHz, reference ring 16 (WNS 0.007 ns, 0 failing endpoints): census 301/0/463, both clips identical, measured on an idle host. A small step on the clip mean (tile phase 39.5 -> 39.1 ms a frame). Row, layout picture, chart (the annotation moves from C13 to C14), README speed line.
2026-11-13 mc_filt: warp strips take the pair path (two patch words and two strip groups a cycle)
    Rungs A and B doubled the filter's rate for unscaled runs but left the warp path at one patch word a cycle in the horizontal pass and one group a cycle in the vertical pass: a warp strip (15 x 8, then 8 x 8) took exactly 60 + 30 cycles where the pair path needs 30 + 15. On the 1080p clip 45 % of frame 2's strips and 65 % of frame 14's are warp strips (H_RUN 1,657,020 and V_RUN 828,510 cycles of frame 14's 6.6 M tile).
    Warp runs now use H_RUN2 / V_RUN2. The odd group of a pair gets its own taps (htapb, vtapb): the run's phase for an unscaled run, a filter row per sample for a warp run. H_RUN and V_RUN are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
2026-11-13 dec_host: streamed picture flush (a group request a cycle, bursts do not wait for B)
    The flush read two sample groups, wrote one beat and started over: 5 cycles a beat, and every 16-beat burst waited for its write response. A 1080p superblock row (184,320 bytes) took about 1.05 ms, and the last two rows of a frame flush after the filters are done: 2.3 ms of the frame in simulation, 3.0 ms on the card.
    The read side now asks the window memory for a group every cycle and packs the answers into beats in a 16-beat FIFO; a group the memory did not serve (h_ok low) restarts the stream from that group. The write side sends beats as they come, counts the responses it is owed (at most 8 bursts in fl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
2026-11-13 Deblocking starts a row earlier: intra edge reads of a superblock row's last line come from an unfiltered copy
    The frame sequencer held deblocking of superblock row r until row r+1 was reconstructed, because the filter's vertical edges change row r's last line in place and row r+1's intra prediction reads that line from the frame memory. Every later stage inherits the lag, and after the last tile it is one more serial CDEF row.
    edge_line keeps the reconstruction stage's writes to each superblock row's last line (two copies by row parity, three planes, groups of four with lane enables). recon_top marks its intra edge reads (fb_edge); a read of a last line is answered from the copy with the f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
2026-11-13 dec_top: sim-only count of last-line edge reads that differ from the frame memory
2026-11-13 docs: 4K60 budget, stage by stage (2026-11-13)
    Where each stage stands against 746.5 M samples a second: measured samples per cycle for the tile engine, the three in-loop filters and the card, the strip-trace totals of the MC chain, a header census of nine real 4K streams (all tiled, loop filter nearly always on), memory and DDR arithmetic, a ranking, and what is not measured yet.
2026-11-13 docs: streaming filter chain, a proposal (sketch, no RTL)
    The in-loop filters leave the picture buffers: tile engines -> a two-row pre-filter row store -> deblock -> CDEF -> super-res -> restoration -> writer on the wide DDR port, each stage keeping only its context lines. What each stage holds, rates, memory at 4K width, what to check before RTL, and how it lands beside the current path.
2026-11-13 Deblocking stage model: band by band with 8 context lines, checked against the specification order
2026-11-13 CDEF stage model (lines in, lines out, a window of deblocked lines) and the chain check
2026-11-13 CDEF stage model: measure the lines carried between calls
2026-11-13 docs/filter-chain: what the stage models have confirmed so far
2026-11-13 Restoration stage model (CDEF lines + stripe boundary lines of the deblocked picture) in the chain check
2026-11-13 docs/filter-chain: restoration stage confirmed in the model
2026-11-13 Chain model as a module with a per-frame check; TS_CHAIN_CHECK=1 runs it on every frame the decoder test benches filter
2026-11-13 chain check: report its per-stage counts in the suite's stats
2026-11-13 Chain model: super-resolution line by line between CDEF and restoration (superres_model.upscale_row); restoration compared on super-res frames too
2026-11-13 docs/filter-chain: first cut of the deblock stage's hardware
2026-11-13 docs/filter-chain: inter frames and super-res confirmed in the chain model
2026-11-13 Deblock stage model with an explicit window of four block columns
2026-11-13 docs/filter-chain: the deblock stage's four-column window confirmed in the model
2026-11-13 lf_filt: the deblocking sample filter as a combinational module, fuzzed against lf_model
2026-11-13 test_lf_filt: count the filter the model applied; every outcome must occur
2026-11-13 lf_stream: the streaming deblock stage (one plane, a band at a time, one 4x4 block a clock) with its unit test
2026-11-13 lf_stream: sample assembly and result merge in separate blocks (no false combinational loop)
2026-11-13 lf_stream_unit: seeds where the last block column's vertical edge changes samples
    The first seed list and the real streams' frame 0 pass with that edge disabled (no sample depends on it there).
2026-11-13 docs/filter-chain: what is built of the deblock stage
2026-11-13 lf_edge_argon: frame 0s of three Argon streams where the level fallback matters; the unit tests take .obu streams
2026-11-13 lf_edge vectors from the decoder test benches (TS_LF_VEC_OUT) and their replay in test_lf_edge (TS_LF_VEC): inter frames
2026-11-13 lf_edge_inter: six dumped inter frames kept in the repo and replayed nightly
2026-11-14 lf_feed (mode info and blocks into lf_stream, strengths from lf_edge) and the stage's test wrapper; not simulated yet
2026-11-14 Checkpoint C15: 25.2 fps unchecked (21.8 checked) with u200-fm2rf16te2s100p-0e4709b
    The streamed picture flush and deblocking a row earlier on the card at 100 MHz, reference ring 16 (WNS 0.002 ns, 0 failing endpoints): census 301/0/463, both clips identical, measured on an idle host. The filter tail falls from 7.7 to 4.0 ms a frame and the tile phase from 39.1 to 35.7 ms. Row, layout picture, chart (the annotation moves from C14 to C15), README speed line.
2026-11-14 docs/filter-chain: lf_edge and lf_feed built; the stage runs from mode info alone
2026-11-14 synth/vivado/run.sh: the deblock stage's modules in the file list (block synthesis of lf_stream / lf_feed)
2026-11-14 lf_filt: optional two-stage form (PIPE), tested with scrambled inputs after the stage is clocked
2026-11-14 lf_stream_short / lf_stage_short: frames whose last band is shorter than the stage's pipeline
2026-11-14 docs/filter-chain: the pipelined deblock stage and its synthesis figures
2026-11-14 docs/filter-chain: whole-stage and chroma-only synthesis figures
2026-11-14 tests: the output handshake is sampled as the next clock edge sees it
2026-11-14 CDEF stage model with an explicit column window (12 luma columns a block)
2026-11-14 docs/filter-chain: CDEF column window confirmed; check script label
2026-11-14 cdef_row: cdef_top's sample filter pipeline lifted out with N lanes, fuzzed against cdef_model
2026-11-14 docs/filter-chain: CDEF pieces built and the plan for the stage
2026-11-14 cdef_stream: first cut of the streaming CDEF stage (luma) and its unit test; not simulated yet
2026-11-14 CDEF stage frames from the decoder test benches (TS_CDEF_VEC_OUT) and their replay (TS_CDEF_VEC): inter frames with unfiltered blocks
2026-11-14 cdef_stream_inter: six dumped inter frames kept in the repo and replayed nightly
2026-11-14 docs/filter-chain: the CDEF stage's first cut
2026-11-14 docs/filter-chain: CDEF chroma and synthesis figures
2026-11-14 cdef_stream_fmt: 4:4:4 and 4:2:2 frames for the CDEF stage
2026-11-14 cdef_stream: look-ahead: the next block is prepared during the current block's lines (eight clocks a block inside a column)
2026-11-14 test_cdef_stream: the mode-info answers come one clock after the address, as mi_store's registered reads do
    The responder answered within the same clock; the stage's sequential path then read the four skip flags in a rotated order (all four, so it passed) and the look-ahead path missed one (caught by cdef_stream_inter).
2026-11-14 docs/filter-chain: CDEF look-ahead, measured rate, the test latency bug
2026-11-14 docs/4k60-budget: which filters and how many tiles real streams and the common encoders use
2026-11-14 timing_census.py: an endpoint without a block path no longer stops the grouping
    Seen on the 125 MHz probe of main (17,257 failing endpoints, one of them a top-level register).
2026-11-14 lr_wiener: the Wiener filter as line modules (horizontal, vertical) with N lanes, fuzzed against lr_model
2026-11-14 lr_stream: Wiener restoration stage of the streaming filter chain (simulation only)
    One plane, a band at a time, in cdef_stream's column order: four rotating column
    buffers, lines through lr_wiener_h / lr_wiener_v one a clock, the stripe rule by
    re-seeding the line shift register from the deblocked boundary lines, units read
    at every stripe start, six intermediate and three source lines carried per column
    between bands. Self-guided units pass through unchanged for now; no super-res.
    tb/test_lr_stream.py: made-up pictures and unit maps against lr_model (stripes,
    units, borders, bands, planes ending near a stripe boundary); 17 mutations fail.
    Nightly suite lr_stream_unit.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
2026-11-14 docs/filter-chain.md: the restoration stage as built
2026-11-14 lr_stream: self-guided units (correct, slow); lr_bstore: the boundary line store (simulation only)
    - lr_sgr_ab (a2 / b2 of a box position, four clocks) and lr_sgr_f (a line from three rows of a2 / b2, three clocks): lr_top's self-guided arithmetic lifted out. lr_stream sends a self-guided unit's lines to a sequential engine (about 31 clocks a line against 1.4 for Wiener) and carries six source lines between bands for such a column.
    - lr_bstore keeps the four deblocked lines around each stripe boundary out of the deblock stage's block stream, four boundaries at a time; lr_stage_tb_top = lr_stream + lr_bstore.
    - Suites: lr_sgr_ab_unit, lr_stage_unit (new), lr_stream_unit now with self-guided u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
2026-11-14 wip: fc_plane (one plane of the chain), fc_lfifo, cdef_stream col_hold, test_fc_plane (not run yet)
2026-11-14 fc_plane / fc_top: the three filter stages joined, per plane and for a picture (simulation only)
    - fc_plane: lf_feed + lf_stream -> cdef_stream -> a FIFO of lines -> lr_stream, with lr_bstore on the deblock stage's output; switches for a filter that is off. cdef_stream: col_hold (a block column starts only when the taker has room for its lines) and col_next.
    - fc_top: an fc_plane per plane on the same band, luma's CDEF directions handed to chroma through a small memory, chroma held behind luma.
    - Tests against lf_model -> cdef_model -> lr_model with only what the decoder has (test_fc_plane, test_fc_top; wrappers with mi_store and block memories); six suites in the nightly.
    - docs/filter-chai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
2026-11-14 docs/filter-chain: the chain's synthesis figures by stage
2026-11-14 cdef_stream: chroma takes luma's record (filtered, cdef_idx, direction), one-row blocks every four clocks
    A chroma stage reads one record a block from the luma stage's store and nothing from mi_store; blocks one 4x4 row high have their own look-ahead. Suites on the worktree before this commit's docs: cdef_stream_unit / inter / fmt and the six fc suites PASS; 13 of 15 faults fail, one equivalent, one invalid (docs/filter-chain.md). The chain on six real frames: 4.4 -> 5.4 samples a clock.
2026-11-14 test_fc_top: per-stage timing (FC_PROF); docs/4k60-budget: the chain's first measured rate
2026-11-14 fc_plane / lr_stream: the chain's output can be held (out_hold), at most 5 lines follow
2026-11-14 docs/filter-chain: the LUT RAM in the chain's synthesis is the K26 part running out of block RAM
2026-11-14 fc_rstore: the chain's row store as a block-organised mirror of reconstruction's writes (simulation only)
2026-11-14 fc_out: the chain's line segments into two frame-memory write ports (simulation only)
